bearjhartjen/Lamoka1-half/README.md

<h1 align="center">
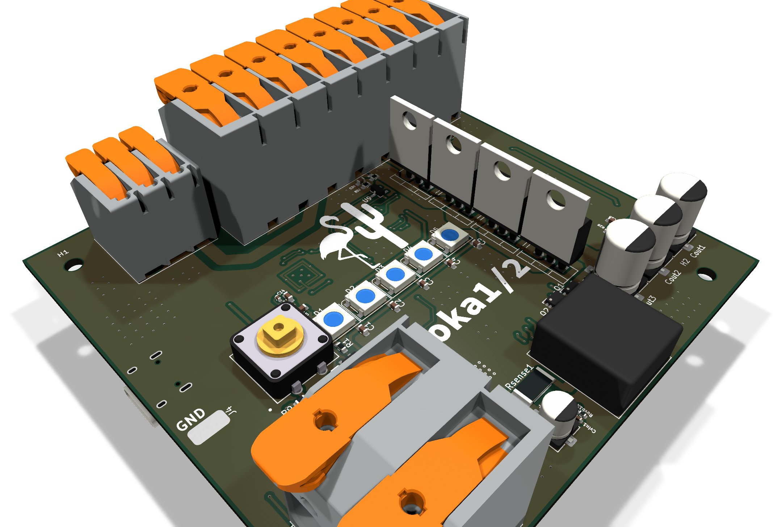
[picture p1: Images/lamoka1-2-render-iso.png]
Lamoka1/2
  
  <br>
  Lamoka1/2
</h1>

<p align="center">
  PIE v1.9 works on this board.
  For more information on PIE, go
  <a href="SOFTWARE/README.md">here</a>.
</p>

<p align="center">
  <a href="https://htmlpreview.github.io/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">
    <strong>View Interactive BOM</strong>
  </a>
</p>

---
