bearjhartjen/Lamoka1-half/HARDWARE/Kicadfiles/Lamoka1-half/Reviews/Tomachie report in depth.txt

Generated by Tomachie v5.142 2026-10-19 23:12:50
Copyright © 2026 Tomachie LLC. All rights reserved.

Lamoka1-half Design Analysis
Job 0a968485
1  Design Summary

  93
  out of 100

Design TypeHierarchical (4 sheets)
Total Components117
Total Pins495
Total Nets84
Total Test Points0

Improve your score:

Improve solder-joint testability (opens/shorts) +2
Add test points on power rails +1
Add test points on switch signals +1
Improve JTAG/I2C/SPI bus accessibility +1
Use IPC-compliant footprint names +1
Add Kelvin 4-wire test points on sense resistors +1

Based on user-selected TP insertion settings, 18 test point(s) were added and a modified design is available for download. Review the modified schematic and resubmit to update this report.
1.1  Processed Sheets

#Sheet Name

1Lamoka1-half.kicad_sch
2Control-section.kicad_sch
3Inversion-section.kicad_sch
4User-Interface-Section.kicad_sch

1.2  Footprint Compliance
Production pick-n-place, AOI, AXI, ATE and Design Quality tools rely on proper descriptions of component footprints.

✗2✓1

Footprint NamingStatus

2 of 42 unique footprints are IPC-7351B or IPC-7251✓
35 SMT footprints do not follow IPC-7351B naming
4 footprints (connectors, specialty) — compliance unknown
1 footprints could not be classified for inspection

2  Component Value Properties
Component values should be in the VALUE property, either as a direct value (e.g. 100nF) or as a formula reference (e.g. =Capacitance). The typed property (Resistance, Capacitance, Inductance, Impedance, etc.) holds the actual electrical value; VALUE should point to it or contain the same data.

✓4

Value Property Check

TypeCheckCountComponentsStatus

CapacitorsValues in VALUE or Capacitance38Cres1, C23, C22, Ccomp2, C32, Cin1, Ccomp1, Coutx1 (+30 more)✓
ResistorsValues in VALUE or Resistance38RCS1, R10, R17, Ruvb1, R18, Rfbb1, R12, Rcomp1 (+30 more)✓
InductorsValues in VALUE or Inductance3L2, L1, L3✓
OscillatorsValues in VALUE or Frequency1X1✓

2.1  Part Number vs Stated Values
Each passive states its electrical facts twice: in the properties the designer set, and encoded inside the MANUFACTURER part number. This check decodes the manufacturer part number and compares the two. A distributor catalogue number is a different thing and cannot be used here - an LCSC C-number or a Digi-Key -ND number identifies a stock item, it encodes no capacitance, voltage or tolerance, so there is nothing in it to check against. Where the two readings disagree both are shown and neither is assumed correct: if VALUE is wrong the analysis used the wrong number, and if the part number is wrong the BOM orders the wrong part. Only the designer knows which field is authoritative. Parts whose numbering scheme is not recognized are reported as not checked rather than passed.

✓26

Part NumberDecoded from Part NumberStated on SchematicWhat DiffersCountComponentsStatus

RC0603FR-0710KLMPN / Yageo RC060310k +/-1% 060310k: R8, R9, R26, R28, R30, R32Nothing - all stated values agree6R8, R9, R26, R28, R30, R32✓ Match
CL10B104KO8NNNCMPN / Samsung Electro-Mechanics100nF 16V +/-10% 0603100n: C1, C2, C3, C4, C5Nothing - all stated values agree5C1, C2, C3, C4, C5✓ Match
CL10B473KB8NNNCMPN / Samsung Electro-Mechanics47nF 50V +/-10% 060347nF: C27, C28, C29, C30Nothing - all stated values agree4C27, C28, C29, C30✓ Match
RC1206FR-0710RLMPN / Yageo RC120610R +/-1% 120610: R10, R12, R17, R18Nothing - all stated values agree4R10, R12, R17, R18✓ Match
25SVPF180MMPN / Panasonic Industry180uF 25V +/-20%180uF: Cout1, Cout2, Cout3Nothing - all stated values agree3Cout1, Cout2, Cout3✓ Match
CL05B104KO5NNNCMPN / Samsung Electro-Mechanics100nF 16V +/-10% 0402100n: C17, C18, C19Nothing - all stated values agree3C17, C18, C19✓ Match
CL10A475KP8NNNCMPN / Samsung Electro-Mechanics4.7uF 10V +/-10% 06034.7u: C14, C15, C16Nothing - all stated values agree3C14, C15, C16✓ Match
0402CG150J500NTMPN / Fenghua (suffix heuristic)15pF 50V +/-5% 040215p: C20, C21Nothing - all stated values agree2C20, C21✓ Match
CL05A106MQ5NUNCMPN / Samsung Electro-Mechanics10uF 6.3V +/-20% 040210u: C12, C13Nothing - all stated values agree2C12, C13✓ Match
CRCW040249K9FKEDMPN / Vishay Dale CRCW040249.9k +/-1% 040249.9k: Rfbt1, Ruvt1Nothing - all stated values agree2Rfbt1, Ruvt1✓ Match
GRM21BR71H105KA12LMPN / Murata1uF 50V +/-10% 08051uF: C22, C23Nothing - all stated values agree2C22, C23✓ Match
RC0402FR-071KLMPN / Yageo RC04021k +/-1% 04021k: R7, R11Nothing - all stated values agree2R7, R11✓ Match
RC0603FR-0727RLMPN / Yageo RC060327R +/-1% 060327: R5, R6Nothing - all stated values agree2R5, R6✓ Match
RC0603FR-0745K3LMPN / Yageo RC060345.3k +/-1% 060345.3k: R29, R31Nothing - all stated values agree2R29, R31✓ Match
RC0603FR-074K7LMPN / Yageo RC06034.7k +/-1% 06034.7k: R23, R24Nothing - all stated values agree2R23, R24✓ Match
RC0603FR-075K1LMPN / Yageo RC06035.1k +/-1% 06035.1k: R2, R3Nothing - all stated values agree2R2, R3✓ Match
08053C104KAT2AMPN / AVX100nF 25V +/-10% 0805100nF: C32Nothing - all stated values agree1C32✓ Match
20SVPF56MXMPN / Panasonic Industry56uF 20V +/-20%56uF: Cin1Nothing - all stated values agree1Cin1✓ Match
AOTA-B201610S3R3-101-TMPN / AOTA AOTA-B201610S3.3uH3.3u: L1Nothing - all stated values agree1L1✓ Match
C1005X5R1V474K050BCMPN / TDK470nF 35V +/-10% 0402470nF: Cvin1Nothing - all stated values agree1Cvin1✓ Match
C3216X5R1E476M160ACMPN / TDK47uF 25V +/-20% 120647uF: Coutx1Nothing - all stated values agree1Coutx1✓ Match
CGA4C2C0G1H392J060AAMPN / TDK (CGA automotive)3.9nF 50V +/-5%3.9nF: Ccomp1Nothing - all stated values agree1Ccomp1✓ Match
CL10A105KA8NNNCMPN / Samsung Electro-Mechanics1uF 25V +/-10% 06031uF: C26Nothing - all stated values agree1C26✓ Match
CL10B104KB8NNNCMPN / Samsung Electro-Mechanics100nF 50V +/-10% 0603100nF: C31Nothing - all stated values agree1C31✓ Match
CRCW0402100KFKEDMPN / Vishay Dale CRCW0402100k +/-1% 0402100k: R21Nothing - all stated values agree1R21✓ Match
+22 more part number(s) cross-checked, all agreeNothing - all stated values agree22✓ Match
ResistorsCSNL2512FT2L002 part(s) carry a manufacturer part number that will be decoded on a paid enriched run, where the value, voltage and tolerance it encodes are checked against the schematic.2RCS1, Rsense1◆

2.2  Part Lifecycle and Silicon Errata
Status as found on the manufacturer's website by the AI enrichment run, on the date shown; the page read is linked. Silicon errata: whether the manufacturer publishes an errata sheet for the part - its presence only. No errata document is read or analysed, and no action is implied by its existence.

Finding accurate?

ItemLifecycleSilicon errataStatus

IC1 (INA240A2DR), U1 (RP2354A), U2 (AMS1117-3.3), U3 (SN74AHCT1G125DBVR), U4 (LM5122MHX/NOPB), U5, U6 (UCC27735DR), U7 (TPS62160DSGR), U8, U9 (TMP235A2DBZR), U10 (ADS7128IRTER)Lifecycle status and errata status determined on an AI enrichmentNot determinedReview
C1, C2, C3, C4, C5 (CL10B104KO8NNNC), C11 (GRM31CR61A107MEA8K), C12, C13 (CL05A106MQ5NUNC), C24 (TMK212BBJ106KG-T), C25 (GRM31CR71A226KE15L), C33 (MSAST21GAB5475MTNAO1), CR1, CR2, D11, D12 (SS14-E3/61T), Cin1 (20SVPF56MX), Cvin1 (C1005X5R1V474K050BC), D1, D2, D3, D4, D5 (WS2812B), D6 (SK215ATR), L2 (XAL1580-182MEB), ...Lifecycle status determined on an AI enrichment—Review
C14, C15, C16 (CL10A475KP8NNNC)There isn't a life-cycle marking on the datasheet obtained 2026-10-13—
C17, C18, C19 (CL05B104KO5NNNC)Active, as of 2026-10-14—
L1 (AOTA-B201610S3R3-101-T)Active, as of 2026-09-05—
X1 (ABM8-272-T3)Active, as of 2026-09-16None found on the manufacturer's website, as of 2026-09-16

3  Pin Connectivity Report
3.1  Unconnected Pins
Unconnected pins that are not marked NO_ERC.
11 unconnected pin(s) found:
11 unconnected pin(s) — all are electrical types that are safe to leave open (Bidirectional, Output, Passive, High-Impedance, or Unspecified). Common on partially-populated bus connectors (VME, backplanes, expansion headers) and on outputs whose consumer was omitted. Review to confirm intent, but no action is required by default.

Refdes_PinPin FunctionPin PropertyDevice TypeNet NameNotes

IC1_4NCUnknownINA240A2DR-No net
J3_SHSHIELDPassiveUSB_C_Receptacle_USB2.0_14PNet-(J3-SHIELD)
R9_1-Passive10kUser-Interface-Section/3v3
U5_8NCUnknownUCC27735DR-No net
U5_9NCUnknownUCC27735DR-No net
U5_10NCUnknownUCC27735DR-No net
U5_14NCUnknownUCC27735DR-No net
U6_8NCUnknownUCC27735DR-No net
U6_9NCUnknownUCC27735DR-No net
U6_10NCUnknownUCC27735DR-No net
U6_14NCUnknownUCC27735DR-No net

3.2  Implied/Hidden Net Connections
Pins with implied net connections not visible on the schematic. Includes Altium HiddenNetName library parameters and KiCad hidden pins of any electrical type stacked behind visible pins in the symbol.

Implied Net Connections

ComponentTypePinNetStatus

U1RP2354A39 (DVDD)Control-Section/1V1Hidden pin not visible on schematic
U1RP2354A11 (IOVDD)Control-Section/3v3Hidden pin not visible on schematic
U1RP2354A20 (IOVDD)Control-Section/3v3Hidden pin not visible on schematic
U1RP2354A23 (DVDD)Control-Section/1V1Hidden pin not visible on schematic
U1RP2354A45 (IOVDD)Control-Section/3v3Hidden pin not visible on schematic
U1RP2354A30 (IOVDD)Control-Section/3v3Hidden pin not visible on schematic
U1RP2354A38 (IOVDD)Control-Section/3v3Hidden pin not visible on schematic
J3USB_C_Receptacle_USB2.0_14PA9 (VBUS)Control-Section/USB-5vHidden pin not visible on schematic
J3USB_C_Receptacle_USB2.0_14PB1 (GND)Net-(J3-GND-PadA1)Hidden pin not visible on schematic
J3USB_C_Receptacle_USB2.0_14PA12 (GND)Net-(J3-GND-PadA1)Hidden pin not visible on schematic
J3USB_C_Receptacle_USB2.0_14PB4 (VBUS)Control-Section/USB-5vHidden pin not visible on schematic
J3USB_C_Receptacle_USB2.0_14PB9 (VBUS)Control-Section/USB-5vHidden pin not visible on schematic
J3USB_C_Receptacle_USB2.0_14PB12 (GND)Net-(J3-GND-PadA1)Hidden pin not visible on schematic

3.3  Open-Collector Pull-up Audit
Examined 1 candidate pin(s) on 1 net(s). 1 passing.

These open-collector / open-drain outputs have a resistor pull-up to a power rail. The pull-up resistor and rail are shown for reference.

NetOC Pin(s)Pull-upRailStatus

Control-Section/PGU7_8 (PG)R21Control-Section/Buck-5v✓

3.4  Diode Polarity / Orientation

Finding accurate?

Diode polarity and orientation are read from the schematic. IPC-7351B (surface mount) / IPC-7251 (through-hole) Zero Component Orientation (ZCO) requires pin 1, the cathode, on the left with the footprint at zero rotation. Tomachie calls out symbols that do not meet ZCO because the PCB layout may have an error, assembly may insert the part backwards, initial ATE test generation from a netlist of only pins 1 and 2 will fail, or a novice may wrongly indict a correct part — consistency is the least-expensive path for everyone who handles the PCB.

DiodeConnectionsOrientationSeverity

D12SS14-E3/61Tunidirectional · pin_names · Schottky RectifierPin 1 (K): HB2Pin 2 (A): CSPConsistent
D6SK215ATRunidirectional · pin_namesPin 1 (K): BSTPin 2 (A): VCCConsistent
D11SS14-E3/61Tunidirectional · pin_names · Schottky RectifierPin 1 (K): HB1Pin 2 (A): CSPConsistent
CR1SS14-E3/61Tunidirectional · symbol_graphic · Schottky RectifierPin 1 (K): Control-Section/5VPin 2 (A): Control-Section/USB-5vConsistent
CR2SS14-E3/61Tunidirectional · symbol_graphic · Schottky RectifierPin 1 (K): Control-Section/5VPin 2 (A): Control-Section/Buck-5vConsistent
D1WS2812Barray · multi-pinPin 1 (VDD): Control-Section/5VPin 2 (DOUT): Net-(D1-DOUT)Pin 3 (VSS): GNDPin 4 (DIN): Net-(D1-DIN)4-pin diode package will need to be checked against the datasheet in one of the AI enrichment sections.Information
D5WS2812Barray · multi-pinPin 1 (VDD): Control-Section/5VPin 2 (DOUT): -Pin 3 (VSS): GNDPin 4 (DIN): Net-(D4-DOUT)4-pin diode package will need to be checked against the datasheet in one of the AI enrichment sections.Information
D2WS2812Barray · multi-pinPin 1 (VDD): Control-Section/5VPin 2 (DOUT): Net-(D2-DOUT)Pin 3 (VSS): GNDPin 4 (DIN): Net-(D1-DOUT)4-pin diode package will need to be checked against the datasheet in one of the AI enrichment sections.Information
D3WS2812Barray · multi-pinPin 1 (VDD): Control-Section/5VPin 2 (DOUT): Net-(D3-DOUT)Pin 3 (VSS): GNDPin 4 (DIN): Net-(D2-DOUT)4-pin diode package will need to be checked against the datasheet in one of the AI enrichment sections.Information
D4WS2812Barray · multi-pinPin 1 (VDD): Control-Section/5VPin 2 (DOUT): Net-(D4-DOUT)Pin 3 (VSS): GNDPin 4 (DIN): Net-(D3-DOUT)4-pin diode package will need to be checked against the datasheet in one of the AI enrichment sections.Information

3.5  Power Symbols That Connect Nothing
4 power symbol placement(s) connect nothing: the placed symbol has no library definition in the schematic file, or its definition has no power pin. A power symbol joins all same-named rails across the design; an inert one leaves them separate. Where the last column lists more than one net, those nets were meant to be one rail and are NOT connected. Restore the power symbol's library definition (re-place it from a maintained library) and verify the rails merge.

Power NetLibrary CellPlacementsNets Left Separate

LOGOFlamingo&Cactus-logo:LOGO4 (Lamoka1-half.kicad_sch, Inversion-section.kicad_sch, Control-section.kicad_sch, User-Interface-Section.kicad_sch)-

3.6  Checks Not Performed
Items this report did not check, with the reason. None of these is a finding against the design - an item that was not checked says nothing about it either way.
Note 1: This check was not performed because this is a preliminary run. An AI enrichment run is needed a) for the analysis and b) to obtain the datasheet from public sources, or from the "datasheets" subfolder of the project when the user supplies it because no public source exists.

ItemNot checkedNotes

Capacitor Derating CheckNot performed on preliminary runSee note 1
CR1 (SS14-E3/61T)Power analysis not performed on preliminary runSee note 1
CR2 (SS14-E3/61T)Power analysis not performed on preliminary runSee note 1
D1 (WS2812B)Power analysis not performed on preliminary runSee note 1
D2 (WS2812B)Power analysis not performed on preliminary runSee note 1
D3 (WS2812B)Power analysis not performed on preliminary runSee note 1
D4 (WS2812B)Power analysis not performed on preliminary runSee note 1
D5 (WS2812B)Power analysis not performed on preliminary runSee note 1
D6 (SK215ATR)Power analysis not performed on preliminary runSee note 1
D11 (SS14-E3/61T)Power analysis not performed on preliminary runSee note 1
D12 (SS14-E3/61T)Power analysis not performed on preliminary runSee note 1
IC1 (INA240A2DR)Power analysis not performed on preliminary runSee note 1
Q2 (CSD17304Q3)Power analysis not performed on preliminary runSee note 1
Q5 (CSD19536KCS)Power analysis not performed on preliminary runSee note 1
Q6 (CSD19536KCS)Power analysis not performed on preliminary runSee note 1
U2 (AMS1117-3.3)Power analysis not performed on preliminary runSee note 1
U4 (LM5122MHX/NOPB)Power analysis not performed on preliminary runSee note 1
U5 (UCC27735DR)Power analysis not performed on preliminary runSee note 1
U6 (UCC27735DR)Power analysis not performed on preliminary runSee note 1
U7 (TPS62160DSGR)Power analysis not performed on preliminary runSee note 1
Q1 (CSD16323Q3)Functional analysis not performed on preliminary runSee note 1
Q3 (CSD19536KCS)Functional analysis not performed on preliminary runSee note 1
Q4 (CSD19536KCS)Functional analysis not performed on preliminary runSee note 1
U1 (RP2354A)Functional analysis not performed on preliminary runSee note 1
U3 (SN74AHCT1G125DBVR)Functional analysis not performed on preliminary runSee note 1
U8 (TMP235A2DBZR)Functional analysis not performed on preliminary runSee note 1
U9 (TMP235A2DBZR)Functional analysis not performed on preliminary runSee note 1
U10 (ADS7128IRTER)Functional analysis not performed on preliminary runSee note 1
X1 (ABM8-272-T3)Functional analysis not performed on preliminary runSee note 1
RCS1, Rsense12 part(s) use 1 numbering scheme(s) whose ordering information could not be obtained in this run, so their value, voltage and tolerance were not cross-checked against the part number. Nothing is wrong with these parts.

3.7  Designer Notes
These notes will be supplied on an AI enrichment.
Assign each note to a device or a net name rather than leaving it as free-floating text, for example "Q1 = Vgs = 1.8V" or "VCC_IN = 4.5 to 5V". Avoid "current here = 1mA" or "current = 1mA": "here" is not understood, the second does not say where the current is, and Tomachie does not use the position of text on the sheet to guess what it refers to.

SheetNotes

Control-section11-14v to 5v
Control-sectionDiode-Power OR-ing
Inversion-section11-14v to 17v
Lamoka1-halfThis is the output of the transformer,
Lamoka1-halfWago-connector 2606-1108/010-000
Lamoka1-halfWago-connector 2604-1103
Lamoka1-halfWago-connector 2606-1352
Lamoka1-halfwe will be hooking it up to a NEMA 5-15 plug.

3.8  Summary

Total NO_ERC markers in design34
Pins needing attention (warnings)11
Pins for information only0

4  Power Overview

Power rails12
Power management sources identified6

Power architecture overview. For test point coverage, see Design-for-Test section.
4.1  Power Rail Analysis

Power Rails

RailVoltageSourceConsumers

Control-Section/5V5.00VJ3ExternalU2 (AMS1117-3.3),U3 (SN74AHCT1G125DBVR)
Control-Section/Buck-5v5.00VU7TPS62160DSGR-
Control-Section/USB-5v5.00VJ3External-
Control-Section/3v33.30VU2AMS1117-3.3U1 (RP2354A),U10 (ADS7128IRTER),U8/U9 (TMP235A2DBZR)
Control-Section/1V11.10V-U1 (RP2354A)
+BATT-J2ExternalIC1 (INA240A2DR)
CSP--IC1 (INA240A2DR),U4 (LM5122MHX/NOPB),U5/U6 (UCC27735DR),U7 (TPS62160DSGR)
GND---
GND-J2External-
GND-J4External-
VCC--U4 (LM5122MHX/NOPB)
VIN--U4 (LM5122MHX/NOPB)

4.1.1  Rail Voltage Annotation
2 power input(s) into this board were identified - the supplies it takes in at a connector, a terminal or a module socket. Every part on and downstream of each one is judged against what it carries, so the analysis needs its full characterization: whether it is AC or DC, its nominal voltage, the band it operates over, and any level outside normal operation the design must survive.
The preferred way to state a rail's voltage is to record it in the design itself, where it travels with the schematic, survives every re-run, and can be read by anyone who opens the design: add VOLTAGE_NOM, VOLTAGE_MIN and VOLTAGE_MAX properties to the rail's net class directive, and VOLTAGE_EXCURSION_MAX for a survivable level outside normal operation.
You will be prompted to enter each input's nominal, minimum and maximum operating voltage - and, where one exists, the survivable excursion level - before the AI review starts.

RailRequired information

Control-Section/USB-5vUSB-C default values will be 5.00 V nominal, 4.75 V minimum, 5.50 V maximum.
+BATTState whether this input is AC or DC, its nominal voltage, and the minimum and maximum it operates over. For example: DC, nominal 5.0 V, minimum 4.75 V, maximum 5.25 V; or for a battery, DC, minimum 3.0 V, maximum 4.2 V. If it can reach a higher sustained level outside normal operation - a charging overvoltage or a jump-start the design must survive but need not function at - state that separately as the excursion maximum; it is never treated as an operating voltage.

4.2  Regulator Enable Pull Resistors
2 regulator enable pin(s) examined for what drives them and which way they are pulled. 0 pulled toward the enabling level while a power output drives the net.

Finding accurate?

FindingSeverity

RegulatorU4 [LM5122MHX/NOPB]Enable pinU4_6 (UVLO)NetUVLODriven by-Pull-upRuvt1 49.9k -> CSPPull-downRuvb1 7.15k -> GNDNo driver on the net; the pull resistor sets the level.InformationIntent
RegulatorU7 [TPS62160DSGR]Enable pinU7_3 (EN) (enabled high)NetCSPDriven by-Pull-up-Pull-down-The enable is wired to CSP; the regulator is always enabled.InformationIntent

5  Connector Pinouts

Total connectors6

5.1  J1 2606-1108/010-000

J1 - 2606-1108/010-000

PinPin NameNetNotes

11BLUE
22BLUE
33BROWN
44BROWN
55BLACK
66BLACK
77RED
88RED

5.2  J2 2606-1352

J2 - 2606-1352

PinPin NameNetNotes

11_1+BATT
21_2+BATT
32_1GND
42_2GND

5.3  J3 TYPE-C-31-M-12

J3 - TYPE-C-31-M-12 (TYPE-C-31-M-12)

PinPin NameNetNotes

A1GNDNet-(J3-GND-PadA1)
A4VBUSControl-Section/USB-5v
A5CC1Control-Section/CC1
A6D+Control-Section/D+
A7D-Control-Section/D-
A9VBUSControl-Section/USB-5v
A12GNDNet-(J3-GND-PadA1)
B1GNDNet-(J3-GND-PadA1)
B4VBUSControl-Section/USB-5v
B5CC2Control-Section/CC2
B6D+Control-Section/D+
B7D-Control-Section/D-
B9VBUSControl-Section/USB-5v
B12GNDNet-(J3-GND-PadA1)
SHSHIELDNet-(J3-SHIELD)

5.4  J4 FAN GND

J4 - FAN GND

PinPin NameNetNotes

1Pin_1GND

5.5  J5 2604-1103

J5 - 2604-1103

PinPin NameNetNotes

11_1AC_OUT_A
21_2AC_OUT_A
32_1GND
42_2GND
53_1Net-(J5-3_1)
63_2Net-(J5-3_1)

5.6  J6 FAN 5V

J6 - FAN 5V

PinPin NameNetNotes

1Pin_1Control-Section/Buck-5v

6  Indicator Documentation
5 indicator device(s) found.
6.1  Indicator Assignments

Indicators

RefDesTypeColorSignalSheetNotes

D1WS2812BRGBNet-(D1-DIN)User-Interface-Section.kicad_schSmart LED (serial), chain D1 -> D5, position 1 of 5
D5WS2812BRGBNet-(D4-DOUT)User-Interface-Section.kicad_schSmart LED (serial), chain D1 -> D5, position 5 of 5
D2WS2812BRGBNet-(D1-DOUT)User-Interface-Section.kicad_schSmart LED (serial), chain D1 -> D5, position 2 of 5
D3WS2812BRGBNet-(D2-DOUT)User-Interface-Section.kicad_schSmart LED (serial), chain D1 -> D5, position 3 of 5
D4WS2812BRGBNet-(D3-DOUT)User-Interface-Section.kicad_schSmart LED (serial), chain D1 -> D5, position 4 of 5

6.2  Indicator Testability
0 of 0 indicators have test coverage. 1 smart-LED chain(s) with 5 devices documented below.

LED Chain D1 → D5 (WS2812B x 5)

ItemStatus

ChainD1 → D2 → D3 → D4 → D5
Chain InputNet-(D1-DIN) — no test point → D1_4
Terminal DOUTD5 DOUT (D5_2) — NO CONNECT, not observable. Not currently scored; planned to affect the DFT score beginning 2027-01-01.
Chain DFTThe chain end must be observable: with the chain input and D5 DOUT (D5_2) observable, one observation tests every device in the chain; a test point per LED is not required.
RecommendationObserve D5 DOUT (D5_2): test point or loopback to a spare MCU input.

7  Switch Documentation
1 switch(es) found in design.
7.1  Switch Configurations

  A
  B

SW1 Contact Pairs (B3F-4055)

ContactPin ANet APin BNet BWhen OpenWhen ClosedNotes

11Control-Section/BTN3GNDSIGNALLOW

SW1 All Pins

Pin #Pin NameNetPaired WithType

11Control-Section/BTN3CONTACT
22Control-Section/BTN3CONTACT
33GND1CONTACT
44GND1CONTACT

7.2  Switch DFT Analysis
Switches for mode selection are useful for development and manual debug, but production test environments require electrical override capability. A latching switch (DIP, slide, toggle) holds the signal at the rail it closes onto until somebody moves it, so ATE cannot drive past the contact: it needs a test point and a series isolation resistor between the switch and that rail. A momentary switch (push button) does not hold the signal — the bias resistor sets the level again as soon as the button is released — so it needs only a test point for ATE stimulus access.

  IC

    VCC
    R_pullup
    TP
    SW
    Rs
    GND

Design Rationale: Switches for mode selection are valuable for engineering development and bench debug. However, production test and field returns require electrical override capability without manual intervention. Adding test points and isolation resistors creates a lifecycle-robust design that works across development, production test, and field returns without requiring procedure documentation or specialized knowledge of switch positions. The goal is a self-documenting, procedure-proof test interface. BOM impact: One 0201/0402 resistor per controlled signal.

SwitchSignalFunctionPullupRailIssueTest Point?

SW1Net-(U1-QSPI_SS)Switch-controlled signal(not found)GNDNo test point + Existing isolation R7 — add TP on Net-(U1-QSPI_SS)

8  Low-Speed Serial Interfaces (LSSI)
Detected: 1 I2C
8.1  I2C

I2C: U1 -> U10
Topology: U1 » Targets (U10)

SignalNet NameConnectorTest PointTarget Pin

SCLControl-Section/GPIO9 / GPIO9(none)(none)U1_13 (GPIO9), U10_13 (SCL)
SDAControl-Section/GPIO8 / GPIO8(none)(none)U1_12 (GPIO8), U10_14 (SDA)
AddressTargetIndustry TypeDescription
0x10 (port I2C (SCL on Control-Section/GPIO9), strap-set address, ADDR=open (no table row for a floating pin)) [base address - select pin level not determined]U10ADS7128IRTER

I2C Pull-up Check

NetComponentStatus

Control-Section/GPIO8R23Pull-up resistor 4.7K (R23) found on SDA✓
Control-Section/GPIO9R24Pull-up resistor 4.7K (R24) found on SCL✓

8.2  LSSI DFT Analysis
2 signal(s) missing test point coverage. Test points allow ATE to run tests without requiring operator intervention and setup. They should be considered mandatory for high volume products.
During test, ATE can override functional operation to explicitly test through the interface in ways that functional operation cannot, or is not available at certain test stages.

Missing Test Points

SignalNet NameConnectorInterface

SCLControl-Section/GPIO9(none)I2C: U1 -> U10
SDAControl-Section/GPIO8(none)I2C: U1 -> U10

9  High-Speed Serial Interfaces (HSSI)
4 differential pair(s)
Differential pairs detected from _P/_N naming convention which KiCad uses for differential pair identification. Designer should consider explicit assignment to distinct net classes for each SERDES type to explicitly document layout intent.
1 USB differential pair(s) have no controlled-impedance net class assigned. Assign a 90 Ohm differential net class so the impedance intent carries into PCB layout and length tuning.
9.1  Differential Pairs
Differential pairs with designer-specified class annotations.
None of the 4 differential pairs specify a target impedance (the Impedance column is blank). Strongly suggested: put the value in the class name - e.g. 100_OHM, 90_OHM, 50_OHM. The pairs are already identified by their nets, so the ohm value is the useful part to capture for layout.

Differential Pairs

Net NameClassImpedanceNotes

CSNDIFF_PAIR
CSPDIFF_PAIR
Control-Section/D+USB
Control-Section/D-USB

10  Memory Interface Analysis
No memory devices with detectable bus interfaces found.
11  Functional Analysis
10 device(s) to review across 2 category(ies)
Reset-time strap configuration for U1 (RP2354A) - the boot settings each device samples from the board's resistors, checked against its datasheet for invalid selections - is included with the AI-assisted run.

Device Inventory

RefDesCategoryPart NumberDescriptionInterfacesHSSI

NT1DEVICENetTie_2Net tie, 2 pins--
U1DEVICERP2354AA microcontroller by Raspberry Pi, dual CPU architecture (ARM Cortex-M33 / RISC-V Hazard3), 150MHz, 2MB flash, 520KB SRAM, 12 PIO state machines, VQFN-60I2C-
U10DEVICEADS7128IRTERI2C-
U3DEVICESN74AHCT1G125DBVRSingle Buffer Gate Tri-State, Low-Voltage CMOS--
U8DEVICETMP235A2DBZR--
U9DEVICETMP235A2DBZR--
X1DEVICEABM8-272-T3--
Q1Trans.CSD16323Q3--
Q3Trans.CSD19536KCSN-channel NexFET power MOSFET, 100V 150A, TO-220 (1=G 2=D 3=S)--
Q4Trans.CSD19536KCSN-channel NexFET power MOSFET, 100V 150A, TO-220 (1=G 2=D 3=S)--

12  Designer Annotated Nets

Annotated signals3

Designer-placed annotation markers on nets that are not already analyzed as HSSI differential pairs or Memory Bus signals.

Designer Annotations

Net NameAnnotationImpedanceNotes

GNDGND
GNDGND
GNDGND

13  EMC & ESD Protection Checks

Checks run1
Passed1
Issues found0

EMC Check Summary

CheckIssuesStatus

Connector Shell Grounding0✓

13.1  ESD/TVS Protection Audit
Audit of connector-facing signal nets for ESD/TVS protection presence and orientation correctness.
Connector-facing signal nets analyzed: 5 connector-facing signal(s). 0 protected, 3 unprotected, 2 to review, 0 orientation issue(s).
13.1.1  Unprotected Signal Nets

Signal NetConnectorStatus

Control-Section/CC2J3No ESD Protection
Net-(J3-GND-PadA1)J3No ESD Protection
Control-Section/CC1J3No ESD Protection

13.1.2  Protected Signal Nets

Signal NetConnectorProtection DeviceDevice TypeRail ConnectionOrientationStatus

Control-Section/D+J3——Review: no transformer on the board between J3 and U1, so the isolation is expected inside J3 (integrated magnetics); J3's datasheet confirms it on the AI run
Control-Section/D-J3——Review: no transformer on the board between J3 and U1, so the isolation is expected inside J3 (integrated magnetics); J3's datasheet confirms it on the AI run

14  Design-for-Test
Design for Testability (DFT) analysis for ICT/bed-of-nails test coverage.
14.1  DFx Options Selected

OptionSettingDescription

Test Point Insertion
Insert on power railsYesPlace test points on power rail nets in schematic
Insert on LSSI busesYesPlace test points on every LSSI bus signal (JTAG, SWD, I2C, I3C, MDIO, SPI, QSPI, UART) that has none
Insert on all netsNoExtend TP insertion to signal nets beyond power rails
Insert on feedback pinsYesPlace a test point on each regulator feedback / set net that has none, so its divider can be checked
Insert on power-good netsNoPlace a test point on each used power-good net that has none and no boundary scan
Insert on NVM programming netsNoPlace test points on the nets used to program on-board memory (QSPI, etc.)
Exclude HSSI netsYesExclude HSSI/differential pair nets from TP insertion
Exclude DRAM netsYesExclude SDRAM/DDR nets from TP insertion
Exclude BSCAN opens (full)YesExclude nets with 100% boundary scan opens coverage
Exclude BSCAN opens (partial)NoExclude nets with partial boundary scan opens coverage
Exclude BSCAN shortsNoExclude nets with boundary scan shorts coverage
GND test points6Number of GND test points to insert for BON fixture ground connections
Target PCOLA-SOQ0%Insert TPs in priority order until this PCOLA-SOQ % is reached
Target solder-joint testability0%Insert TPs in priority order until this shorts/opens solder-joint testability % is reached
Kelvin min resistance0.000 ohmLower bound (ohms) for Kelvin 4-wire TP insertion range
Kelvin max resistance1.000 ohmUpper bound (ohms) for Kelvin 4-wire TP insertion range
Tester Styles
OpticalAOIAutomated Optical Inspection of visible solder joints
AXIYesAutomated X-ray Inspection of hidden solder joints (BGA, QFN)
ATEFlying_probeDigital IO, DMM, shorts/opens via flying probe
Test Access
JTAG/LSSI ConnectorYesConnector access to JTAG, SPI, I2C buses
IO ConnectorsNoIO connectors available for external stimulus/observation
TP AccessFlying_probeFlying probe access without fixture
Test Point Identification
BON TP refdesTP#,TP-*,TP_*,TP#*Refdes patterns identifying BON test points
BON TP footprints*All footprints accepted
FP TP refdesTP#,TP-*,TP_*,TP#*,MP#Refdes patterns identifying flying probe test points
FP TP footprints*All footprints accepted
LoopbackNoneNo loopback cables
Test Types
Powered-Off Shorts/OpensYesUnpowered shorts and opens detection via probe access
PassivesYesR, C, L value measurement via probe or fixture access
Active AnalogNoVoltage regulator, reference, and op-amp output verification
Non-BSCAN DigitalNoDigital ICs without boundary scan: pin observability analysis
Boundary Scan1149.1_1149.6IEEE 1149.1-2001 + 1149.6-2003 AC boundary scan
LSSINoJTAG chain, SPI, I2C, UART bus test coverage analysis
JTAG FunctionalNoFunctional verification beyond structural scan
Require Rail TPs for Diode TestNoRequire TPs on all IO power rails for ESD diode opens test (default: basic test with GND TP only)
Capacitance Probe Plate Target Devices—Refdes or footprint patterns for capacitance probe plate targets (ICs and vertical connectors)
Use Boundary Scan for Capacitance Probe Plate StimulusNoCount boundary scan drive cells on other devices as valid stimulus for the capacitance probe plate (applicable to VTEP / IEEE 1149.8.1-capable hardware)
NVM Programming
Default MethodDirectProgram via direct pin access; TPs on flash data/control lines
Environment
Test environmentlabPrototype/NPI: manual probing, bench JTAG, longer test times acceptable

14.2  Power Rail Test Point Check

Power rails found12
Rails with TPs2
Rails without TPs10
With designer annotation3

Parts adjudicated as TH: J2 (2606-1352), J5 (2604-1103), J1 (2606-1108/010-000). Their description and footprint do not say how they mount, so the mounting was looked up. If any is wrong, state SMT or TH/THT/THRU in the part's description.
10 power rail(s) need test points in the submitted design.
18 test point(s) inserted in modified output. Download modified schematics to see placements.
1 net(s) could not be fitted with test points. Designer action may be needed.

✗10✓2

Power Rail Coverage

Net NameAnnotationTest PointStatus

+BATTJ2_1, J2_2 (through-hole)✓
CSPJ2_1, J2_2 (through-hole) on +BATT, across RCS1✓
Control-Section/1V1- NEEDS TP
Control-Section/3v3- NEEDS TP
Control-Section/5V- NEEDS TP
Control-Section/Buck-5v- NEEDS TP
Control-Section/USB-5v- NEEDS TP
GNDGND- NEEDS TP
GNDGND- NEEDS TP
GNDGND- NEEDS TP
VCC- NEEDS TP
VIN- NEEDS TP

Inserted Test Points (Modified Output)

Test PointNetSheet

TP1Control-Section/1V1Control-section.kicad_sch
TP2Control-Section/3v3Control-section.kicad_sch
TP3Control-Section/Buck-5vControl-section.kicad_sch
TP4Control-Section/USB-5vControl-section.kicad_sch
TP9VINInversion-section.kicad_sch
TP11VCCInversion-section.kicad_sch
TP12Control-Section/5VLamoka1-half.kicad_sch
TP13GNDUser-Interface-Section.kicad_sch
TP14GNDUser-Interface-Section.kicad_sch
TP15GNDUser-Interface-Section.kicad_sch
TP16GNDUser-Interface-Section.kicad_sch
TP17GNDUser-Interface-Section.kicad_sch
TP18GNDUser-Interface-Section.kicad_sch

Signal Net Test Points (Modified Output)

Test PointNetSheet

TP5Net-(U1-QSPI_SS)Control-section.kicad_sch
TP6Net-(U7-FB)Control-section.kicad_sch
TP7Control-Section/GPIO8Control-section.kicad_sch
TP8Control-Section/GPIO9Control-section.kicad_sch
TP10FBInversion-section.kicad_sch

TP Insertion Failures

Net NameSheetReason

GNDLamoka1-half.kicad_schInsufficient space for test point placement

14.3  IC Enable Test Point Check
ICs with enable pins (power switches, regulators, etc.) require test points for fixture-based test to disable the device during test.

ICTypePin NamePin #Issue

U7TPS62160DSGREN3tied to VCC - recommend pull-up resistor and test point

14.4  Unconnected 2-Pin Passives
Fitted 2-pin passives (capacitors, resistors, inductors) with a pin that reaches no net. These may be intentional unused or spare footprints, but each is pointed out for review.

ICTypeIssue

R910kPin R9.1 reaches no net - verify this is an intended unused footprint.

14.5  Kelvin Test Points Check

Threshold0.000 < R ≤ 1.000 Ω
Current sense resistors found2

  Pin 1
  Pin 2

  R sense

  TP

  TP

  TP

  TP

  I

  MV
  I = Force Current
  MV = Measure Voltage

2 resistor(s) need test points for Kelvin test

RefDesValueTP Pin1TP Pin2Need Pin1Need Pin2Status

RCS12m00+2+2
Rsense12m00+2+2

14.6  Current Test Points

Total test points0

No test points found in design.
14.7  Powered-off Testing
No nets with BON test points detected.
14.8  Powered-on Testing
No power rail nets have BON test points.
14.9  Boundary Scan Testability
No boundary scan capable devices were found in this design.
14.10  Inspection
Total: 112 components, 410 of 418 pins with inspection coverage.
14.10.1  AOI

IPC Compliant Footprints
Visible-joint components with IPC compliant footprints. Package type structurally verified from footprint name.

FootprintSize (mil)Pkg TypeClassificationMethodCountPinsRefdes

Opens + Shorts (all joints visible)
INA240A2DR
SOIC127P600X175-8NSOIC/SOPIPC-7351B18IC1
TMK212BBJ106KG-T
CAPC2114X145N2.1 x 1.4Chip PassiveIPC-7351B12C24
Subtotal: 2 components, 10 pins

Package Identified from the Footprint Name (Non-IPC Footprints)
Footprint names are not IPC-7351B or IPC-7251, but each one names its package: a chip size code (0201 or larger) or a package name such as SOT, SOIC or QFP. These solder joints count toward inspection coverage.

FootprintSize (mil)Pkg TypeClassificationMethodCountPinsRefdes

Opens + Shorts (all joints visible)
UCC27735DR
SOIC_14L_TEXSOIC/SOPFootprint228U5, U6
Lamoka1-half
SOT-223-3_TabPin2SOT (Small Outline Transistor)Footprint14U2
Package_TO_SOT_SMD
SOT-23-5SOT (Small Outline Transistor)Footprint15U3
CRCW0402100KFKED
RES_CRCW_0402_VISChip PassiveFootprint size12R21
CRCW0402953KFKED
RC0402N_VISChip PassiveFootprint size12R20
Capacitor_SMD
C_0402_1005MetricChip PassiveFootprint size1020C12, C13, C17, C18, C19, C20, C21, Ccomp2 ...+2 more
C_0603_1608MetricChip PassiveFootprint size1428C1, C14, C15, C16, C2, C26, C27, C28 ...+6 more
C_0805_2012MetricChip PassiveFootprint size612C22, C23, C32, C33, Ccomp1, Cres1
C_1206_3216MetricChip PassiveFootprint size24C11, Coutx1
Lamoka1-half
R_0603_1608MetricChip PassiveFootprint size12R24
RC0603FR-07180KL
RC0603N_YAGChip PassiveFootprint size36R19, R2, R3
Resistor_SMD
R_0201_0603MetricChip PassiveFootprint size24Rcomp1, Rslope1
R_0402_1005MetricChip PassiveFootprint size816R11, R7, Rfbb1, Rfbt1, Rt1, Ruvb1, Ruvt1, Rvin1
R_0603_1608MetricChip PassiveFootprint size1632R1, R23, R25, R26, R27, R28, R29, R30 ...+8 more
R_1206_3216MetricChip PassiveFootprint size510R10, R12, R17, R18, Rsense1
R_2512_6332MetricChip PassiveFootprint size12RCS1
Subtotal: 74 components, 177 pins

Assumed Classification (Non-IPC Footprints)
Footprint names are not IPC-7351B or IPC-7251. Package type inferred from Pkg Type property or designator prefix. Classification may be incorrect.

FootprintSize (mil)Pkg TypeClassificationMethodCountPinsRefdes

Opens + Shorts (all joints visible)
Lamoka1-half
DSG8_1P6X0P9SOIC/SOPDesignator19U7
PWP0020A_NSOIC/SOPDesignator121U4
TMP235A2DBZR
DBZ0003A-IPC_ASOIC/SOPDesignator26U8, U9
Lamoka1-half
DQG0008ASOT (Small Outline Transistor)Designator218Q1, Q2
Package_TO_SOT_THT
TO-220-3_VerticalSOT (Small Outline Transistor)Designator412Q3, Q4, Q5, Q6
AOTA-B201610S3R3-101-T
AOTAB201610S3R3101TChip PassiveDesignator12L1
Capacitor_SMD
CP_Elec_5x5.9Chip PassiveDesignator12Cin1
GRM31CR71A226KE15L
G-31_MURChip PassiveDesignator12C25
Inductor_SMD
L_Coilcraft_XAL1580-182Chip PassiveDesignator12L2
Lamoka1-half
CP_Elec_8x11.9_Cout1Chip PassiveDesignator12Cout1
CP_Elec_8x11.9_Cout2Chip PassiveDesignator12Cout2
CP_Elec_8x11.9_Cout3Chip PassiveDesignator12Cout3
IND_PA4332.222NLT_PULChip PassiveDesignator12L3
Diode_SMD
D_SMASOD (Diode Package)Designator36D11, D12, D6
LED_SMD
LED_WS2812B_PLCC4_5.0x5.0mm_P3.2mmSOD (Diode Package)Designator520D1, D2, D3, D4, D5
Lamoka1-half
DO-214AC_VISSOD (Diode Package)Designator24CR1, CR2
Subtotal: 28 components, 112 pins
Presence check (manual verification)
Connector_USB
USB_C_Receptacle_HRO_TYPE-C-31-M-12ConnectorDesignator115J3
Lamoka1-half
CONN2_2606-1352_WAGConnectorDesignator14J2
CONN3_2604-1103_WAGConnectorDesignator16J5
CONN8_2606-1108&slash_010-000_WAGConnectorDesignator18J1
Subtotal: 4 components, 33 pins

14.10.2  AXI

Package Identified from the Footprint Name (Non-IPC Footprints)
Footprint names are not IPC-7351B or IPC-7251, but each one names its package (QFN, DFN, BGA or LGA). These hidden joints count toward X-ray inspection coverage.

FootprintSize (mil)Pkg TypeClassificationMethodCountPinsRefdes

ADS7128IRTER
WQFN16_RTE_TEXQFN/DFN (No-Lead)Footprint117U10
Package_DFN_QFN
QFN-60-1EP_7x7mm_P0.4mm_EP3.4x3.4mmQFN/DFN (No-Lead)Footprint161U1
Subtotal: 2 components, 78 pins

14.10.3  Unclassified Components

These components could not be classified for inspection. The library symbol lacks a Pkg Type property and the footprint name is not IPC-7351B or IPC-7251.

FootprintSize (mil)Pkg TypeClassificationMethodCountPinsRefdes

ABM8-272-T3
ABM8272T3Oscillator / CrystalDesignator14X1
B3F-4055
SW_B3F-4050_OMRUnclassifiedUnknown14SW1
Subtotal: 2 components, 8 pins

14.11  Solder-Joint Testability
Predicted status of each pin for shorts and opens based on DFx options selected in section 13.1.
14.11.1  Solder-Joint Testability Summary

Solder-Joint Testability Summary (422 solder joints)

Test MethodOpensShorts

X-ray (AXI)78 (18.5%)78 (18.5%)
Optical (AOI)187 (44.3%)187 (44.3%)
Electrical
   Powered-off Testing0 (0.0%)0 (0.0%)
   Boundary Scan0 (0.0%)0 (0.0%)
   LSSI--
   Total0 (0.0%)171 (40.5%)
Total Solder-Joint Testability265 (62.8%)327 (77.5%)
No coverage157 (37.2%)95 (22.5%)

14.11.2  Untestable Solder Joints (95)

Export to Excel

These pins have no electrical, optical, or X-ray test coverage even with all available test techniques applied.

Pin ⇅Net ⇅

J5_1AC_OUT_A
J5_2AC_OUT_A
J5_5Net-(J5-3_1)
J5_6Net-(J5-3_1)
J1_1BLUE
J1_2BLUE
J1_3BROWN
J1_4BROWN
J1_5BLACK
J1_6BLACK
J1_7RED
J1_8RED
J3_A1Net-(J3-GND-PadA1)
J3_A4Control-Section/USB-5v
J3_A5Control-Section/CC1
J3_A6Control-Section/D+
J3_A7Control-Section/D-
J3_A9Control-Section/USB-5v
J3_A12Net-(J3-GND-PadA1)
J3_B1Net-(J3-GND-PadA1)
J3_B4Control-Section/USB-5v
J3_B5Control-Section/CC2
J3_B6Control-Section/D+
J3_B7Control-Section/D-
J3_B9Control-Section/USB-5v
J3_B12Net-(J3-GND-PadA1)
J3_SHNet-(J3-SHIELD)
Q3_1Q3G
Q3_2G4D
Q3_3BLUE
Q4_1Q4G
Q4_2G4D
Q4_3BROWN
U9_2Control-Section/TEMP_INV
Q5_1Q5G
Q5_2BLUE
U4_1
U4_3CSN
U4_6UVLO
U4_7SS
U4_8SYNCIN_RT
U4_10FB
U4_11COMP
U4_12SLOPE
U4_14RES
U4_16LO
U4_18SW
U4_19HO
U4_20BST
D12_1HB2
Cout1_1G4D
D6_1BST
Q2_4LO
Q2_5SW
Q2_6SW
Q2_7SW
Q2_8SW
Q2_9SW
Q6_1Q6G
Q6_2BROWN
Q1_1SW
Q1_2SW
Q1_3SW
Q1_4HO
Q1_5G4D
Q1_6G4D
Q1_7G4D
Q1_8G4D
Q1_9G4D
Cout3_1G4D
L2_1CSN
L2_2SW
Cout2_1G4D
D11_1HB1
CR1_2Control-Section/USB-5v
U7_5Net-(U7-FB)
U7_7Net-(U7-SW)
U7_8Control-Section/PG
L1_1Net-(U1-VREG_LX)
X1_1Control-Section/XIN
X1_3Net-(C20-Pad1)
L3_2Net-(U7-SW)
U8_2Control-Section/TEMP_CTRL
SW1_1Control-Section/BTN
SW1_2Control-Section/BTN
D1_2Net-(D1-DOUT)
D1_4Net-(D1-DIN)
D5_2
D5_4Net-(D4-DOUT)
D2_2Net-(D2-DOUT)
D2_4Net-(D1-DOUT)
D3_2Net-(D3-DOUT)
D3_4Net-(D2-DOUT)
D4_2Net-(D4-DOUT)
D4_4Net-(D3-DOUT)

14.11.3  Per-Solder-Joint Testability Matrix
● = Detected  ◐ = Partially detected  - = Not tested   |   E = Electrical (ICT/flying probe)  O = Optical (AOI)  X = X-ray (AXI)

Export to Excel

Pin ⇅Net ⇅E Opens ⇅E Shorts ⇅O Opens ⇅O Shorts ⇅X Opens ⇅X Shorts ⇅

J2_1+BATT-●----
J2_2+BATT-●----
J2_3GND-●----
J2_4GND-●----
J5_1AC_OUT_A------
J5_2AC_OUT_A------
J5_3GND-●----
J5_4GND-●----
J5_5Net-(J5-3_1)------
J5_6Net-(J5-3_1)------
J1_1BLUE------
J1_2BLUE------
J1_3BROWN------
J1_4BROWN------
J1_5BLACK------
J1_6BLACK------
J1_7RED------
J1_8RED------
J4_1GND-●----
J3_A1Net-(J3-GND-PadA1)------
J3_A4Control-Section/USB-5v------
J3_A5Control-Section/CC1------
J3_A6Control-Section/D+------
J3_A7Control-Section/D-------
J3_A9Control-Section/USB-5v------
J3_A12Net-(J3-GND-PadA1)------
J3_B1Net-(J3-GND-PadA1)------
J3_B4Control-Section/USB-5v------
J3_B5Control-Section/CC2------
J3_B6Control-Section/D+------
J3_B7Control-Section/D-------
J3_B9Control-Section/USB-5v------
J3_B12Net-(J3-GND-PadA1)------
J3_SHNet-(J3-SHIELD)------
RCS1_1+BATT-●●◐--
RCS1_2CSP-●●◐--
J6_1Control-Section/Buck-5v-●----
U6_1Control-Section/GPIO3--●◐--
U6_2Control-Section/GPIO4--●◐--
U6_3GND-●●◐--
U6_4CSP-●●◐--
U6_5GND-●●◐--
U6_6LO2--●◐--
U6_7CSP-●●◐--
U6_8--●◐--
U6_9--●◐--
U6_10--●◐--
U6_11BROWN--●◐--
U6_12Net-(U6-HO)--●◐--
U6_13HB2--●◐--
U6_14--●◐--
Q3_1Q3G------
Q3_2G4D------
Q3_3BLUE------
Cres1_1RES--●◐--
Cres1_2GND-●●◐--
R10_1Q5G--●◐--
R10_2LO1--●◐--
Q4_1Q4G------
Q4_2G4D------
Q4_3BROWN------
C23_1HB2--●◐--
C23_2BROWN--●◐--
C22_1HB1--●◐--
C22_2BLUE--●◐--
Ccomp2_1COMP--●◐--
Ccomp2_2FB--●◐--
U9_1Control-Section/3v3-●----
U9_2Control-Section/TEMP_INV------
U9_3GND-●----
R17_1Net-(U5-HO)--●◐--
R17_2Q3G--●◐--
C32_1BST--●◐--
C32_2SW--●◐--
Ruvb1_1UVLO--●◐--
Ruvb1_2GND-●●◐--
Q5_1Q5G------
Q5_2BLUE------
Q5_3GND-●----
Cin1_1CSP-●----
Cin1_2GND-●----
U4_1------
U4_2GND-●----
U4_3CSN------
U4_4CSP-●----
U4_5VIN-●----
U4_6UVLO------
U4_7SS------
U4_8SYNCIN_RT------
U4_9GND-●----
U4_10FB------
U4_11COMP------
U4_12SLOPE------
U4_13GND-●----
U4_14RES------
U4_15GND-●----
U4_16LO------
U4_17VCC-●----
U4_18SW------
U4_19HO------
U4_20BST------
U4_21GND-●----
Ccomp1_1Net-(Ccomp1-Pad1)--●◐--
Ccomp1_2FB--●◐--
R18_1Net-(U6-HO)--●◐--
R18_2Q4G--●◐--
Coutx1_1G4D--●◐--
Coutx1_2GND-●●◐--
D12_1HB2------
D12_2CSP-●----
Rfbb1_1FB--●◐--
Rfbb1_2GND-●●◐--
Cvin1_1VIN-●●◐--
Cvin1_2GND-●●◐--
Cout1_1G4D------
Cout1_2GND-●----
D6_1BST------
D6_2VCC-●----
Q2_1GND-●----
Q2_2GND-●----
Q2_3GND-●----
Q2_4LO------
Q2_5SW------
Q2_6SW------
Q2_7SW------
Q2_8SW------
Q2_9SW------
C33_1GND-●●◐--
C33_2VCC-●●◐--
Css1_1SS--●◐--
Css1_2GND-●●◐--
R12_1Q6G--●◐--
R12_2LO2--●◐--
U5_1Control-Section/GPIO1--●◐--
U5_2Control-Section/GPIO2--●◐--
U5_3GND-●●◐--
U5_4CSP-●●◐--
U5_5GND-●●◐--
U5_6LO1--●◐--
U5_7CSP-●●◐--
U5_8--●◐--
U5_9--●◐--
U5_10--●◐--
U5_11BLUE--●◐--
U5_12Net-(U5-HO)--●◐--
U5_13HB1--●◐--
U5_14--●◐--
Rcomp1_1COMP--●◐--
Rcomp1_2Net-(Ccomp1-Pad1)--●◐--
Q6_1Q6G------
Q6_2BROWN------
Q6_3GND-●----
Rt1_1SYNCIN_RT--●◐--
Rt1_2GND-●●◐--
Q1_1SW------
Q1_2SW------
Q1_3SW------
Q1_4HO------
Q1_5G4D------
Q1_6G4D------
Q1_7G4D------
Q1_8G4D------
Q1_9G4D------
Ruvt1_1CSP-●●◐--
Ruvt1_2UVLO--●◐--
Rvin1_1CSP-●●◐--
Rvin1_2VIN-●●◐--
Rsense1_1CSP-●●◐--
Rsense1_2CSN--●◐--
Cout3_1G4D------
Cout3_2GND-●----
L2_1CSN------
L2_2SW------
Rslope1_1SLOPE--●◐--
Rslope1_2GND-●●◐--
Cout2_1G4D------
Cout2_2GND-●----
D11_1HB1------
D11_2CSP-●----
Rfbt1_1G4D--●◐--
Rfbt1_2FB--●◐--
C20_1Net-(C20-Pad1)--●◐--
C20_2GND-●●◐--
R24_1Control-Section/3v3-●●◐--
R24_2Control-Section/GPIO9--●◐--
R2_1Control-Section/CC1--●◐--
R2_2GND-●●◐--
R6_1Control-Section/D+--●◐--
R6_2Control-Section/USB_DP--●◐--
R29_1BLUE--●◐--
R29_2Control-Section/AIN2--●◐--
C16_1Net-(U1-VREG_AVDD)--●◐--
C16_2GND-●●◐--
C31_1Control-Section/AIN4--●◐--
C31_2GND-●●◐--
R8_1Control-Section/3v3-●●◐--
R8_2Net-(U1-RUN)--●◐--
CR1_1Control-Section/5V-●----
CR1_2Control-Section/USB-5v------
R7_1Control-Section/BTN--●◐--
R7_2Net-(U1-QSPI_SS)--●◐--
U7_1GND-●----
U7_2CSP-●----
U7_3CSP-●----
U7_4GND-●----
U7_5Net-(U7-FB)------
U7_6Control-Section/Buck-5v-●----
U7_7Net-(U7-SW)------
U7_8Control-Section/PG------
U7_9GND-●----
C13_1Control-Section/3v3-●●◐--
C13_2GND-●●◐--
C29_1Control-Section/AIN2--●◐--
C29_2GND-●●◐--
R28_1Control-Section/AIN1--●◐--
R28_2GND-●●◐--
CR2_1Control-Section/5V-●----
CR2_2Control-Section/Buck-5v-●----
C21_1Control-Section/XIN--●◐--
C21_2GND-●●◐--
L1_1Net-(U1-VREG_LX)------
L1_2Control-Section/1V1-●----
R27_1G4D--●◐--
R27_2Control-Section/AIN1--●◐--
R31_1BROWN--●◐--
R31_2Control-Section/AIN3--●◐--
U1_6Control-Section/1V1-●--●◐
U1_39Control-Section/1V1-●--●◐
U1_46Net-(U1-VREG_AVDD)----●◐
U1_47GND-●--●◐
U1_53Control-Section/3v3-●--●◐
U1_54Control-Section/3v3-●--●◐
U1_1Control-Section/3v3-●--●◐
U1_2Control-Section/BTN----●◐
U1_3Control-Section/GPIO1----●◐
U1_4Control-Section/GPIO2----●◐
U1_5Control-Section/GPIO3----●◐
U1_7Control-Section/GPIO4----●◐
U1_8----●◐
U1_9----●◐
U1_10----●◐
U1_11Control-Section/3v3-●--●◐
U1_12Control-Section/GPIO8----●◐
U1_13Control-Section/GPIO9----●◐
U1_14----●◐
U1_15Control-Section/GPIO11----●◐
U1_16----●◐
U1_17----●◐
U1_18----●◐
U1_19----●◐
U1_20Control-Section/3v3-●--●◐
U1_21Control-Section/XIN----●◐
U1_22Control-Section/XOUT----●◐
U1_23Control-Section/1V1-●--●◐
U1_24----●◐
U1_25----●◐
U1_26Net-(U1-RUN)----●◐
U1_27----●◐
U1_28----●◐
U1_29----●◐
U1_30Control-Section/3v3-●--●◐
U1_31----●◐
U1_32----●◐
U1_33----●◐
U1_34----●◐
U1_35----●◐
U1_36----●◐
U1_37----●◐
U1_38Control-Section/3v3-●--●◐
U1_40Control-Section/TEMP_CTRL----●◐
U1_41Control-Section/TEMP_INV----●◐
U1_42----●◐
U1_43----●◐
U1_44Control-Section/3v3-●--●◐
U1_45Control-Section/3v3-●--●◐
U1_48Net-(U1-VREG_LX)----●◐
U1_49Control-Section/3v3-●--●◐
U1_50Control-Section/1V1-●--●◐
U1_51Control-Section/USB_DM----●◐
U1_52Control-Section/USB_DP----●◐
U1_55----●◐
U1_56----●◐
U1_57----●◐
U1_58----●◐
U1_59----●◐
U1_60Net-(U1-QSPI_SS)----●◐
U1_61GND-●--●◐
X1_1Control-Section/XIN------
X1_2GND-●----
X1_3Net-(C20-Pad1)------
X1_4GND-●----
R30_1Control-Section/AIN2--●◐--
R30_2GND-●●◐--
C17_1Control-Section/3v3-●●◐--
C17_2GND-●●◐--
U2_1GND-●●◐--
U2_2Control-Section/3v3-●●◐--
U2_3Control-Section/5V-●●◐--
U2_4Control-Section/3v3-●●◐--
C24_1CSP-●●◐--
C24_2GND-●●◐--
L3_1Control-Section/Buck-5v-●----
L3_2Net-(U7-SW)------
R3_1Control-Section/CC2--●◐--
R3_2GND-●●◐--
NT1_1GND-●----
NT1_2GND-●----
C28_1Control-Section/AIN1--●◐--
C28_2GND-●●◐--
C18_1Control-Section/3v3-●●◐--
C18_2GND-●●◐--
R33_1Net-(IC1-OUT)--●◐--
R33_2Control-Section/AIN4--●◐--
C14_1Control-Section/3v3-●●◐--
C14_2GND-●●◐--
R25_1CSP-●●◐--
R25_2Control-Section/AIN0--●◐--
U8_1Control-Section/3v3-●----
U8_2Control-Section/TEMP_CTRL------
U8_3GND-●----
R4_1Control-Section/3v3-●●◐--
R4_2Net-(U1-VREG_AVDD)--●◐--
C19_1Control-Section/1V1-●●◐--
C19_2GND-●●◐--
R20_1Control-Section/Buck-5v-●●◐--
R20_2Net-(U7-FB)--●◐--
R21_1Control-Section/Buck-5v-●●◐--
R21_2Control-Section/PG--●◐--
C26_1Net-(U10-DECAP)--●◐--
C26_2GND-●●◐--
R5_1Control-Section/D---●◐--
R5_2Control-Section/USB_DM--●◐--
C25_1GND-●----
C25_2Control-Section/Buck-5v-●----
R19_1Net-(U7-FB)--●◐--
R19_2GND-●●◐--
R32_1Control-Section/AIN3--●◐--
R32_2GND-●●◐--
IC1_1CSP-●●◐--
IC1_2GND-●●◐--
IC1_3GND-●●◐--
IC1_4--●◐--
IC1_5Net-(IC1-OUT)--●◐--
IC1_6Control-Section/3v3-●●◐--
IC1_7GND-●●◐--
IC1_8+BATT-●●◐--
C30_1Control-Section/AIN3--●◐--
C30_2GND-●●◐--
C27_1Control-Section/AIN0--●◐--
C27_2GND-●●◐--
C15_1Control-Section/1V1-●●◐--
C15_2GND-●●◐--
U10_1Control-Section/AIN2----●◐
U10_2Control-Section/AIN3----●◐
U10_3Control-Section/AIN4----●◐
U10_4----●◐
U10_5----●◐
U10_6----●◐
U10_7Control-Section/3v3-●--●◐
U10_8Net-(U10-DECAP)----●◐
U10_9GND-●--●◐
U10_10Control-Section/3v3-●--●◐
U10_11----●◐
U10_12----●◐
U10_13Control-Section/GPIO9----●◐
U10_14Control-Section/GPIO8----●◐
U10_15Control-Section/AIN0----●◐
U10_16Control-Section/AIN1----●◐
U10_17GND-●--●◐
R26_1Control-Section/AIN0--●◐--
R26_2GND-●●◐--
R11_1Net-(C20-Pad1)--●◐--
R11_2Control-Section/XOUT--●◐--
C12_1GND-●●◐--
C12_2Control-Section/5V-●●◐--
R23_1Control-Section/3v3-●●◐--
R23_2Control-Section/GPIO8--●◐--
SW1_1Control-Section/BTN------
SW1_2Control-Section/BTN------
SW1_3GND-●----
SW1_4GND-●----
D1_1Control-Section/5V-●----
D1_2Net-(D1-DOUT)------
D1_3GND-●----
D1_4Net-(D1-DIN)------
C3_1Control-Section/5V-●●◐--
C3_2GND-●●◐--
D5_1Control-Section/5V-●----
D5_2------
D5_3GND-●----
D5_4Net-(D4-DOUT)------
C2_1Control-Section/5V-●●◐--
C2_2GND-●●◐--
C1_1Control-Section/5V-●●◐--
C1_2GND-●●◐--
C11_1Control-Section/5V-●●◐--
C11_2GND-●●◐--
D2_1Control-Section/5V-●----
D2_2Net-(D2-DOUT)------
D2_3GND-●----
D2_4Net-(D1-DOUT)------
U3_1GND-●●◐--
U3_2Control-Section/GPIO11--●◐--
U3_3GND-●●◐--
U3_4Net-(R1-Pad2)--●◐--
U3_5Control-Section/5V-●●◐--
C5_1Control-Section/5V-●●◐--
C5_2GND-●●◐--
R9_1User-Interface-Section/3v3--●◐--
R9_2Control-Section/BTN--●◐--
C4_1Control-Section/5V-●●◐--
C4_2GND-●●◐--
R1_1Net-(D1-DIN)--●◐--
R1_2Net-(R1-Pad2)--●◐--
D3_1Control-Section/5V-●----
D3_2Net-(D3-DOUT)------
D3_3GND-●----
D3_4Net-(D2-DOUT)------
D4_1Control-Section/5V-●----
D4_2Net-(D4-DOUT)------
D4_3GND-●----
D4_4Net-(D3-DOUT)------

14.12  PCOLA/SOQ Testability
PCOLA/SOQ scores how well the configured test methods cover each component and each connection. PCOLA evaluates five device-level properties: Presence, Correctness, Orientation, Live (functional), and Alignment. SOQ evaluates three connection-level properties: Shorts detection, Opens detection, and solder joint Quality. Scores are on a 0–100,000 scale where 100,000 means every property is fully covered. The Combined score is the average of PCOLA and SOQ.
14.12.1  Coverage by Test Method
P=Presence  C=Correctness  O=Orientation  L=Live  A=Alignment  |  S=Shorts  O(pins)=Opens  Q=Quality

PCOLA/SOQ coverage scores by test method. Scores: 0 (None), 0.5 (Partial), 1.0 (Full).

Test MethodPCOLASOpensSolder Quality

Electrical Test37.9%0.0%0.0%0.0%0.0%20.0%0.0%0.0%
Optical Inspection (AOI)69.6%7.1%38.4%0.0%33.9%22.4%22.4%22.4%
X-Ray Inspection (AXI)0.0%0.0%0.0%0.0%0.9%9.3%9.3%9.3%
Combined82.1%7.1%38.4%0.0%34.8%38.6%31.7%31.7%

14.12.2  PCB Device/Pin Count
Devices (PCOLA): 112Pins (SOQ): 418
14.12.3  Board-Level Scores

Board-Level Coverage (0 – 100,000 scale)

DimensionScoreCoverage

PCOLA32500 / 100,00032.5%
SOQ34011 / 100,00034.0%
Combined33256 / 100,00033.3%

Electrical vs Inspection

SourcePCOLA ScoreSOQ Score

Electrical Test7589 / 100,0006659 / 100,000
Optical/X-ray Inspection30000 / 100,00031699 / 100,000
Combined (max)32500 / 100,00034011 / 100,000

14.12.4  PCOLA (112 devices)
● = Full (1.0)   ◐ = Partial (0.5)   ○ = None (0)   — = N/A (excluded)* Footprint not IPC-7351B/7251 compliant — no inspection coverage scored

Export to Excel

Score ⇅RefDes ⇅Type / Footprint ⇅Class ⇅P ⇅C ⇅O ⇅L ⇅A ⇅Method ⇅

70%U6UCC27735DR / SOIC_14L_TEXIC●●●○◐AOI, Powered_Off
70%C2410uF / CAPC2114X145NCapacitor●●●—◐AOI, Powered_Off
70%U5UCC27735DR / SOIC_14L_TEXIC●●●○◐AOI, Powered_Off
70%U1RP2354A / QFN-60-1EP_7x7mm_P0.4mm_EP3.4x3.4mmIC●●●○◐AOI, AXI, Powered_Off
70%U2AMS1117-3.3 / SOT-223-3_TabPin2IC●●●○◐AOI, Powered_Off
70%IC1INA240A2DR / SOIC127P600X175-8NIC●●●○◐AOI, Powered_Off
70%U10ADS7128IRTER / WQFN16_RTE_TEXIC●●●○◐AOI, AXI, Powered_Off
70%U374AHCT1G125 / SOT-23-5IC●●●○◐AOI, Powered_Off
40%Cres1470nF / C_0805_2012MetricCapacitor●○◐—◐AOI, Powered_Off
40%R1010 / R_1206_3216MetricResistor●○◐—◐AOI
40%R2810k / R_0603_1608MetricResistor●○◐—◐AOI, Powered_Off
40%C231uF / C_0805_2012MetricCapacitor●○◐—◐AOI
40%C221uF / C_0805_2012MetricCapacitor●○◐—◐AOI
40%Ccomp2130pF / C_0402_1005MetricCapacitor●○◐—◐AOI
40%R810k / R_0603_1608MetricResistor●○◐—◐AOI, Powered_Off
40%Rslope1105k / R_0201_0603MetricResistor●○◐—◐AOI, Powered_Off
40%C32100nF / C_0805_2012MetricCapacitor●○◐—◐AOI
40%Ruvb17.15k / R_0402_1005MetricResistor●○◐—◐AOI, Powered_Off
40%R71k / R_0402_1005MetricResistor●○◐—◐AOI
40%Rfbt149.9k / R_0402_1005MetricResistor●○◐—◐AOI
40%C2015p / C_0402_1005MetricCapacitor●○◐—◐AOI, Powered_Off
40%Ccomp13.9nF / C_0805_2012MetricCapacitor●○◐—◐AOI
40%R1810 / R_1206_3216MetricResistor●○◐—◐AOI
40%Coutx147uF / C_1206_3216MetricCapacitor●○◐—◐AOI, Powered_Off
40%R244.7k / R_0603_1608MetricResistor●○◐—◐AOI, Powered_Off
40%Rfbb13.79k / R_0402_1005MetricResistor●○◐—◐AOI, Powered_Off
40%Cvin1470nF / C_0402_1005MetricCapacitor●○◐—◐AOI, Powered_Off
40%R25.1k / RC0603N_YAGResistor●○◐—◐AOI, Powered_Off
40%R627 / R_0603_1608MetricResistor●○◐—◐AOI
40%R2945.3k / R_0603_1608MetricResistor●○◐—◐AOI
40%C334.7uF / C_0805_2012MetricCapacitor●○◐—◐AOI, Powered_Off
40%Css133nF / C_0402_1005MetricCapacitor●○◐—◐AOI, Powered_Off
40%R1210 / R_1206_3216MetricResistor●○◐—◐AOI
40%Rcomp128.7k / R_0201_0603MetricResistor●○◐—◐AOI
40%C164.7u / C_0603_1608MetricCapacitor●○◐—◐AOI, Powered_Off
40%Rt118.2k / R_0402_1005MetricResistor●○◐—◐AOI, Powered_Off
40%C2947nF / C_0603_1608MetricCapacitor●○◐—◐AOI, Powered_Off
40%Ruvt149.9k / R_0402_1005MetricResistor●○◐—◐AOI, Powered_Off
40%Rvin13.01 / R_0402_1005MetricResistor●○◐—◐AOI, Powered_Off
40%Rsense12m / R_1206_3216MetricResistor●○◐—◐AOI, Powered_Off
40%C31100nF / C_0603_1608MetricCapacitor●○◐—◐AOI, Powered_Off
40%C1310u / C_0402_1005MetricCapacitor●○◐—◐AOI, Powered_Off
40%R1710 / R_1206_3216MetricResistor●○◐—◐AOI
40%R3010k / R_0603_1608MetricResistor●○◐—◐AOI, Powered_Off
40%C17100n / C_0402_1005MetricCapacitor●○◐—◐AOI, Powered_Off
40%R3145.3k / R_0603_1608MetricResistor●○◐—◐AOI
40%R35.1k / RC0603N_YAGResistor●○◐—◐AOI, Powered_Off
40%C2847nF / C_0603_1608MetricCapacitor●○◐—◐AOI, Powered_Off
40%C18100n / C_0402_1005MetricCapacitor●○◐—◐AOI, Powered_Off
40%R3322 / R_0603_1608MetricResistor●○◐—◐AOI
40%C144.7u / C_0603_1608MetricCapacitor●○◐—◐AOI, Powered_Off
40%R2536.5k / R_0603_1608MetricResistor●○◐—◐AOI, Powered_Off
40%R433 / R_0603_1608MetricResistor●○◐—◐AOI, Powered_Off
40%C19100n / C_0402_1005MetricCapacitor●○◐—◐AOI, Powered_Off
40%R20953k / RC0402N_VISResistor●○◐—◐AOI, Powered_Off
40%R21100k / RES_CRCW_0402_VISResistor●○◐—◐AOI, Powered_Off
40%C261uF / C_0603_1608MetricCapacitor●○◐—◐AOI, Powered_Off
40%R527 / R_0603_1608MetricResistor●○◐—◐AOI
40%R19180k / RC0603N_YAGResistor●○◐—◐AOI, Powered_Off
40%R3210k / R_0603_1608MetricResistor●○◐—◐AOI, Powered_Off
40%R2743.2k / R_0603_1608MetricResistor●○◐—◐AOI
40%C3047nF / C_0603_1608MetricCapacitor●○◐—◐AOI, Powered_Off
40%C2747nF / C_0603_1608MetricCapacitor●○◐—◐AOI, Powered_Off
40%C154.7u / C_0603_1608MetricCapacitor●○◐—◐AOI, Powered_Off
40%RCS12m / R_2512_6332MetricResistor●○◐—◐AOI, Powered_Off
40%R2610k / R_0603_1608MetricResistor●○◐—◐AOI, Powered_Off
40%R111k / R_0402_1005MetricResistor●○◐—◐AOI
40%C1210u / C_0402_1005MetricCapacitor●○◐—◐AOI, Powered_Off
40%R234.7k / R_0603_1608MetricResistor●○◐—◐AOI, Powered_Off
40%C3100n / C_0603_1608MetricCapacitor●○◐—◐AOI, Powered_Off
40%C2100n / C_0603_1608MetricCapacitor●○◐—◐AOI, Powered_Off
40%C1100n / C_0603_1608MetricCapacitor●○◐—◐AOI, Powered_Off
40%C11100u / C_1206_3216MetricCapacitor●○◐—◐AOI, Powered_Off
40%C2115p / C_0402_1005MetricCapacitor●○◐—◐AOI, Powered_Off
40%C5100n / C_0603_1608MetricCapacitor●○◐—◐AOI, Powered_Off
40%R910k / R_0603_1608MetricResistor●○◐—◐AOI
40%C4100n / C_0603_1608MetricCapacitor●○◐—◐AOI, Powered_Off
40%R1330 / R_0603_1608MetricResistor●○◐—◐AOI
10%CR2SS14-E3/61T / DO-214AC_VIS *Diode◐○○○○Powered_Off
10%C2522uF / G-31_MUR *Capacitor◐○○—○Powered_Off
10%L13.3u / AOTAB201610S3R3101T *Inductor◐○○—○Powered_Off
10%J52604-1103 / CONN3_2604-1103_WAG *Connector◐○○—○Powered_Off
10%X1ABM8-272-T3 / ABM8272T3 *Oscillator◐○○○○Powered_Off
10%U9TMP235A2DBZR / DBZ0003A-IPC_A *IC◐○○○○Powered_Off
10%Q5100V 150A N-Ch / TO-220-3_Vertical *Transistor◐○○○○Powered_Off
10%Cin156uF / CP_Elec_5x5.9 *Capacitor◐○○—○Powered_Off
10%U7TPS62160DSGR / DSG8_1P6X0P9 *IC◐○○○○Powered_Off
10%L32.2uH / IND_PA4332.222NLT_PUL *Inductor◐○○—○Powered_Off
10%U4LM5122MHX/NOPB / PWP0020A_N *IC◐○○○○Powered_Off
10%D12SS14-E3/61T / D_SMA *Diode◐○○○○Powered_Off
10%Cout1180uF / CP_Elec_8x11.9_Cout1 *Capacitor◐○○—○Powered_Off
10%SW1B3F-4055 / SW_B3F-4050_OMR *Switch◐○○○○Powered_Off
10%D1WS2812B / LED_WS2812B_PLCC4_5.0x5.0mm_P3.2mm *Diode◐○○○○Powered_Off
10%D6SK215ATR / D_SMA *Diode◐○○○○Powered_Off
10%D5WS2812B / LED_WS2812B_PLCC4_5.0x5.0mm_P3.2mm *Diode◐○○○○Powered_Off
10%Q230V 56A N-Ch / DQG0008A *Transistor◐○○○○Powered_Off
10%Q6100V 150A N-Ch / TO-220-3_Vertical *Transistor◐○○○○Powered_Off
10%U8TMP235A2DBZR / DBZ0003A-IPC_A *IC◐○○○○Powered_Off
10%D2WS2812B / LED_WS2812B_PLCC4_5.0x5.0mm_P3.2mm *Diode◐○○○○Powered_Off
10%Cout3180uF / CP_Elec_8x11.9_Cout3 *Capacitor◐○○—○Powered_Off
10%Cout2180uF / CP_Elec_8x11.9_Cout2 *Capacitor◐○○—○Powered_Off
10%D11SS14-E3/61T / D_SMA *Diode◐○○○○Powered_Off
10%CR1SS14-E3/61T / DO-214AC_VIS *Diode◐○○○○Powered_Off
10%J22606-1352 / CONN2_2606-1352_WAG *Connector◐○○—○Powered_Off
10%D3WS2812B / LED_WS2812B_PLCC4_5.0x5.0mm_P3.2mm *Diode◐○○○○Powered_Off
10%D4WS2812B / LED_WS2812B_PLCC4_5.0x5.0mm_P3.2mm *Diode◐○○○○Powered_Off
0%J12606-1108/010-000 / CONN8_2606-1108&slash_010-000_WAG *Connector○○○—○
0%Q4100V 150A N-Ch / TO-220-3_Vertical *Transistor○○○○○
0%L21.8uH / L_Coilcraft_XAL1580-182 *Inductor○○○—○
0%Q3100V 150A N-Ch / TO-220-3_Vertical *Transistor○○○○○
0%Q125V 60A N-Ch / DQG0008A *Transistor○○○○○
0%J3USB_C_Receptacle_USB2.0_14P / USB_C_Receptacle_HRO_TYPE-C-31-M-12 *Connector○○○—○

14.12.5  SOQ (418 solder joints)
● = Full (1.0)   ◐ = Partial (0.5)   ○ = None (0)

Export to Excel

Score ⇅Pin ⇅Net ⇅S ⇅O ⇅Q ⇅

50%Cres1_1RES◐◐◐
50%U1_43◐◐◐
50%U1_44Control-Section/3v3◐◐◐
50%U1_45Control-Section/3v3◐◐◐
50%U1_48Net-(U1-VREG_LX)◐◐◐
50%U1_49Control-Section/3v3◐◐◐
50%U1_50Control-Section/1V1◐◐◐
50%U1_51Control-Section/USB_DM◐◐◐
50%U1_52Control-Section/USB_DP◐◐◐
50%U1_55◐◐◐
50%U1_56◐◐◐
50%U1_57◐◐◐
50%U1_58◐◐◐
50%U1_59◐◐◐
50%U1_60Net-(U1-QSPI_SS)◐◐◐
50%U1_61GND◐◐◐
50%R30_1Control-Section/AIN2◐◐◐
50%R30_2GND◐◐◐
50%C17_1Control-Section/3v3◐◐◐
50%C17_2GND◐◐◐
50%U2_1GND◐◐◐
50%U2_2Control-Section/3v3◐◐◐
50%U2_3Control-Section/5V◐◐◐
50%U2_4Control-Section/3v3◐◐◐
50%C24_1CSP◐◐◐
50%C24_2GND◐◐◐
50%R3_1Control-Section/CC2◐◐◐
50%R3_2GND◐◐◐
50%C28_1Control-Section/AIN1◐◐◐
50%C28_2GND◐◐◐
50%C18_1Control-Section/3v3◐◐◐
50%C18_2GND◐◐◐
50%R33_1Net-(IC1-OUT)◐◐◐
50%RCS1_1+BATT◐◐◐
50%RCS1_2CSP◐◐◐
50%U6_1Control-Section/GPIO3◐◐◐
50%U6_2Control-Section/GPIO4◐◐◐
50%U6_3GND◐◐◐
50%U6_4CSP◐◐◐
50%U6_5GND◐◐◐
50%U6_6LO2◐◐◐
50%U6_7CSP◐◐◐
50%U6_8◐◐◐
50%U6_9◐◐◐
50%U6_10◐◐◐
50%U6_11BROWN◐◐◐
50%U6_12Net-(U6-HO)◐◐◐
50%U6_13HB2◐◐◐
50%U6_14◐◐◐
50%R33_2Control-Section/AIN4◐◐◐
50%C14_1Control-Section/3v3◐◐◐
50%C14_2GND◐◐◐
50%Coutx1_1G4D◐◐◐
50%Cres1_2GND◐◐◐
50%R10_1Q5G◐◐◐
50%R10_2LO1◐◐◐
50%R25_1CSP◐◐◐
50%R25_2Control-Section/AIN0◐◐◐
50%R26_1Control-Section/AIN0◐◐◐
50%C23_1HB2◐◐◐
50%C23_2BROWN◐◐◐
50%C22_1HB1◐◐◐
50%C22_2BLUE◐◐◐
50%Ccomp2_1COMP◐◐◐
50%Ccomp2_2FB◐◐◐
50%R4_1Control-Section/3v3◐◐◐
50%R4_2Net-(U1-VREG_AVDD)◐◐◐
50%C19_1Control-Section/1V1◐◐◐
50%R17_1Net-(U5-HO)◐◐◐
50%R17_2Q3G◐◐◐
50%C32_1BST◐◐◐
50%C32_2SW◐◐◐
50%Ruvb1_1UVLO◐◐◐
50%Ruvb1_2GND◐◐◐
50%C19_2GND◐◐◐
50%R20_1Control-Section/Buck-5v◐◐◐
50%R20_2Net-(U7-FB)◐◐◐
50%R21_1Control-Section/Buck-5v◐◐◐
50%R21_2Control-Section/PG◐◐◐
50%C26_1Net-(U10-DECAP)◐◐◐
50%C26_2GND◐◐◐
50%R5_1Control-Section/D-◐◐◐
50%R5_2Control-Section/USB_DM◐◐◐
50%R19_1Net-(U7-FB)◐◐◐
50%R19_2GND◐◐◐
50%R32_1Control-Section/AIN3◐◐◐
50%R32_2GND◐◐◐
50%IC1_1CSP◐◐◐
50%IC1_2GND◐◐◐
50%IC1_3GND◐◐◐
50%IC1_4◐◐◐
50%IC1_5Net-(IC1-OUT)◐◐◐
50%IC1_6Control-Section/3v3◐◐◐
50%IC1_7GND◐◐◐
50%IC1_8+BATT◐◐◐
50%C30_1Control-Section/AIN3◐◐◐
50%C30_2GND◐◐◐
50%C27_1Control-Section/AIN0◐◐◐
50%C27_2GND◐◐◐
50%C15_1Control-Section/1V1◐◐◐
50%Ccomp1_1Net-(Ccomp1-Pad1)◐◐◐
50%Ccomp1_2FB◐◐◐
50%R18_1Net-(U6-HO)◐◐◐
50%R18_2Q4G◐◐◐
50%C15_2GND◐◐◐
50%Coutx1_2GND◐◐◐
50%U10_1Control-Section/AIN2◐◐◐
50%U10_2Control-Section/AIN3◐◐◐
50%Rfbb1_1FB◐◐◐
50%Rfbb1_2GND◐◐◐
50%Cvin1_1VIN◐◐◐
50%Cvin1_2GND◐◐◐
50%U10_3Control-Section/AIN4◐◐◐
50%U10_4◐◐◐
50%U10_5◐◐◐
50%U10_6◐◐◐
50%U10_7Control-Section/3v3◐◐◐
50%U10_8Net-(U10-DECAP)◐◐◐
50%U10_9GND◐◐◐
50%U10_10Control-Section/3v3◐◐◐
50%U10_11◐◐◐
50%U10_12◐◐◐
50%U10_13Control-Section/GPIO9◐◐◐
50%U10_14Control-Section/GPIO8◐◐◐
50%U10_15Control-Section/AIN0◐◐◐
50%C33_1GND◐◐◐
50%C33_2VCC◐◐◐
50%Css1_1SS◐◐◐
50%Css1_2GND◐◐◐
50%R12_1Q6G◐◐◐
50%R12_2LO2◐◐◐
50%U5_1Control-Section/GPIO1◐◐◐
50%U5_2Control-Section/GPIO2◐◐◐
50%U5_3GND◐◐◐
50%U5_4CSP◐◐◐
50%U5_5GND◐◐◐
50%U5_6LO1◐◐◐
50%U5_7CSP◐◐◐
50%U5_8◐◐◐
50%U5_9◐◐◐
50%U5_10◐◐◐
50%U5_11BLUE◐◐◐
50%U5_12Net-(U5-HO)◐◐◐
50%U5_13HB1◐◐◐
50%U5_14◐◐◐
50%Rcomp1_1COMP◐◐◐
50%Rcomp1_2Net-(Ccomp1-Pad1)◐◐◐
50%U10_16Control-Section/AIN1◐◐◐
50%U10_17GND◐◐◐
50%R26_2GND◐◐◐
50%Rt1_1SYNCIN_RT◐◐◐
50%Rt1_2GND◐◐◐
50%R11_1Net-(C20-Pad1)◐◐◐
50%R11_2Control-Section/XOUT◐◐◐
50%C12_1GND◐◐◐
50%C12_2Control-Section/5V◐◐◐
50%R23_1Control-Section/3v3◐◐◐
50%C13_2GND◐◐◐
50%R23_2Control-Section/GPIO8◐◐◐
50%C3_1Control-Section/5V◐◐◐
50%C3_2GND◐◐◐
50%Ruvt1_1CSP◐◐◐
50%Ruvt1_2UVLO◐◐◐
50%Rvin1_1CSP◐◐◐
50%Rvin1_2VIN◐◐◐
50%Rsense1_1CSP◐◐◐
50%Rsense1_2CSN◐◐◐
50%C2_1Control-Section/5V◐◐◐
50%C2_2GND◐◐◐
50%C1_1Control-Section/5V◐◐◐
50%C1_2GND◐◐◐
50%Rslope1_1SLOPE◐◐◐
50%Rslope1_2GND◐◐◐
50%C11_1Control-Section/5V◐◐◐
50%C11_2GND◐◐◐
50%U3_1GND◐◐◐
50%U3_2Control-Section/GPIO11◐◐◐
50%Rfbt1_1G4D◐◐◐
50%Rfbt1_2FB◐◐◐
50%C20_1Net-(C20-Pad1)◐◐◐
50%C20_2GND◐◐◐
50%R24_1Control-Section/3v3◐◐◐
50%R24_2Control-Section/GPIO9◐◐◐
50%R2_1Control-Section/CC1◐◐◐
50%R2_2GND◐◐◐
50%R6_1Control-Section/D+◐◐◐
50%R6_2Control-Section/USB_DP◐◐◐
50%R29_1BLUE◐◐◐
50%R29_2Control-Section/AIN2◐◐◐
50%C16_1Net-(U1-VREG_AVDD)◐◐◐
50%C16_2GND◐◐◐
50%C31_1Control-Section/AIN4◐◐◐
50%C31_2GND◐◐◐
50%R8_1Control-Section/3v3◐◐◐
50%R8_2Net-(U1-RUN)◐◐◐
50%U3_3GND◐◐◐
50%U3_4Net-(R1-Pad2)◐◐◐
50%R7_1Control-Section/BTN◐◐◐
50%R7_2Net-(U1-QSPI_SS)◐◐◐
50%U3_5Control-Section/5V◐◐◐
50%C5_1Control-Section/5V◐◐◐
50%C5_2GND◐◐◐
50%R9_1User-Interface-Section/3v3◐◐◐
50%R9_2Control-Section/BTN◐◐◐
50%C4_1Control-Section/5V◐◐◐
50%C4_2GND◐◐◐
50%R1_1Net-(D1-DIN)◐◐◐
50%R1_2Net-(R1-Pad2)◐◐◐
50%C13_1Control-Section/3v3◐◐◐
50%U1_33◐◐◐
50%C29_1Control-Section/AIN2◐◐◐
50%C29_2GND◐◐◐
50%R28_1Control-Section/AIN1◐◐◐
50%R28_2GND◐◐◐
50%C21_1Control-Section/XIN◐◐◐
50%C21_2GND◐◐◐
50%R27_1G4D◐◐◐
50%R27_2Control-Section/AIN1◐◐◐
50%R31_1BROWN◐◐◐
50%R31_2Control-Section/AIN3◐◐◐
50%U1_6Control-Section/1V1◐◐◐
50%U1_39Control-Section/1V1◐◐◐
50%U1_46Net-(U1-VREG_AVDD)◐◐◐
50%U1_47GND◐◐◐
50%U1_53Control-Section/3v3◐◐◐
50%U1_54Control-Section/3v3◐◐◐
50%U1_1Control-Section/3v3◐◐◐
50%U1_2Control-Section/BTN◐◐◐
50%U1_3Control-Section/GPIO1◐◐◐
50%U1_4Control-Section/GPIO2◐◐◐
50%U1_5Control-Section/GPIO3◐◐◐
50%U1_7Control-Section/GPIO4◐◐◐
50%U1_8◐◐◐
50%U1_9◐◐◐
50%U1_10◐◐◐
50%U1_11Control-Section/3v3◐◐◐
50%U1_12Control-Section/GPIO8◐◐◐
50%U1_13Control-Section/GPIO9◐◐◐
50%U1_14◐◐◐
50%U1_15Control-Section/GPIO11◐◐◐
50%U1_16◐◐◐
50%U1_17◐◐◐
50%U1_18◐◐◐
50%U1_19◐◐◐
50%U1_20Control-Section/3v3◐◐◐
50%U1_21Control-Section/XIN◐◐◐
50%U1_22Control-Section/XOUT◐◐◐
50%U1_23Control-Section/1V1◐◐◐
50%U1_24◐◐◐
50%U1_25◐◐◐
50%U1_26Net-(U1-RUN)◐◐◐
50%U1_27◐◐◐
50%U1_28◐◐◐
50%U1_29◐◐◐
50%U1_30Control-Section/3v3◐◐◐
50%U1_31◐◐◐
50%U1_32◐◐◐
50%U1_34◐◐◐
50%U1_35◐◐◐
50%U1_36◐◐◐
50%U1_37◐◐◐
50%U1_38Control-Section/3v3◐◐◐
50%U1_40Control-Section/TEMP_CTRL◐◐◐
50%U1_41Control-Section/TEMP_INV◐◐◐
50%U1_42◐◐◐
17%J2_2+BATT◐○○
17%J2_3GND◐○○
17%J2_4GND◐○○
17%U4_13GND◐○○
17%CR2_2Control-Section/Buck-5v◐○○
17%J5_3GND◐○○
17%J5_4GND◐○○
17%U4_15GND◐○○
17%SW1_3GND◐○○
17%U4_17VCC◐○○
17%SW1_4GND◐○○
17%D1_1Control-Section/5V◐○○
17%D3_1Control-Section/5V◐○○
17%U4_21GND◐○○
17%J2_1+BATT◐○○
17%D3_3GND◐○○
17%D12_2CSP◐○○
17%D4_1Control-Section/5V◐○○
17%Cout1_2GND◐○○
17%U9_1Control-Section/3v3◐○○
17%D4_3GND◐○○
17%D6_2VCC◐○○
17%Q2_1GND◐○○
17%Q2_2GND◐○○
17%Cout3_2GND◐○○
17%Q6_3GND◐○○
17%Cout2_2GND◐○○
17%D11_2CSP◐○○
17%CR1_1Control-Section/5V◐○○
17%U7_1GND◐○○
17%U7_2CSP◐○○
17%U7_3CSP◐○○
17%U7_4GND◐○○
17%U7_6Control-Section/Buck-5v◐○○
17%U7_9GND◐○○
17%D1_3GND◐○○
17%C25_1GND◐○○
17%D5_1Control-Section/5V◐○○
17%D5_3GND◐○○
17%C25_2Control-Section/Buck-5v◐○○
17%U9_3GND◐○○
17%U8_3GND◐○○
17%L1_2Control-Section/1V1◐○○
17%Q5_3GND◐○○
17%Cin1_1CSP◐○○
17%Cin1_2GND◐○○
17%X1_2GND◐○○
17%U4_2GND◐○○
17%D2_1Control-Section/5V◐○○
17%U4_4CSP◐○○
17%U4_5VIN◐○○
17%D2_3GND◐○○
17%U8_1Control-Section/3v3◐○○
17%X1_4GND◐○○
17%U4_9GND◐○○
17%CR2_1Control-Section/5V◐○○
17%L3_1Control-Section/Buck-5v◐○○
17%Q2_3GND◐○○
0%J5_1AC_OUT_A○○○
0%J5_2AC_OUT_A○○○
0%J5_5Net-(J5-3_1)○○○
0%J5_6Net-(J5-3_1)○○○
0%J1_1BLUE○○○
0%J1_2BLUE○○○
0%J1_3BROWN○○○
0%J1_4BROWN○○○
0%J1_5BLACK○○○
0%J1_6BLACK○○○
0%J1_7RED○○○
0%J1_8RED○○○
0%J3_A1Net-(J3-GND-PadA1)○○○
0%J3_A4Control-Section/USB-5v○○○
0%J3_A6Control-Section/D+○○○
0%J3_A7Control-Section/D-○○○
0%J3_A9Control-Section/USB-5v○○○
0%J3_A12Net-(J3-GND-PadA1)○○○
0%J3_B1Net-(J3-GND-PadA1)○○○
0%J3_B4Control-Section/USB-5v○○○
0%J3_B5Control-Section/CC2○○○
0%J3_B6Control-Section/D+○○○
0%J3_B7Control-Section/D-○○○
0%J3_B9Control-Section/USB-5v○○○
0%J3_B12Net-(J3-GND-PadA1)○○○
0%J3_SHNet-(J3-SHIELD)○○○
0%Q3_1Q3G○○○
0%Q3_2G4D○○○
0%Q3_3BLUE○○○
0%Q4_1Q4G○○○
0%Q4_2G4D○○○
0%Q4_3BROWN○○○
0%J3_A5Control-Section/CC1○○○
0%U9_2Control-Section/TEMP_INV○○○
0%Q5_1Q5G○○○
0%Q5_2BLUE○○○
0%U4_1○○○
0%U4_3CSN○○○
0%U4_6UVLO○○○
0%U4_7SS○○○
0%U4_8SYNCIN_RT○○○
0%U4_10FB○○○
0%U4_11COMP○○○
0%U4_14RES○○○
0%U4_16LO○○○
0%U4_18SW○○○
0%U4_19HO○○○
0%U4_20BST○○○
0%D12_1HB2○○○
0%Cout1_1G4D○○○
0%D6_1BST○○○
0%Q2_4LO○○○
0%U7_7Net-(U7-SW)○○○
0%U7_8Control-Section/PG○○○
0%Q1_1SW○○○
0%D1_2Net-(D1-DOUT)○○○
0%Q1_2SW○○○
0%D1_4Net-(D1-DIN)○○○
0%U8_2Control-Section/TEMP_CTRL○○○
0%Q1_3SW○○○
0%Q1_4HO○○○
0%D5_2○○○
0%Q1_5G4D○○○
0%D5_4Net-(D4-DOUT)○○○
0%Q1_7G4D○○○
0%Q1_8G4D○○○
0%L1_1Net-(U1-VREG_LX)○○○
0%Q1_9G4D○○○
0%X1_1Control-Section/XIN○○○
0%Cout3_1G4D○○○
0%U4_12SLOPE○○○
0%D2_2Net-(D2-DOUT)○○○
0%L2_1CSN○○○
0%D2_4Net-(D1-DOUT)○○○
0%L2_2SW○○○
0%X1_3Net-(C20-Pad1)○○○
0%Cout2_1G4D○○○
0%Q2_5SW○○○
0%D11_1HB1○○○
0%L3_2Net-(U7-SW)○○○
0%Q1_6G4D○○○
0%Q2_6SW○○○
0%SW1_1Control-Section/BTN○○○
0%SW1_2Control-Section/BTN○○○
0%Q2_7SW○○○
0%CR1_2Control-Section/USB-5v○○○
0%Q2_8SW○○○
0%Q2_9SW○○○
0%D3_2Net-(D3-DOUT)○○○
0%Q6_1Q6G○○○
0%D3_4Net-(D2-DOUT)○○○
0%Q6_2BROWN○○○
0%D4_2Net-(D4-DOUT)○○○
0%U7_5Net-(U7-FB)○○○
0%D4_4Net-(D3-DOUT)○○○

14.12.6  Scoring Matrix
PCOLA/SOQ scoring premises used for this analysis. Each cell shows the score assigned when a test method applies to a component or pin.

MethodPCOLASOpensQ

AOIFullFullFull—PartialPartialPartialPartial
AXI————PartialPartialPartialPartial
JTAG/BSCANFullFullFullPartial—FullFull—
BSCAN_PassivesFullFullFullFull—FullFull—
I2CPartialPartial—Partial—PartialPartial—
SPIPartialPartial—Partial—PartialPartial—
UART———Partial————
Passive_MeasFullFullFullFull—FullFull—
Powered_OffPartial————PartialFull—

15  Component Properties
Schematic library symbol quality analysis.
15.1  Library Symbol Grades
Grading schematic library symbol quality based on pin electrical type definitions:

Grade Definitions

GradeRatingDescription

AExcellentHas Power pins AND properly typed I/O pins (>=90% typed)
BGood>=70% typed OR (>=50% typed AND has Power)
CFairMix of typed and Passive pins (>=40% typed)
DPoorMostly Passive with few typed pins (>=10% typed)
FFailAll pins Passive/Unknown (<10% typed, no ERC)

IC Library Symbol Grades (sorted worst to best)

RefDesGrdPinsPwrInOutIOOCOEHiZPasPart NumberCreator

IC1F801000007INA240A2DR
U1C611033370008RP2354A
U2C430000001AMS1117-3.3
U7C924101001TPS62160DSGR
U4B2189310000LM5122MHX/NOPB
U5B1429200001UCC27735DR
U6B1429200001UCC27735DR
U8B320100000TMP235A2DBZR
U9B320100000TMP235A2DBZR
U10A1752190000ADS7128IRTER
U3A52200001074AHCT1G125

15.1.1  Library Quality Summary

Total ICs evaluated11
Grade A (excellent)2 (18.2%)
Grade B (good)5 (45.5%)
Grade C (fair)3 (27.3%)
Grade D (poor)0 (0.0%)
Grade F (fail)1 (9.1%)
OVERALL LIBRARY QUALITYB (3.37/4.00)

15.2  Component Library Validation
Checking for generic/incomplete library symbols using statistical patterns.

Library Symbol Issues (7 symbols)

Library NameIndustry NamePart NumberRefDesPinsDistributionIssues

AMS1117-3.3AMS1117-3.3-U24P:1 Pwr:3 Power-named pins not typed as Power - library pin types incomplete [VOUT=Passive]
INA240A2DRINA240A2DR-IC18P:7 ?:1 87% of pins are Passive - suspiciously high for an IC; No Power pins - may use separate power symbol; Only 1 pin type used - no electrical differentiation; Power-named pins not typed as Power - library pin types incomplete [GND=Passive, OUT=Passive]
LM5122MHX/NOPBLM5122MHX/NOPB-U421Pwr:8 Bi:1 I:9 O:3 Power-named pins not typed as Power - library pin types incomplete [CSP=Input, SW=Bidirectional]
RP2354ARP2354A-U161P:8 Pwr:10 Bi:37 I:3 O:3 Pin 6 (DVDD) at same location as pin 39 (DVDD); Pin 6 (DVDD) at same location as pin 23 (DVDD); Pin 39 (DVDD) at same location as pin 23 (DVDD); Pin 1 (IOVDD) at same location as pin 11 (IOVDD); Pin 1 (IOVDD) at same location as pin 20 (IOVDD); Pin 1 (IOVDD) at same location as pin 30 (IOVDD); Pin 1 (IOVDD) at same location as pin 38 (IOVDD); Pin 1 (IOVDD) at same location as pin 45 (IOVDD); Pin 11 (IOVDD) at same location as pin 20 (IOVDD); Pin 11 (IOVDD) at same location as pin 30 (IOVDD); Pin 11 (IOVDD) at same location as pin 38 (IOVDD); Pin 11 (IOVDD) at same location as pin 45 (IOVDD); Pin 20 (IOVDD) at same location as pin 30 (IOVDD); Pin 20 (IOVDD) at same location as pin 38 (IOVDD); Pin 20 (IOVDD) at same location as pin 45 (IOVDD); Pin 30 (IOVDD) at same location as pin 38 (IOVDD); Pin 30 (IOVDD) at same location as pin 45 (IOVDD); Pin 38 (IOVDD) at same location as pin 45 (IOVDD); Power-named pins not typed as Power - library pin types incomplete [DVDD=Passive, DVDD=Passive]
TMP235A2DBZRTMP235A2DBZR-U8, U93Pwr:2 O:1 Power-named pins not typed as Power - library pin types incomplete [VOUT=Output]
TPS62160DSGRTPS62160DSGR-U79P:1 Pwr:2 I:4 O:1 OC:1 Power-named pins not typed as Power - library pin types incomplete [VIN=Input, SW=Output]
UCC27735DRUCC27735DR-U5, U614P:1 Pwr:2 I:5 O:2 ?:4 28% of pins are Unknown type; Power-named pins not typed as Power - library pin types incomplete [LO=Output, HO=Output]

15.2.1  Validation Heuristics
All pins same type: Generic library with no electrical rules
High % passive pins on IC: Incomplete type information
No power pins: May indicate separate power symbol
Low type diversity: Very underspecified library symbol
Power-named pins not typed as Power: Library pin types incomplete
15.3  Symbol vs Datasheet Pin Table
Each symbol's pin numbers are compared with the pin table of its datasheet. A datasheet pin the symbol lacks is a warning only when the datasheet calls it electrical; a pin the datasheet marks NC or mechanical, or a symbol pin the table does not list, is shown for information. An exposed pad is never counted as a mismatch, whether the symbol names it or numbers it one past the last pin. Where it was numbered, the row suggests giving it a name, because a bare number does not tell a reader what the pin is.
25 parts compared with their datasheet: 25 agree, 0 differ.
Every symbol compared matches its datasheet's pin table.
15.4  Shielded Connector Symbol Quality

Shielded connectors with missing pin names0

All shielded connectors have proper pin names for EMC analysis.
15.5  I/O Bank Power
Power-port association not available for U1 (RP2354A): the unpowered-pin check was not performed for these parts.
15.6  Footprints and Other Models

Components with model data30

Component Model Assignments

RefDesIndustry NamePinsModel TypeModel

D1WS2812B4FootprintLED_SMD:LED_WS2812B_PLCC4_5.0x5.0mm_P3.2mm
D2WS2812B4FootprintLED_SMD:LED_WS2812B_PLCC4_5.0x5.0mm_P3.2mm
D3WS2812B4FootprintLED_SMD:LED_WS2812B_PLCC4_5.0x5.0mm_P3.2mm
D4WS2812B4FootprintLED_SMD:LED_WS2812B_PLCC4_5.0x5.0mm_P3.2mm
D5WS2812B4FootprintLED_SMD:LED_WS2812B_PLCC4_5.0x5.0mm_P3.2mm
IC1INA240A2DR8FootprintINA240A2DR:SOIC127P600X175-8N
  (IPC-7351B)Small Outline IC, 127 pins, 6.00mm pitch
J12606-1108/010-0008FootprintLamoka1-half:CONN8_2606-1108&slash_010-000_WAG
J22606-13524FootprintLamoka1-half:CONN2_2606-1352_WAG
J3TYPE-C-31-M-1215FootprintConnector_USB:USB_C_Receptacle_HRO_TYPE-C-31-M-12
J4-1FootprintConnector_Wire:SolderWirePad_1x01_SMD_3x6mm
J52604-11036FootprintLamoka1-half:CONN3_2604-1103_WAG
J6-1FootprintConnector_Wire:SolderWirePad_1x01_SMD_3x6mm
Q1CSD16323Q39FootprintLamoka1-half:DQG0008A
Q2CSD17304Q39FootprintLamoka1-half:DQG0008A
Q3CSD19536KCS3FootprintPackage_TO_SOT_THT:TO-220-3_Vertical
Q4CSD19536KCS3FootprintPackage_TO_SOT_THT:TO-220-3_Vertical
Q5CSD19536KCS3FootprintPackage_TO_SOT_THT:TO-220-3_Vertical
Q6CSD19536KCS3FootprintPackage_TO_SOT_THT:TO-220-3_Vertical
SW1B3F-40554FootprintB3F-4055:SW_B3F-4050_OMR
U1RP2354A61FootprintPackage_DFN_QFN:QFN-60-1EP_7x7mm_P0.4mm_EP3.4x3.4mm
U2AMS1117-3.34FootprintLamoka1-half:SOT-223-3_TabPin2
U3SN74AHCT1G125DBVR5FootprintPackage_TO_SOT_SMD:SOT-23-5
U4LM5122MHX/NOPB21FootprintLamoka1-half:PWP0020A_N
U5UCC27735DR14FootprintUCC27735DR:SOIC_14L_TEX
U6UCC27735DR14FootprintUCC27735DR:SOIC_14L_TEX
U7TPS62160DSGR9FootprintLamoka1-half:DSG8_1P6X0P9
U8TMP235A2DBZR3FootprintTMP235A2DBZR:DBZ0003A-IPC_A
U9TMP235A2DBZR3FootprintTMP235A2DBZR:DBZ0003A-IPC_A
U10ADS7128IRTER17FootprintADS7128IRTER:WQFN16_RTE_TEX
X1ABM8-272-T34FootprintABM8-272-T3:ABM8272T3

15.7  IC Pin Electrical Properties

Unique IC symbols9
Total IC instances11

IC Library Symbols

Industry NameLibrary NameRefDesNotes

SN74AHCT1G125DBVR74AHCT1G125U3
ADS7128IRTERADS7128IRTERU10
AMS1117-3.3AMS1117-3.3U2
INA240A2DRINA240A2DRIC1
LM5122MHX/NOPBLM5122MHX/NOPBU4
RP2354ARP2354AU1
TMP235A2DBZRTMP235A2DBZRU8, U9
TPS62160DSGRTPS62160DSGRU7
UCC27735DRUCC27735DRU5, U6

15.7.1  74AHCT1G125 (SN74AHCT1G125DBVR)

PinPin NameElectricalNotes

1Input
2Input
3GNDPower In
4High Impedance
5VCCPower In

15.7.2  ADS7128IRTER (ADS7128IRTER)

PinPin NameElectricalNotes

1AIN2/GPIO2Bidirectional
2AIN3/GPIO3Bidirectional
3AIN4/GPIO4Bidirectional
4AIN5/GPIO5Bidirectional
5AIN6/GPIO6Bidirectional
6AIN7/GPIO7Bidirectional
7AVDDPower In
8DECAPPower In
9GNDPower In
10DVDDPower In
11ADDRInput
12ALERTOutput
13SCLInput
14SDABidirectional
15AIN0/GPIO0Bidirectional
16AIN1/GPIO1Bidirectional
17GNDPower In

15.7.3  AMS1117-3.3 (AMS1117-3.3)

PinPin NameElectricalNotes

1GNDPower Out
2VOUTPower Out
3VINPower In
4VOUTPassive

15.7.4  INA240A2DR (INA240A2DR)

PinPin NameElectricalNotes

1IN-Passive
2GNDPassive
3REF2Passive
4NCUnknown
5OUTPassive
6VSPassive
7REF1Passive
8IN+Passive

15.7.5  LM5122MHX/NOPB (LM5122MHX/NOPB)

PinPin NameElectricalNotes

1SYNCOUTOutput
2OPTInput
3CSNInput
4CSPInput
5VINPower In
6UVLOInput
7SSInput
8SYNCIN_RTInput
9AGNDPower In
10FBInput
11COMPOutput
12SLOPEInput
13MODEInput
14RESOutput
15PGNDPower In
16LOPower In
17VCCPower In
18SWBidirectional
19HOPower In
20BSTPower In
21PADPower In

15.7.6  RP2354A (RP2354A)

PinPin NameElectricalNotes

1IOVDDPower In
2GPIO0Bidirectional
3GPIO1Bidirectional
4GPIO2Bidirectional
5GPIO3Bidirectional
6DVDDPower In
7GPIO4Bidirectional
8GPIO5Bidirectional
9GPIO6Bidirectional
10GPIO7Bidirectional
11IOVDDPassive
12GPIO8Bidirectional
13GPIO9Bidirectional
14GPIO10Bidirectional
15GPIO11Bidirectional
16GPIO12Bidirectional
17GPIO13Bidirectional
18GPIO14Bidirectional
19GPIO15Bidirectional
20IOVDDPassive
21XINInput
22XOUTOutput
23DVDDPassive
24SWCLKInput
25SWDIOBidirectional
26RUNInput
27GPIO16Bidirectional
28GPIO17Bidirectional
29GPIO18Bidirectional
30IOVDDPassive
31GPIO19Bidirectional
32GPIO20Bidirectional
33GPIO21Bidirectional
34GPIO22Bidirectional
35GPIO23Bidirectional
36GPIO24Bidirectional
37GPIO25Bidirectional
38IOVDDPassive
39DVDDPassive
40GPIO26/ADC0Bidirectional
41GPIO27/ADC1Bidirectional
42GPIO28/ADC2Bidirectional
43GPIO29/ADC3Bidirectional
44ADC_AVDDPower In
45IOVDDPassive
46VREG_AVDDPower In
47VREG_PGNDPower In
48VREG_LXPower Out
49VREG_VINPower In
50VREG_FBPassive
51USB_DMBidirectional
52USB_DPBidirectional
53USB_OTP_VDDPower In
54QSPI_IOVDDPower In
55QSPI_SD3Bidirectional
56QSPI_SCLKOutput
57QSPI_SD0Bidirectional
58QSPI_SD2Bidirectional
59QSPI_SD1Bidirectional
60QSPI_SSOutput
61GNDPower In

15.7.7  TMP235A2DBZR (TMP235A2DBZR)

PinPin NameElectricalNotes

1VDDPower In
2VOUTOutput
3GNDPower In

15.7.8  TPS62160DSGR (TPS62160DSGR)

PinPin NameElectricalNotes

1PGNDPower In
2VINInput
3ENInput
4AGNDPower In
5FBPassive
6VOSInput
7SWOutput
8PGOpen Collector
9EPADInput

15.7.9  UCC27735DR (UCC27735DR)

PinPin NameElectricalNotes

1HIInput
2LIInput
3VSSPower In
4EN/NCInput
5COMPassive
6LOOutput
7VDDPower In
8NCUnknown
9NCUnknown
10NCUnknown
11HSInput
12HOOutput
13HBInput
14NCUnknown

Generated by Tomachie v5.142 2026-10-19 23:12:51
https://tomachie.com

Copyright © 2026 Tomachie LLC. All rights reserved.
