bearjhartjen/Lamoka1-half/HARDWARE/Lamoka1-half fab files/Lamoka1-2_PCBWay_Turnkey_2026-10-29/board_bottom.png

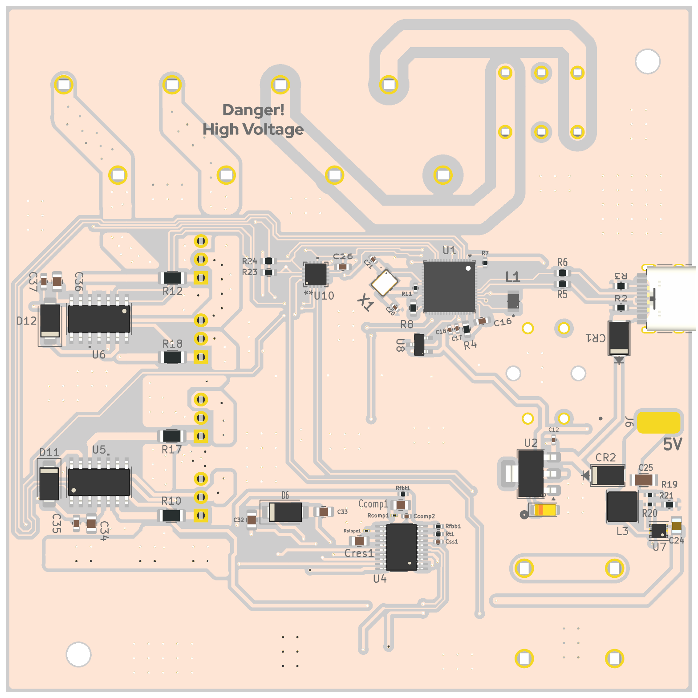
HARDWARE/Lamoka1-half fab files/Lamoka1-2_PCBWay_Turnkey_2026-10-29/board_bottom.png
