bearjhartjen/Lamoka1-half/Images/lamoka1-2-render-bottom.png

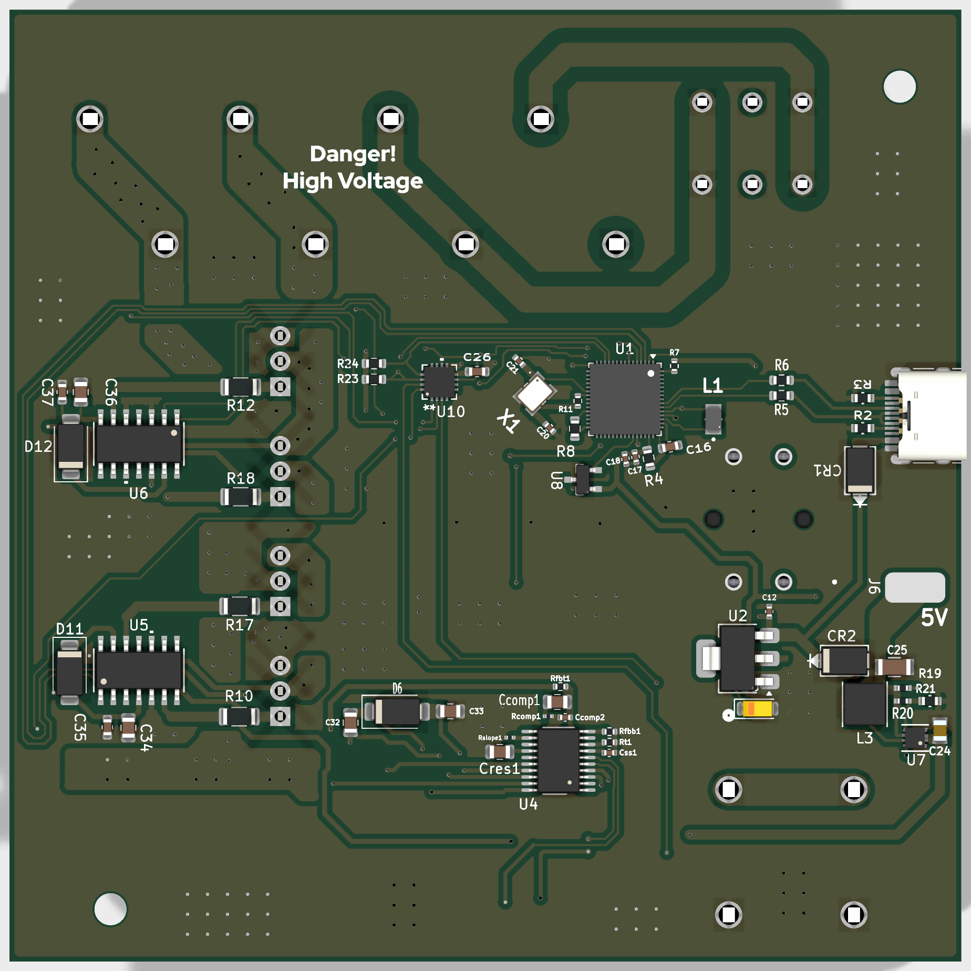
Images/lamoka1-2-render-bottom.png
