bearjhartjen/Lamoka1-half/Images/lamoka1-2-render-top.png

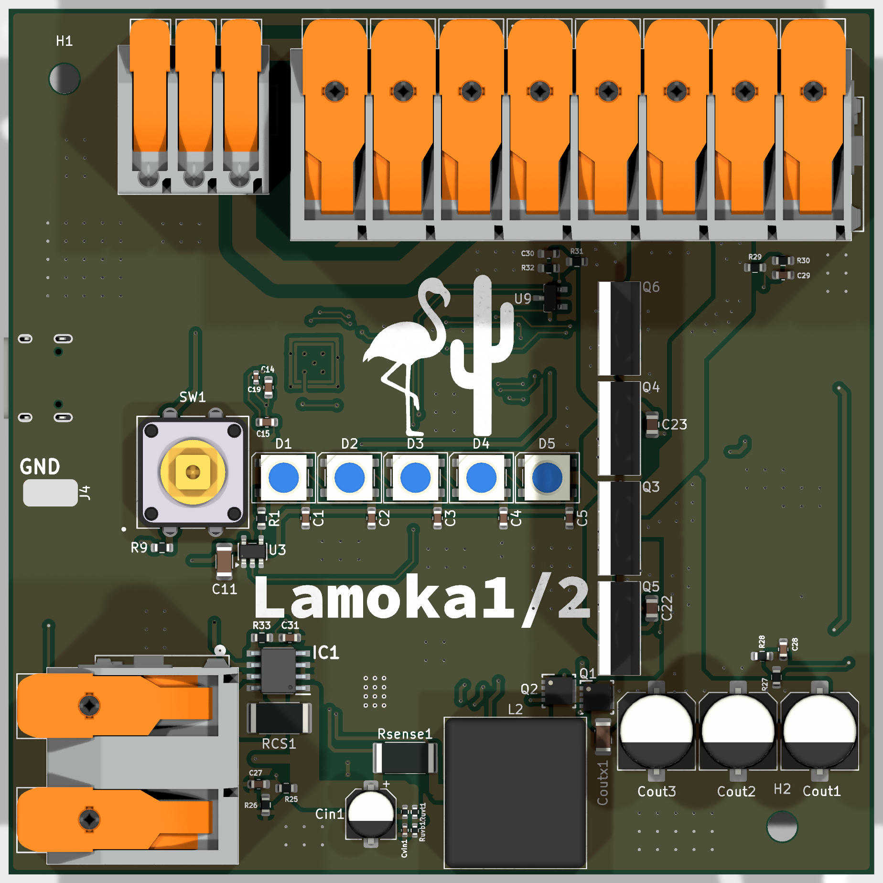
Images/lamoka1-2-render-top.png
