bearjhartjen/Lamoka1-half/HARDWARE/Lamoka1-half fab files/PCBway files/T-1N14W1065266A-1units-BOM_Lamoka1-half_turnkey_FIXED(2026-11-02).xls

PCBWay Bom Quotation, Product No.:T-1N14W1065266A
Item # | *Designator | *Qty | Manufacturer | *Mfg Part # | Description / Value | *Package/Footprint | Category | *Unit Price(1 unit) | *Total | *Delivery Time | *Actual Purchase Mfg Part # | *PCBWay Note | Customer Reply | PCBWay Update
1 | C11 | 1 | Murata | GRM31CR61A107MEA8K | GRM31CR61A107MEA8K『 』Capacitor, 100 uF, 1206 | 1206 | SMT | $1.943 | $1.943
2 | C12 | 1 | Samsung Electro-Mechanics | CL05A106MQ5NUNC | CL05A106MQ5NUNC『 』Capacitor, 10 uF, 0402, AMS1117 5 V input | 0402 | SMT | $0.692 | $0.692
3 | C13 | 1 | KEMET | T491A226K010AT | T491A226K010AT『 』Tantalum capacitor, 22 uF, 10 V, 3216 (A case), 3.3 V rail output | 3216 (A case) | SMT | $0.856 | $0.856
4 | C16,C14,C15 | 3 | Samsung Electro-Mechanics | CL10A475KP8NNNC | CL10A475KP8NNNC『 』Capacitor, 4.7 uF, 0603 | 0603 | SMT | $0.124 | $0.372
5 | C17,C18,C19 | 3 | Samsung Electro-Mechanics | CL05B104KO5NNNC | CL05B104KO5NNNC『 』Capacitor, 100 nF, 0402 | 0402 | SMT | $0.031 | $0.093
6 | C20,C21 | 2 | Fenghua (Guangdong Fenghua Advanced Tech) | 0402CG150J500NT | 0402CG150J500NT『 』Capacitor, 15 pF, C0G, 0402 | 0402 | SMT | $0.053 | $0.106
7 | C23,C22 | 2 | Murata | GRM21BR71H105KA12L | GRM21BR71H105KA12L『 』Capacitor, 1 uF, 0805 | 0805 | SMT | $0.638 | $1.276
8 | C24 | 1 | Taiyo Yuden | TMK212BBJ106KG-T | TMK212BBJ106KG-T『 』Capacitor, 10 uF, 0805 | 0805 | SMT | $3.083 | $3.083
9 | C25 | 1 | Murata | GRM31CR71A226KE15L | GRM31CR71A226KE15L『 』Capacitor, 22 uF, 1206 | 1206 | SMT | $3.762 | $3.762
10 | C26 | 1 | Samsung Electro-Mechanics | CL10A105KA8NNNC | CL10A105KA8NNNC『 』Capacitor, 1 uF, 0603 | 0603 | SMT | $0.781 | $0.781
11 | C29,C28,C30,C27 | 4 | Samsung Electro-Mechanics | CL10B473KB8NNNC | CL10B473KB8NNNC『 』Capacitor, 47 nF, 0603 | 0603 | SMT | $0.045 | $0.180
12 | C3,C2,C1,C5,C4 | 5 | Samsung Electro-Mechanics | CL10B104KO8NNNC | CL10B104KO8NNNC『 』Capacitor, 100 nF, 0603 | 0603 | SMT | $0.058 | $0.290
13 | C31,C35,C37 | 3 | Samsung Electro-Mechanics | CL10B104KB8NNNC | CL10B104KB8NNNC『 』Capacitor, 100 nF, 50 V X7R, 0603, gate driver VDD bypass and monitor-input filter | 0603 | SMT | $0.072 | $0.216
14 | C32 | 1 | KYOCERA AVX | 08053C104KAT2A | 08053C104KAT2A『 』Capacitor, 100 nF, 0805 | 0805 | SMT | $2.296 | $2.296 | 7-10 Workdays
15 | C33 | 1 | Taiyo Yuden | MSAST21GAB5475MTNAO1 | MSAST21GAB5475MTNAO1『 』Capacitor, 4.7 uF, 0805 | 0805 | SMT | $1.420 | $1.420 |  | HGC0805R7475K500NSLJ | incorrect original part number, we will provide HGC0805R7475K500NSLJ（0805 4.7uF ±10% 50V X7R）, ok?
16 | C36,C34 | 2 | Murata | GRM21BZ71E106KE15L | GRM21BZ71E106KE15L『 』Capacitor, 10 uF, 25 V X7R, 0805, gate driver VDD bypass | 0805 | SMT | $4.354 | $8.708
17 | CR1,CR2 | 2 | Vishay Semiconductors | SS14-E3/61T | SS14-E3/61T『 』40 V, 1 A Schottky rectifier, SMA (DO-214AC) | SMA (DO-214AC) | SMT | $0.302 | $0.604
18 | Ccomp1 | 1 | TDK | CGA4F1C0G2A153J085AE | CGA4F1C0G2A153J085AE『 』Capacitor, 15 nF, C0G, 0805, boost loop compensation | 0805 | SMT | $1.575 | $1.575
19 | Ccomp2 | 1 | Murata | GRM1555C1H448JA01D | GRM1555C1H448JA01D『 』Capacitor, 44.8 pF, C0G, 0402, boost loop compensation | 0402 | SMT | $0.112 | $0.112 |  | 0402CG470J500NT | incorrect original part number, we cannot find part meet “44.8 pF, C0G, 0402”, you replied: do not substitute 47pF，do you need 47pF？if yes, we will use 0402CG470J500NT（47pF C0G 0402 ±5% 50V）, ok?
20 | Cin1 | 1 | Panasonic Industry | 20SVPF56MX | 20SVPF56MX『 』Polymer aluminium capacitor, 56 uF, 20 V, 5 x 5.9 mm, boost input | SMD radial can 5 x 5.9 mm | SMT | $2.214 | $2.214
21 | Cout1 | 1 | Panasonic Industry | 35SVPK180M | 35SVPK180M『 』Polymer aluminium capacitor, 180 uF, 35 V, 8 x 11.9 mm, boost output | SMD radial can 8 x 11.9 mm | SMT | $1.151 | $1.151
22 | Cout2 | 1 | Panasonic Industry | 35SVPK180M | 35SVPK180M『 』Polymer aluminium capacitor, 180 uF, 35 V, 8 x 11.9 mm, boost output | SMD radial can 8 x 11.9 mm | SMT | $1.151 | $1.151
23 | Cout3 | 1 | Panasonic Industry | 35SVPK180M | 35SVPK180M『 』Polymer aluminium capacitor, 180 uF, 35 V, 8 x 11.9 mm, boost output | SMD radial can 8 x 11.9 mm | SMT | $1.151 | $1.151
24 | Coutx1 | 1 | TDK | C3216X5R1V226M160AC | C3216X5R1V226M160AC『 』Capacitor, 22 uF, 35 V X5R, 1206, boost output bus | 1206 | SMT | $1.050 | $1.050
25 | Cres1 | 1 | Taiyo Yuden | TMK212BJ474KD-T | TMK212BJ474KD-T『 』Capacitor, 470 nF, 0805 | 0805 | SMT | $1.252 | $1.252
26 | Css1 | 1 | Murata | GRM155R71A333KA01D | GRM155R71A333KA01D『 』Capacitor, 33 nF, 0402 | 0402 | SMT | $2.107 | $2.107
27 | Cvin1 | 1 | TDK | C1005X5R1V474K050BC | C1005X5R1V474K050BC『 』Capacitor, 470 nF, 0402 | 0402 | SMT | $2.237 | $2.237 | 7-10 Workdays
28 | D1,D5,D2,D3,D4 | 5 | Worldsemi | WS2812B | WS2812B『 』Addressable RGB LED, 5050 PLCC-4, WS2812B pinout/protocol (D1-D5); place with chamfer on footprint chamfer | PLCC-4 5.0 x 5.0 mm | SMT | $0.229 | $1.145 |  | WS2812B-V6 | The part number you provided is incomplete, we will supply Complete part WS2812B-V6 ,Please confirm.
29 | D12,D11 | 2 | Vishay Semiconductors | SS14-E3/61T | SS14-E3/61T『 』40 V, 1 A Schottky rectifier, SMA (DO-214AC) | SMA (DO-214AC) | SMT | $0.196 | $0.392
30 | D6 | 1 | SMC Diode Solutions | SK215ATR | SK215ATR『 』150 V, 2 A Schottky rectifier, SMA (DO-214AC), boost bootstrap diode | SMA (DO-214AC) | SMT | $1.595 | $1.595 | 7-10 Workdays | SK215A | SK215A（1801-SK215ACT-ND ），Brand : Taiwan Semiconductor Corporation, pls confirm.
31 | IC1 | 1 | Texas Instruments | INA240A2DR | INA240A2DR『 』Bidirectional current-sense amplifier with enhanced PWM rejection, SOIC-8 | SOIC-8 | SMT | $2.113 | $2.113
32 | J1 | 1 | WAGO | 2606-1108/010-000 | 2606-1108/010-000『 』PCB terminal block, 8-pin two-row stagger, 7.5 mm pitch, 12.5 mm row spacing (J1) | 7.5 mm pitch, 8 pin | THT | $41.861 | $167.444 | 15-20 Workdays |  | [moq=4]; extra ship to you
33 | J2 | 1 | WAGO | 2606-1352 | 2606-1352『 』PCB terminal block, 2-pole double-pinned, 7.5 mm pitch (J2) | 7.5 mm pitch, 2 pin | THT | $13.614 | $13.614 | 7-10 Workdays
34 | J3 | 1 | Korean Hroparts Elec | TYPE-C-31-M-12 | TYPE-C-31-M-12『 』USB 2.0 Type-C receptacle, 16 pin SMD with through-hole shield, right angle | 16 pin, right angle | SMT + THT shield | $0.682 | $0.682
35 | J5 | 1 | WAGO | 2604-1103 | 2604-1103『 』PCB terminal block, lever, 3-pole, 5.0 mm pitch, push-in CAGE CLAMP (J5) | 5.0 mm pitch, 3 pin | THT | $9.456 | $9.456 | 7-10 Workdays
36 | L1 | 1 | Abracon | AOTA-B201610S3R3-101-T | AOTA-B201610S3R3-101-T『 』Molded shielded power inductor, 3.3 uH, 2.0 x 1.6 x 1.0 mm, MCU core regulator | 2.0 x 1.6 x 1.0 mm | SMT | $0.658 | $0.658 | 7-10 Workdays
37 | L2 | 1 | Coilcraft | XAL1580-182MEB | XAL1580-182MEB『 』Shielded power inductor, 1.8 uH, XAL1580 series | XAL1580 | SMT | $16.363 | $49.089 |  |  | [moq=3]; extra ship to you
38 | L3 | 1 | Pulse Electronics | PA4332.222NLT | PA4332.222NLT『 』Shielded drum-core power inductor, 2.2 uH, 4.2 x 4.2 x 2.0 mm | 4.2 x 4.2 x 2.0 mm | SMT | $1.561 | $1.561 | 7-10 Workdays
39 | Q2,Q1 | 2 | Texas Instruments | CSD17304Q3 | CSD17304Q3『 』N-channel NexFET power MOSFET with thermal pad, VSON-8, 30 V, boost converter switching pair | VSON-8 (DQG) | SMT | $1.364 | $2.728
40 | Q3,Q4,Q5,Q6 | 4 | Texas Instruments | CSD19536KCS | CSD19536KCS『 』N-channel NexFET power MOSFET, TO-220, H-bridge switch | TO-220 | THT | $10.206 | $40.824 | 7-10 Workdays |  | updated to newer version, more expensive
41 | R1 | 1 | Yageo | RC0603FR-07330RL | RC0603FR-07330RL『 』Resistor, 330 Ohm, 1 %, 0603 | 0603 | SMT | $0.062 | $0.062
42 | R10,R17,R18,R12 | 4 | Yageo | RC1206FR-0710RL | RC1206FR-0710RL『 』Resistor, 10 Ohm, 1 %, 1206 | 1206 | SMT | $0.164 | $0.656
43 | R19 | 1 | Yageo | RC0603FR-07180KL | RC0603FR-07180KL『 』Resistor, 180 kOhm, 1 %, 0603 | 0603 | SMT | $0.088 | $0.088
44 | R2,R3 | 2 | Yageo | RC0603FR-075K1L | RC0603FR-075K1L『 』Resistor, 5.1 kOhm, 1 %, 0603, USB-C CC pull-down | 0603 | SMT | $0.028 | $0.056
45 | R20 | 1 | Vishay | CRCW0402953KFKED | CRCW0402953KFKED『 』Resistor, 953 kOhm, 1 %, 0402 | 0402 | SMT | $0.463 | $0.463
46 | R21 | 1 | Vishay | CRCW0402100KFKED | CRCW0402100KFKED『 』Resistor, 100 kOhm, 1 %, 0402 | 0402 | SMT | $0.097 | $0.097
47 | R23 | 1 | Yageo | RC0603FR-074K7L | RC0603FR-074K7L『 』Resistor, 4.7 kOhm, 1 %, 0603 | 0603 | SMT | $0.084 | $0.084
48 | R24 | 1 | Yageo | RC0603FR-074K7L | RC0603FR-074K7L『 』Resistor, 4.7 kOhm, 1 %, 0603 | 0603 | SMT | $0.084 | $0.084
49 | R25 | 1 | Yageo | RC0603FR-0736K5L | RC0603FR-0736K5L『 』Resistor, 36.5 kOhm, 1 %, 0603 | 0603 | SMT | $0.066 | $0.066
50 | R29,R27,R31 | 3 | Yageo | RC0603FR-0768KL | RC0603FR-0768KL『 』Resistor, 68 kOhm, 1 %, 0603 | 0603 | SMT | $0.029 | $0.087
51 | R33 | 1 | Yageo | RC0603FR-0722RL | RC0603FR-0722RL『 』Resistor, 22 Ohm, 1 %, 0603 | 0603 | SMT | $0.066 | $0.066
52 | R4 | 1 | Yageo | RC0603FR-0733RL | RC0603FR-0733RL『 』Resistor, 33 Ohm, 1 %, 0603 | 0603 | SMT | $0.088 | $0.088
53 | R6,R5 | 2 | Yageo | RC0603FR-0727RL | RC0603FR-0727RL『 』Resistor, 27 Ohm, 1 %, 0603 | 0603 | SMT | $0.044 | $0.088
54 | R7,R11 | 2 | Yageo | RC0402FR-071KL | RC0402FR-071KL『 』Resistor, 1 kOhm, 1 %, 0402 | 0402 | SMT | $0.035 | $0.070
55 | R8,R28,R30,R32,R26,R9 | 6 | Yageo | RC0603FR-0710KL | RC0603FR-0710KL『 』Resistor, 10 kOhm, 1 %, 0603 | 0603 | SMT | $0.015 | $0.090
56 | RCS1,Rsense1 | 2 | Stackpole | CSNL2512FT2L00 | CSNL2512FT2L00『 』Current-sense resistor, 2 mOhm, 1 %, 2 W, 2512 (boost switch and input monitor shunts) | 2512 | SMT | $2.825 | $5.650
57 | Rcomp1 | 1 | Yageo | RC0201FR-0780K6L | RC0201FR-0780K6L『 』Resistor, 80.6 kOhm, 1 %, 0201, boost loop compensation | 0201 | SMT | $0.536 | $0.536
58 | Rfbb1 | 1 | Vishay | CRCW04023K79FKED | CRCW04023K79FKED『 』Resistor, 3.79 kOhm, 1 %, 0402 | 0402 | SMT | $3.678 | $3.678 | 7-10 Workdays | RN73H1ETTP3791F50
59 | Rfbt1 | 1 | Vishay | CRCW040264K9FKED | CRCW040264K9FKED『 』Resistor, 64.9 kOhm, 1 %, 0402, boost bus feedback divider | 0402 | SMT | $0.088 | $0.088
60 | Rslope1 | 1 | Yageo | RC0201FR-0749K9L | RC0201FR-0749K9L『 』Resistor, 49.9 kOhm, 1 %, 0201, slope compensation | 0201 | SMT | $0.139 | $0.139
61 | Rt1 | 1 | Vishay | CRCW040218K2FKED | CRCW040218K2FKED『 』Resistor, 18.2 kOhm, 1 %, 0402 | 0402 | SMT | $0.970 | $0.970
62 | Ruvb1 | 1 | Vishay | CRCW04027K15FKED | CRCW04027K15FKED『 』Resistor, 7.15 kOhm, 1 %, 0402 | 0402 | SMT | $1.050 | $1.050
63 | Ruvt1 | 1 | Vishay | CRCW040249K9FKED | CRCW040249K9FKED『 』Resistor, 49.9 kOhm, 1 %, 0402 | 0402 | SMT | $0.084 | $0.084
64 | Rvin1 | 1 | Vishay | CRCW04023R01FKED | CRCW04023R01FKED『 』Resistor, 3.01 Ohm, 1 %, 0402 | 0402 | SMT | $0.348 | $0.348
65 | SW1 | 1 | Omron | B3F-4055 | B3F-4055『 』Through-hole tactile switch, 12 x 12 mm, user button | 12 x 12 mm | THT | $0.342 | $0.342
66 | U1 | 1 | Raspberry Pi | RP2354A | RP2354A『 』MCU RP2354A0A4, ARM Cortex-M33, QFN-60 7x7 mm 0.4 mm pitch (U1) | VQFN-60 7 x 7 mm | SMT | $2.174 | $2.174
67 | U10 | 1 | Texas Instruments | ADS7128IRTER | ADS7128IRTER『 』8-channel 12-bit analog-to-digital converter with I2C interface, WQFN-16 | WQFN-16 | SMT | $2.717 | $2.717
68 | U2 | 1 | Advanced Monolithic Systems | AMS1117-3.3 | AMS1117-3.3『 』LDO 3.3 V 800 mA SOT-223 (U2); exact AMS1117-3.3 or pin-compatible LD1117S33TR | SOT-223 | SMT | $0.598 | $0.598 |  | AMS117-3.3 | AMS117-3.3，Brand : UMW Footprint ：SOT-223 ，Made in China , pls confirm.
69 | U3 | 1 | Texas Instruments | SN74AHCT1G125DBVR | SN74AHCT1G125DBVR『 』Single tri-state buffer, SOT-23-5, LED data level shifter | SOT-23-5 | SMT | $0.221 | $0.221
70 | U4 | 1 | Texas Instruments | LM5122MHX/NOPB | LM5122MHX/NOPB『 』Wide-input synchronous boost controller with integrated gate drivers, HTSSOP-20 (PowerPAD) | HTSSOP-20 (PWP) | SMT | $1.711 | $1.711
71 | U6,U5 | 2 | Texas Instruments | UCC27735DR | UCC27735DR『 』Dual-channel high- and low-side gate driver for the H-bridge, SOIC-14 | SOIC-14 | SMT | $3.751 | $7.502 | 7-10 Workdays
72 | U7 | 1 | Texas Instruments | TPS62160DSGR | TPS62160DSGR『 』Synchronous step-down (buck) converter for the 5 V control rail, WSON-8 | WSON-8 (DSG) | SMT | $1.590 | $1.590
73 | U8,U9 | 2 | Texas Instruments | TMP235A2DBZR | TMP235A2DBZR『 』Analog temperature sensor, SOT-23-3 | SOT-23-3 | SMT | $0.589 | $1.178
74 | X1 | 1 | Abracon | ABM8-272-T3 | ABM8-272-T3『 』Crystal, 12.000 MHz, 10 pF load, 3.2 x 2.5 mm | 3.2 x 2.5 mm | SMT | $0.785 | $0.785
 |  |  |  |  |  |  |  | Component Cost | $365.49
 |  |  |  |  |  |  |  | Assembly Cost | $29.00
 |  |  |  |  |  |  |  | PCB Cost | $5.00
 |  |  |  |  |  |  |  | V1 Member 1% off | -$0.34
 |  |  |  |  |  |  |  | All Total 1 Units | $399.15
