bearjhartjen/Lamoka1-half/HARDWARE/Mechanical/Lamoka1-half.stl

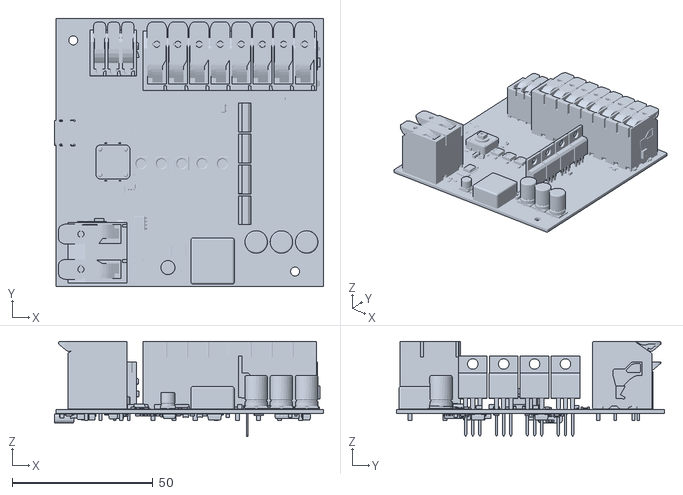
[picture p6: CAD file, 2026-10-27]
HARDWARE/Mechanical/Lamoka1-half.stl
95.5 x 95.0 x 33.8
