bearjhartjen/Lamoka1-half/Build/Schematic_Lamoka1-half.pdf

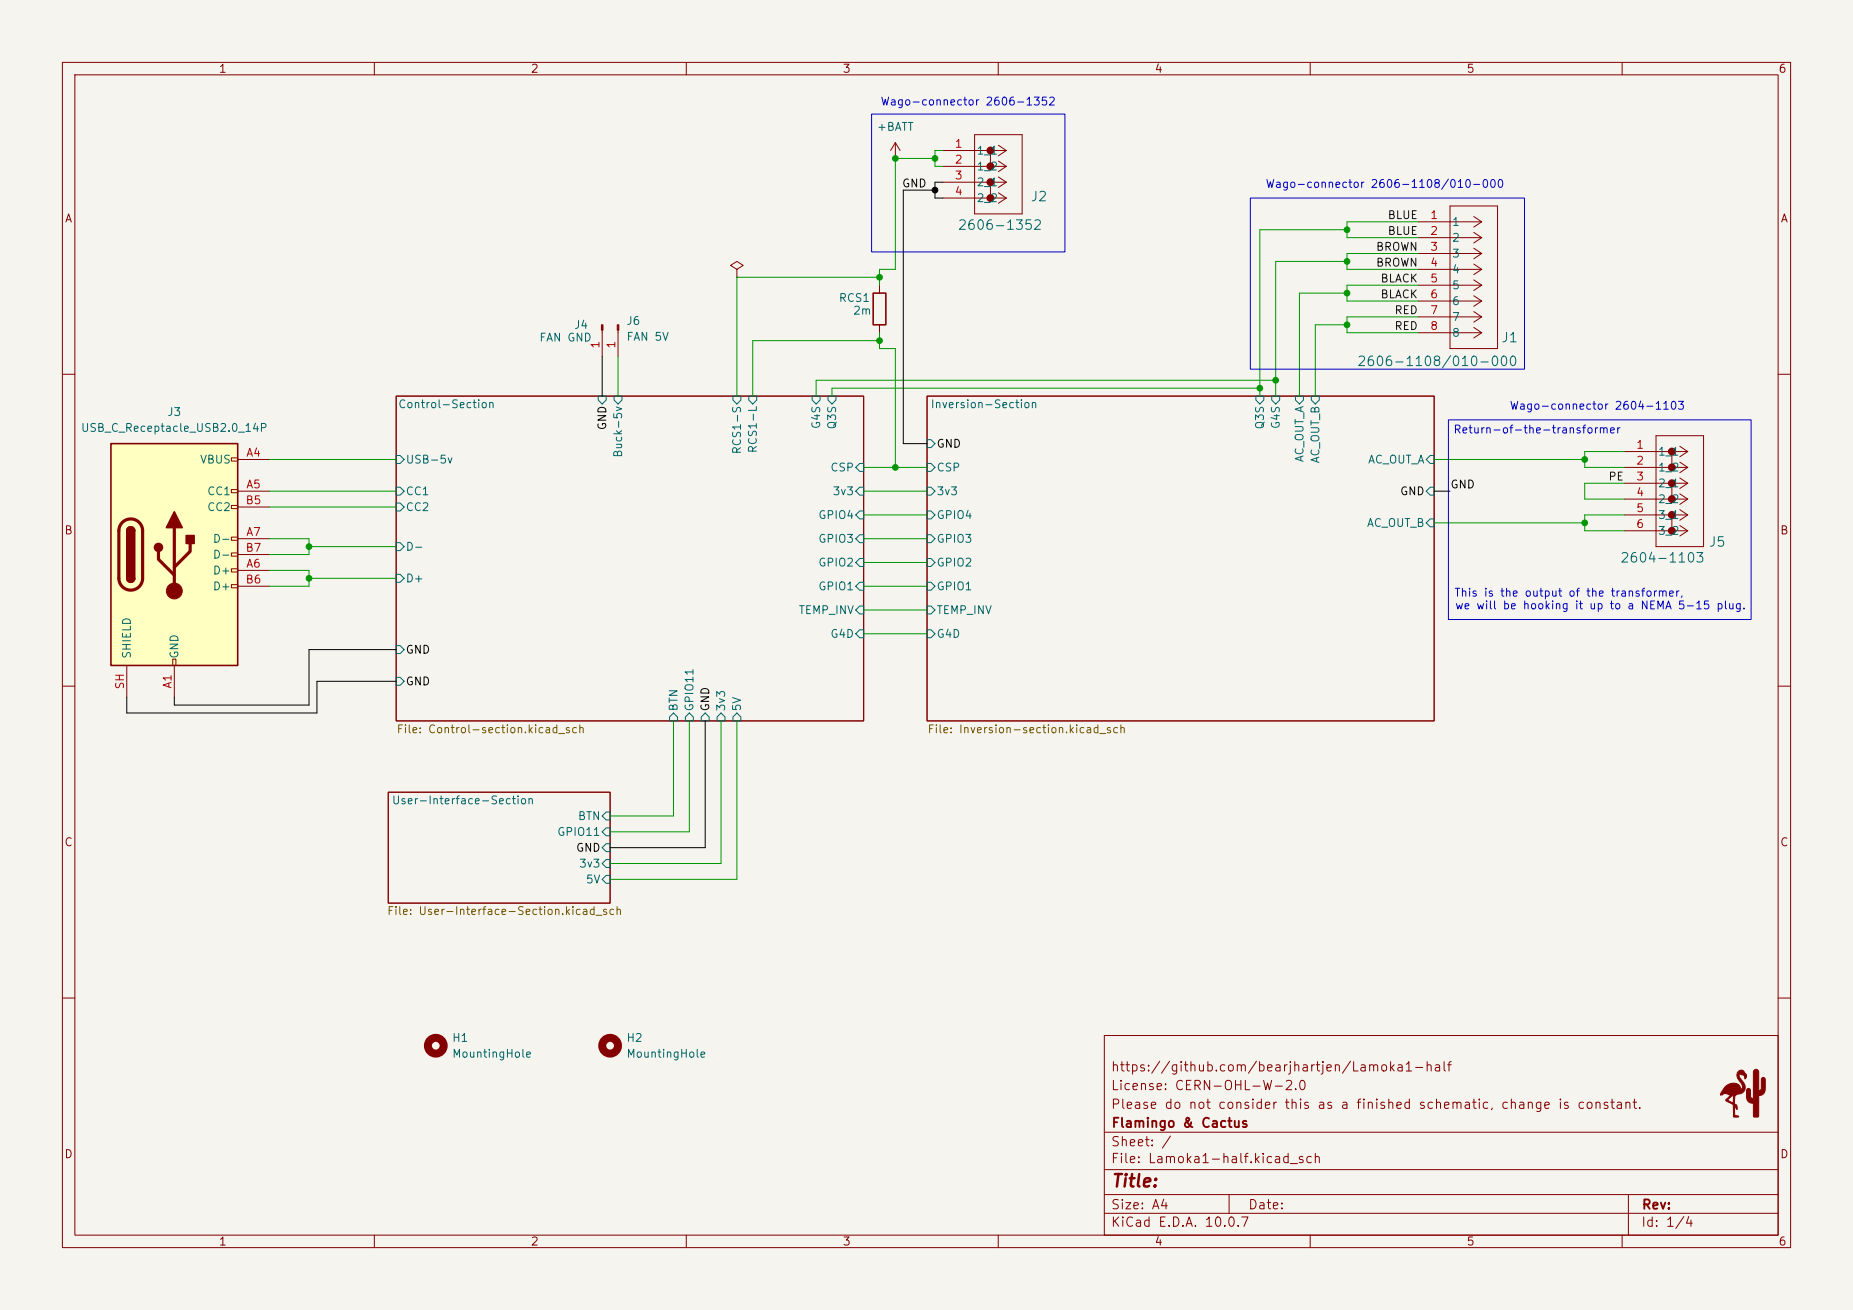
[picture p7: page 1]

Wago-connector 2604-1103 Wago-connector 2606-1108/010-000

File: Inversion-section.kicad_sch GPIO4 GPIO3 GPIO2 GPIO1 CSP

This is the output of the transformer,

File: Control-section.kicad_sch5V GPIO11 GND

File: User-Interface-Section.kicad_sch

https://github.com/bearjhartjen/Lamoka1-half
License: CERN-OHL-W-2.0
Please do not consider this as a finished schematic, change is constant.
Flamingo & Cactus
Sheet: /
File: Lamoka1-half.kicad_sch
Title:

Size: A4 | Rev:
KiCad E.D.A. 10.0.7 | Id: 1/4

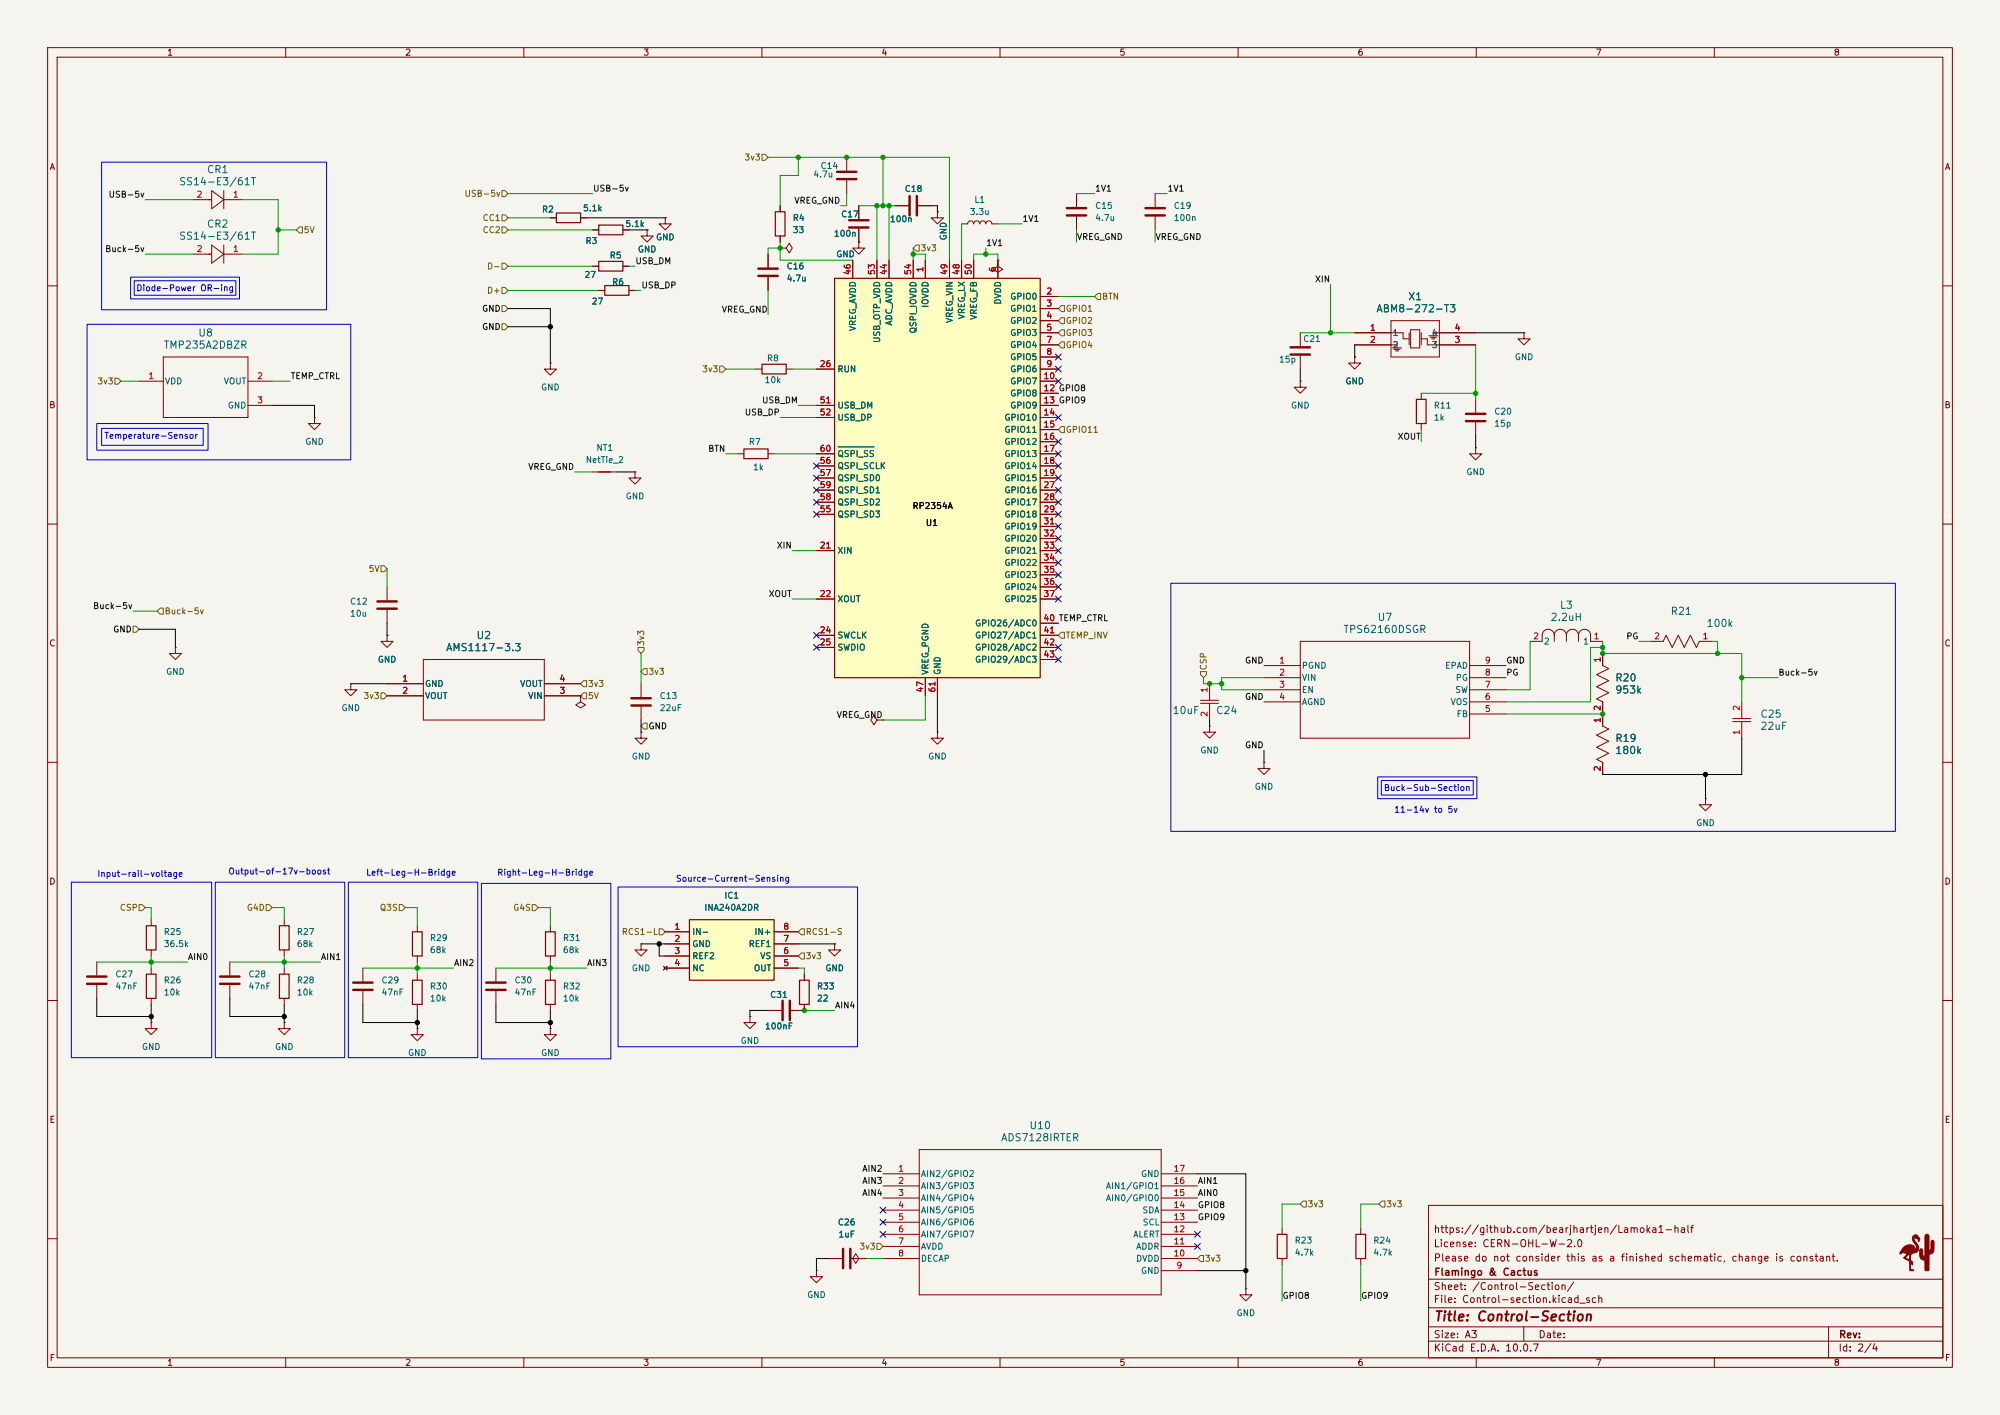
[picture p8: page 2]

Temperature-Sensor Diode-Power OR-ing

https://github.com/bearjhartjen/Lamoka1-half
License: CERN-OHL-W-2.0
Please do not consider this as a finished schematic, change is constant.
Flamingo & Cactus
Sheet: /Control-Section/
File: Control-section.kicad_sch
Title: Control-Section

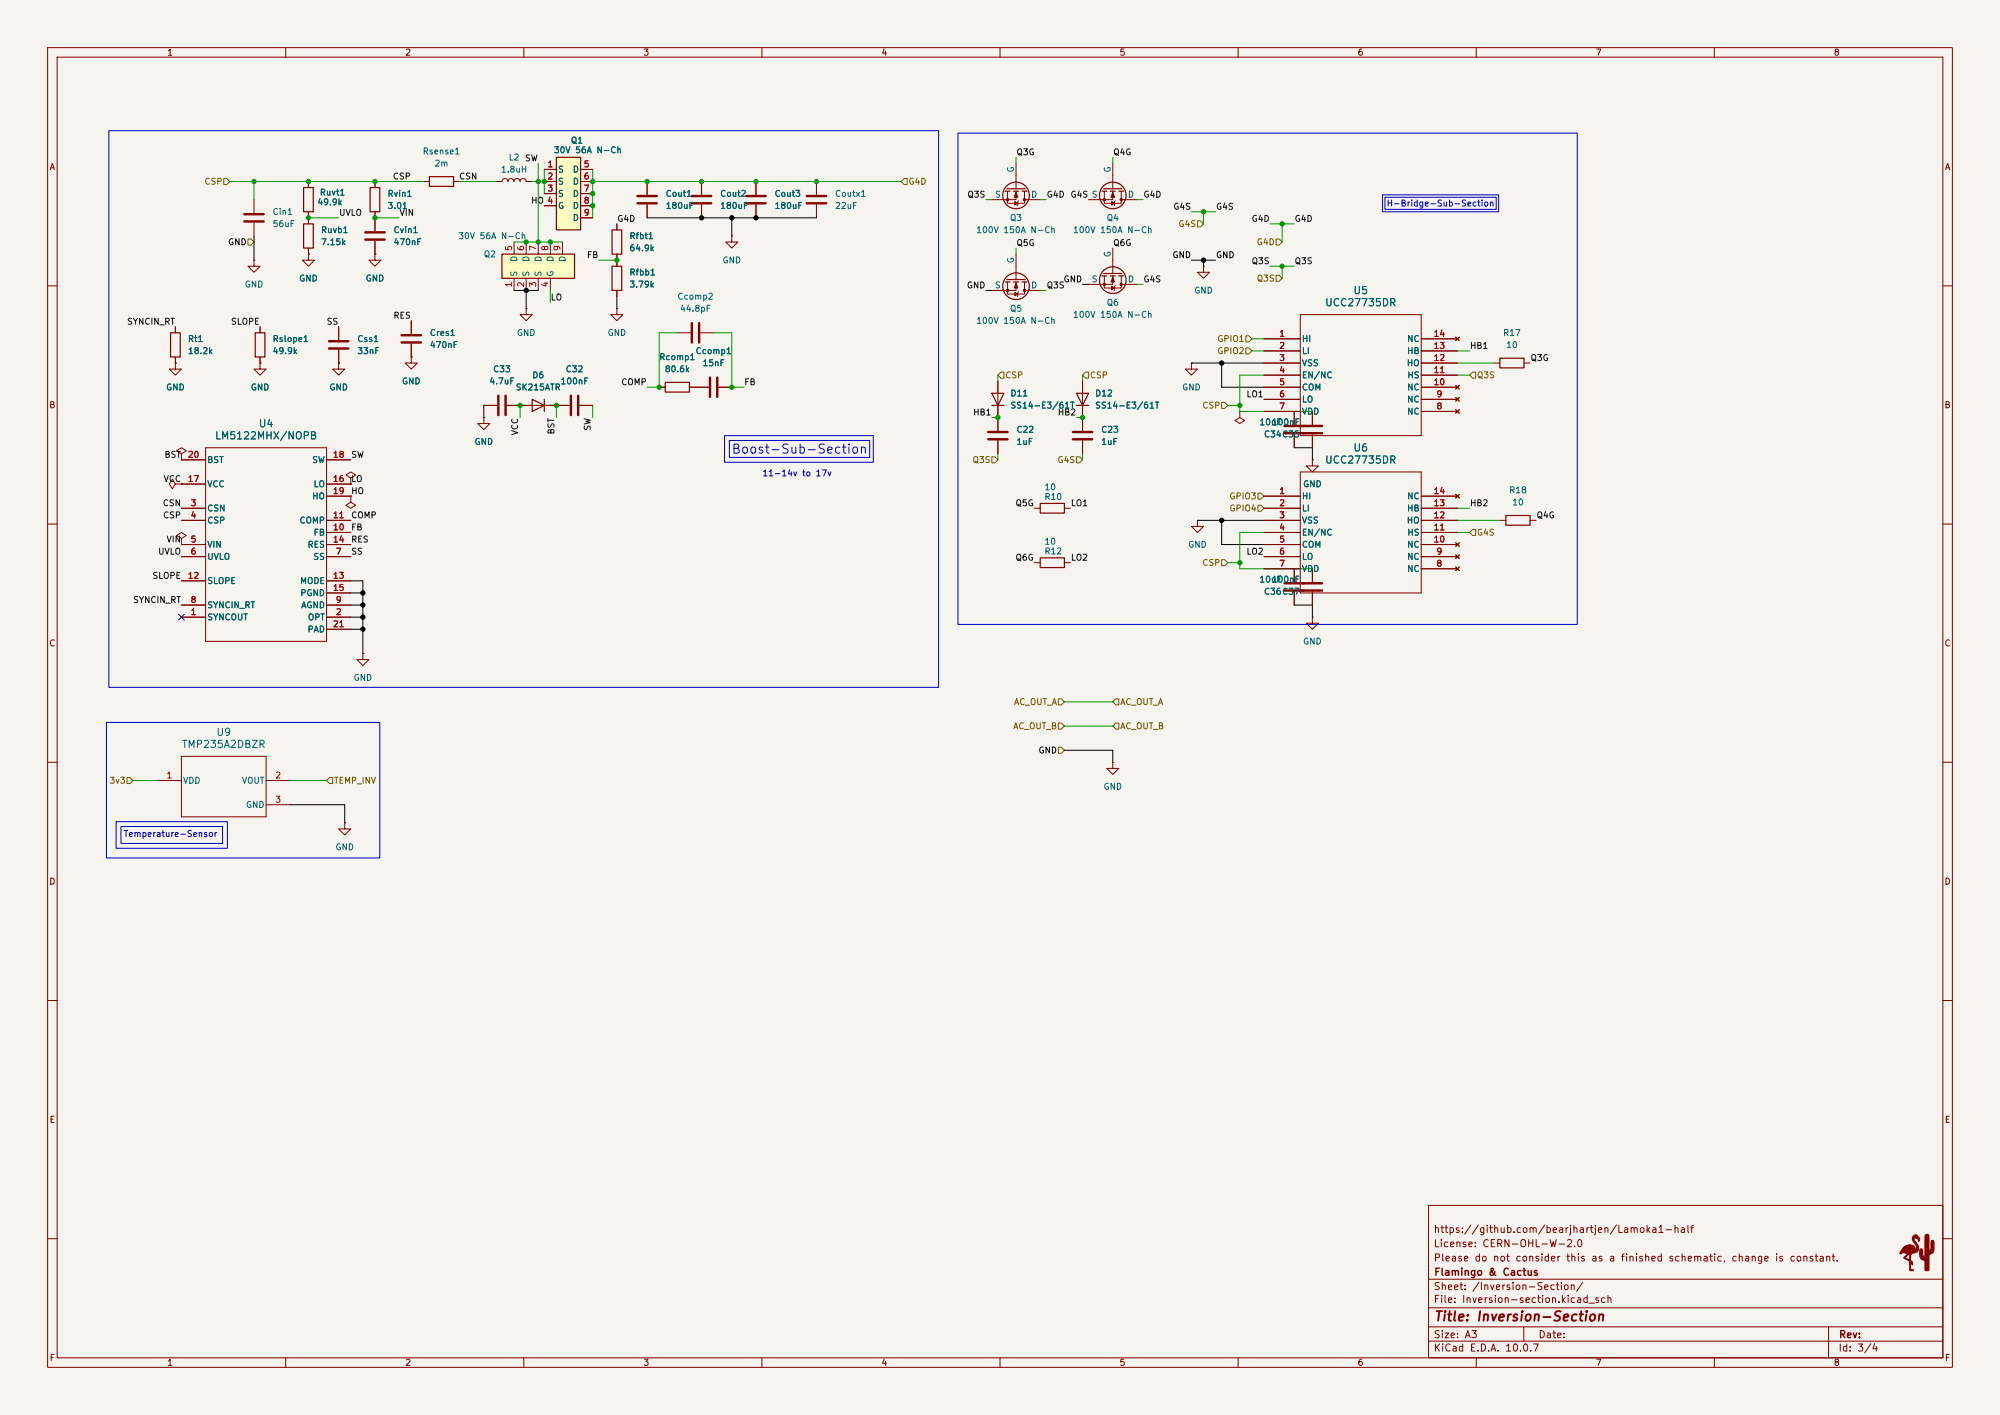
[picture p9: page 3]

https://github.com/bearjhartjen/Lamoka1-half
License: CERN-OHL-W-2.0
Please do not consider this as a finished schematic, change is constant.
Flamingo & Cactus
Sheet: /Inversion-Section/
File: Inversion-section.kicad_sch
Title: Inversion-Section

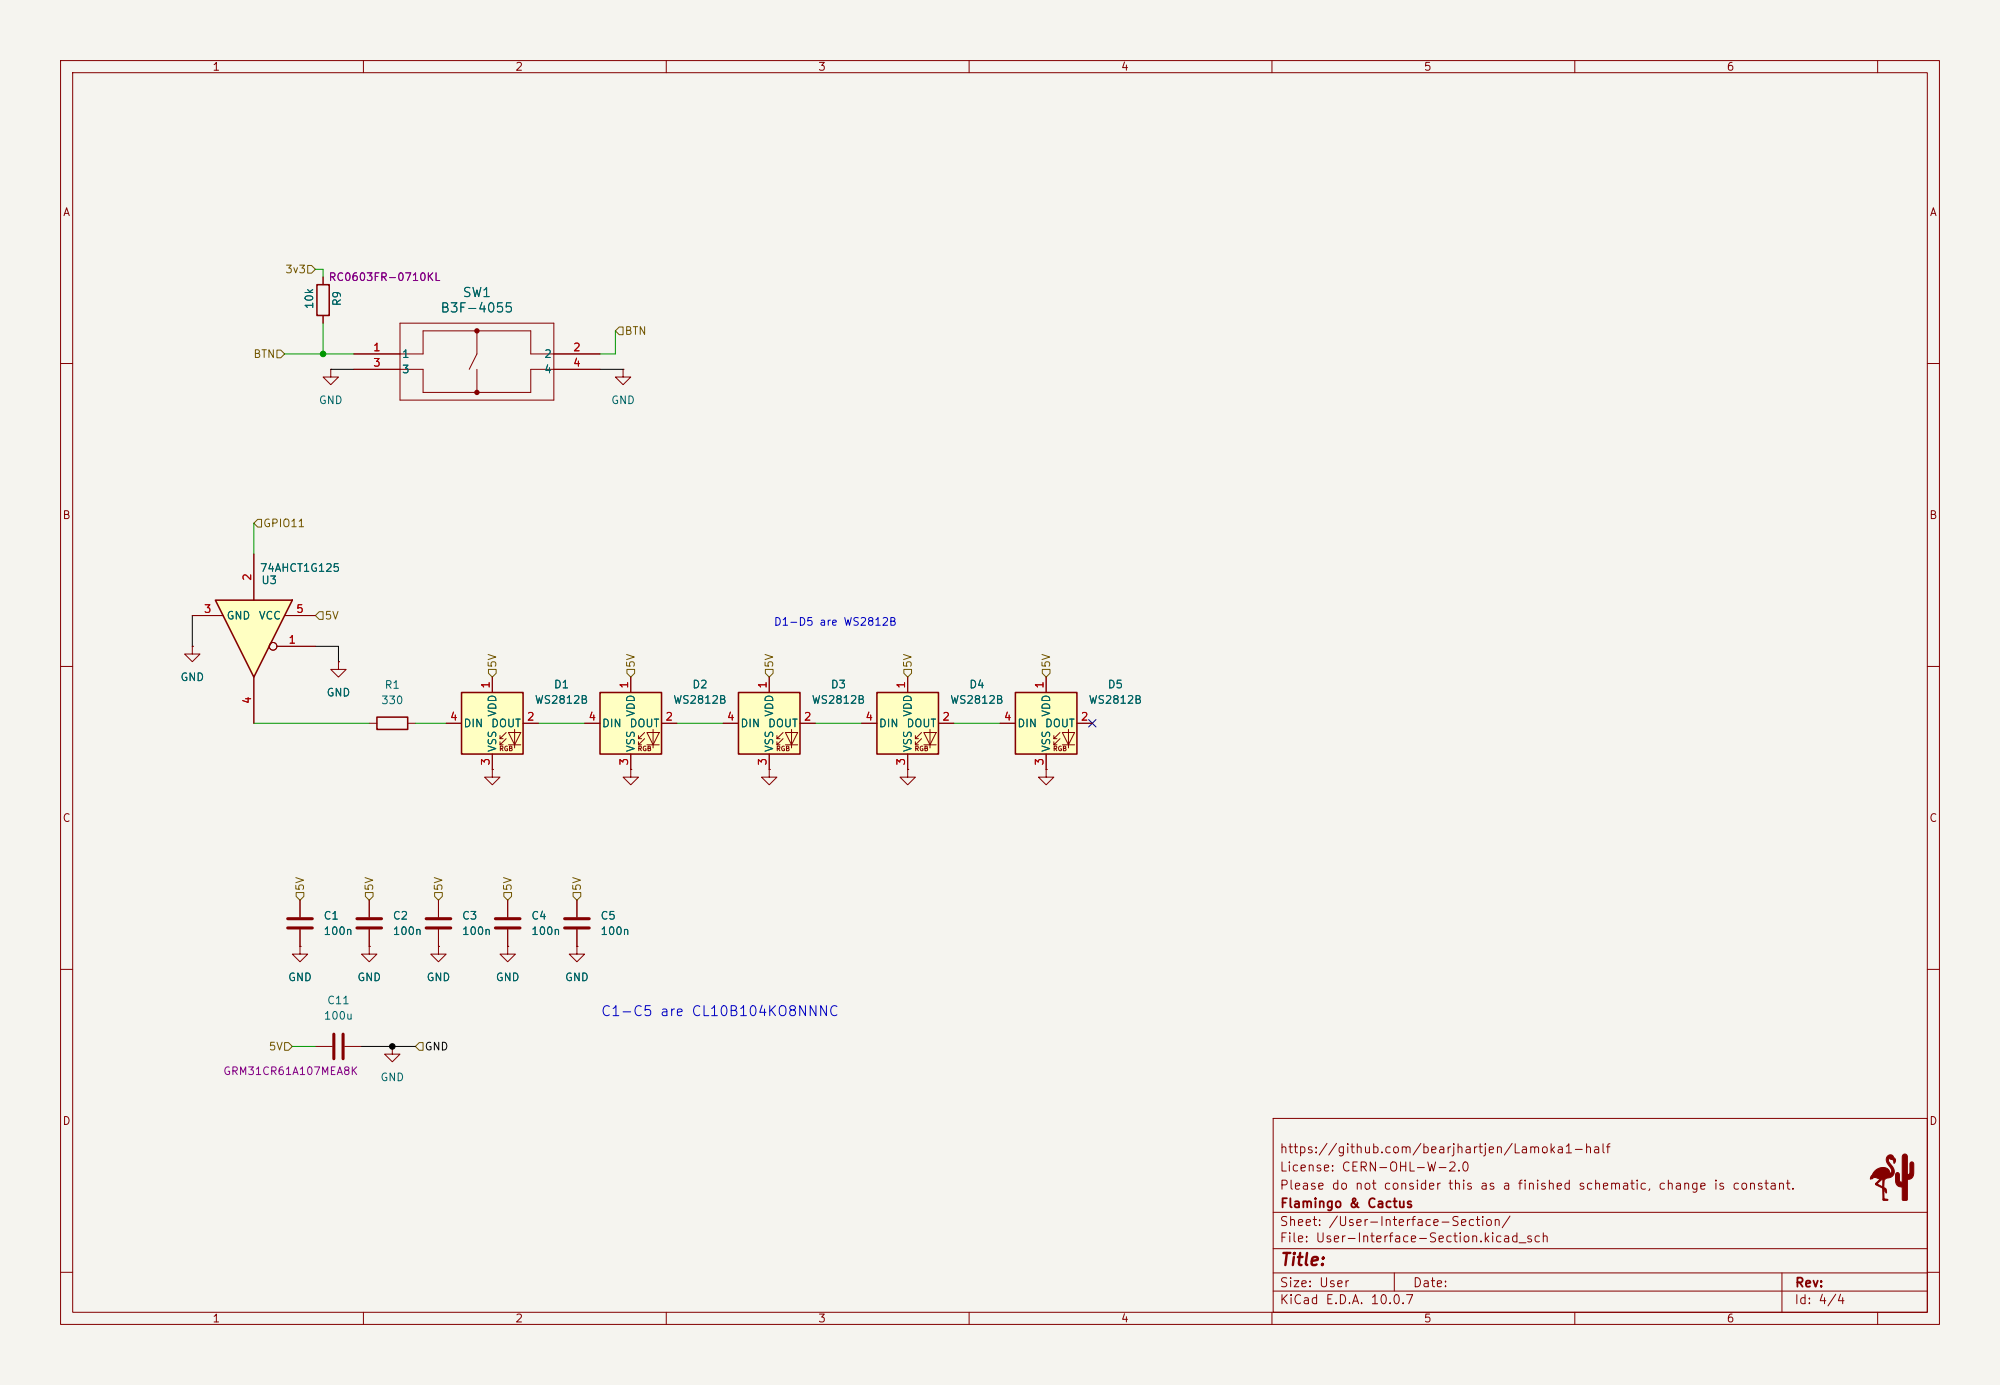
[picture p10: page 4]

License: CERN-OHL-W-2.0
Please do not consider this as a finished schematic, change is constant.
Flamingo & Cactus
Sheet: /User-Interface-Section/
File: User-Interface-Section.kicad_sch
Title:
