bearjhartjen/Lamoka1-half/HARDWARE/Kicadfiles/Lamoka1-half/Lamoka1-half.kicad_pcb

## KiCad design HARDWARE/Kicadfiles/Lamoka1-half/Lamoka1-half.kicad_pcb (2026-11-07)

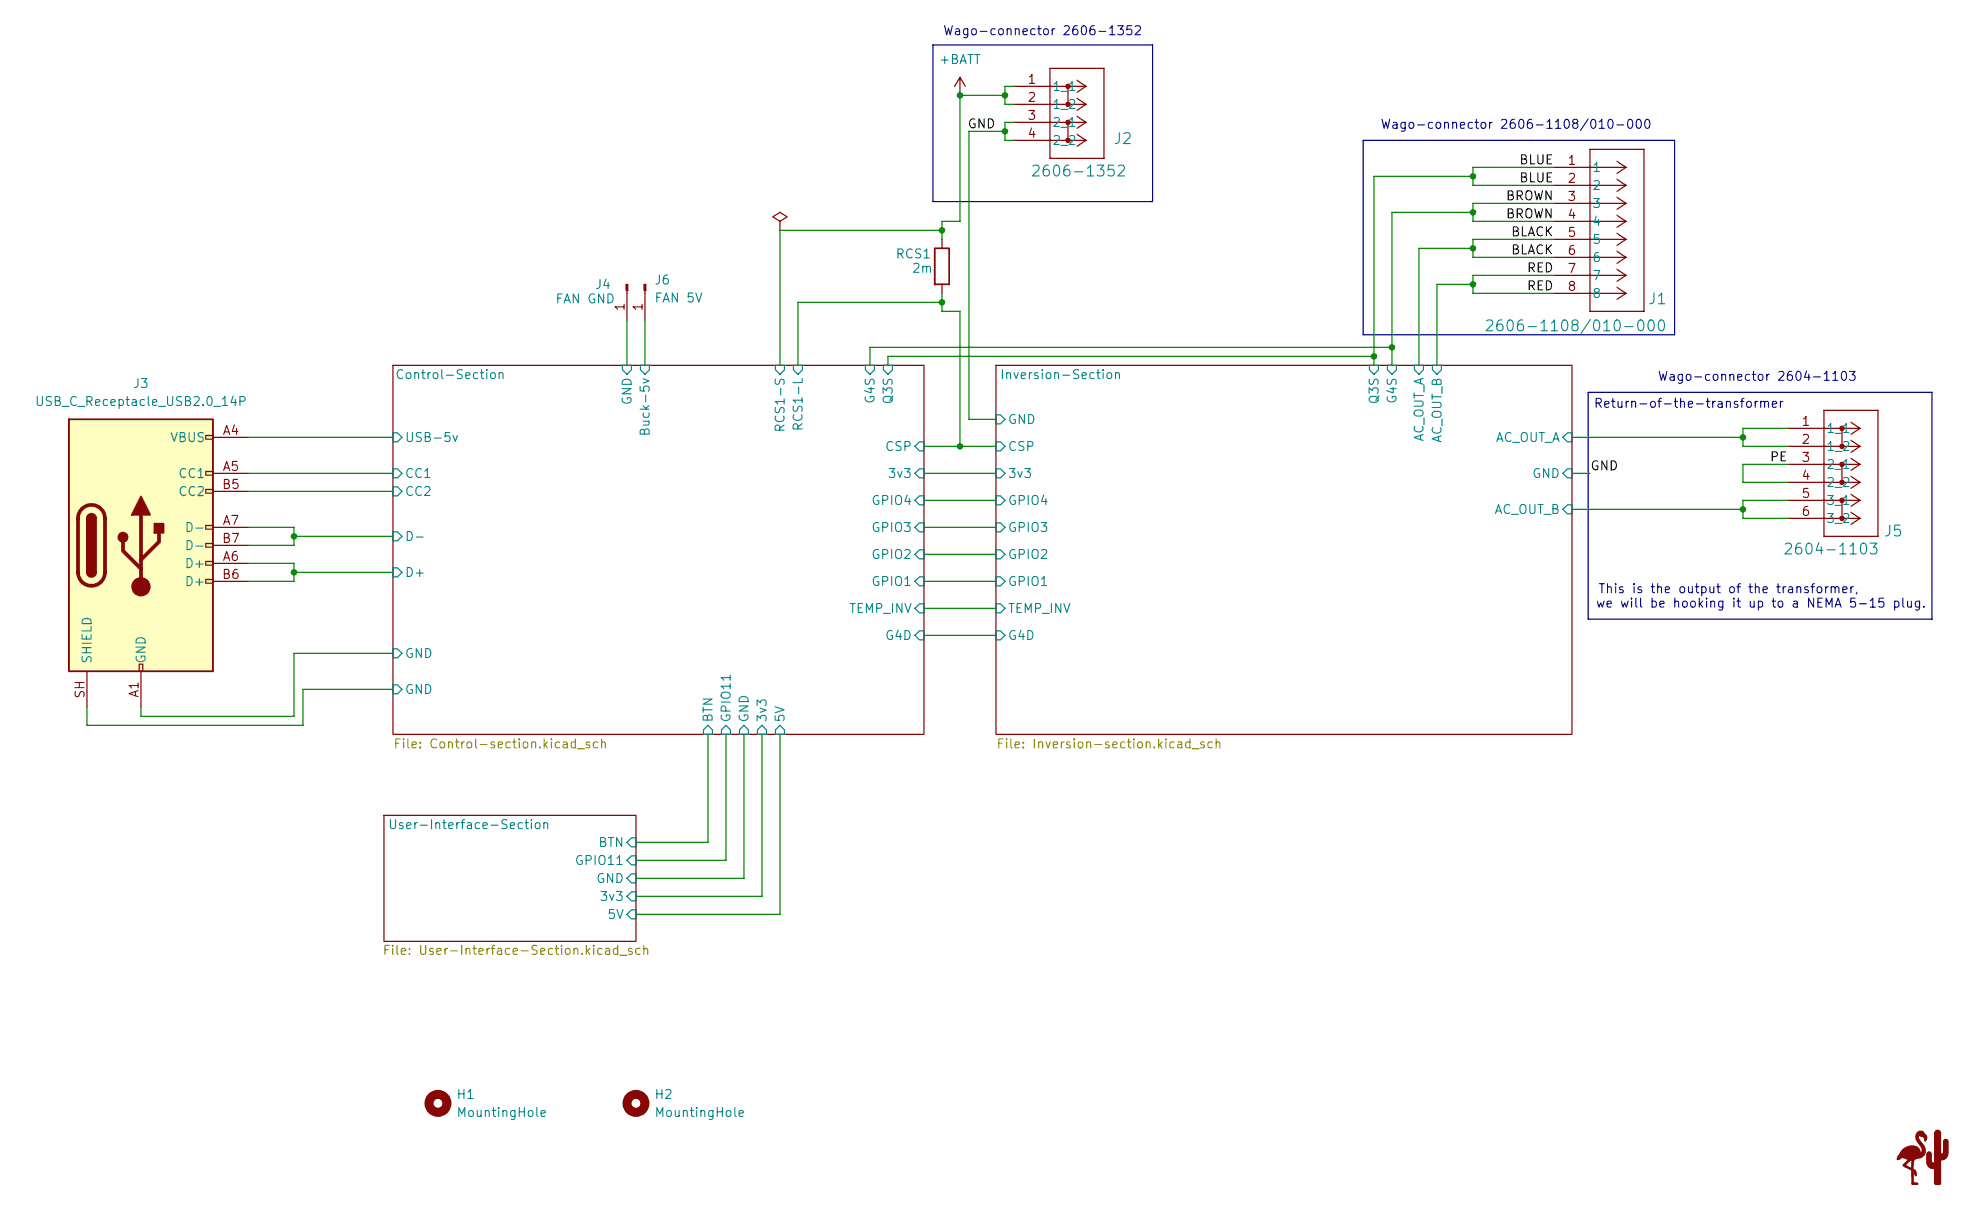
[picture p11: schematic Lamoka1-half.kicad_sch]

Parts:
H1, H2: MountingHole; MountingHole_3.2mm_M3
J1: 2606-1108/010-000; CONN8_2606-1108&slash_010-000_WAG; MPN 2606-1108/010-000
J2: 2606-1352; CONN2_2606-1352_WAG; MPN 2606-1352
J3: USB_C_Receptacle_USB2.0_14P; USB_C_Receptacle_HRO_TYPE-C-31-M-12; MPN TYPE-C-31-M-12
J4: FAN GND; SolderWirePad_1x01_SMD_3x6mm
J5: 2604-1103; CONN3_2604-1103_WAG; MPN 2604-1103
J6: FAN 5V; SolderWirePad_1x01_SMD_3x6mm
RCS1: 2m; R_2512_6332Metric; MPN CSNL2512FT2L00

Connections:
+BATT: J2.1 (1_1), J2.2 (1_2), RCS1.1; also elsewhere on the board
/BLACK: J1.5, J1.6, J5.1 (1_1), J5.2 (1_2)
/BLUE: J1.1, J1.2; also elsewhere on the board
/BROWN: J1.3, J1.4; also elsewhere on the board
/Control-Section/Buck-5v: J6.1 (Pin_1_1); also elsewhere on the board
/Control-Section/CC1: J3.A5 (CC1); also elsewhere on the board
/Control-Section/CC2: J3.B5 (CC2); also elsewhere on the board
/Control-Section/D+: J3.A6 (D+), J3.B6 (D+); also elsewhere on the board
/Control-Section/D-: J3.A7 (D-), J3.B7 (D-); also elsewhere on the board
/Control-Section/USB-5v: J3.A4 (VBUS), J3.A9 (VBUS), J3.B4 (VBUS), J3.B9 (VBUS); also elsewhere on the board
/Inversion-Section/CSP: RCS1.2; also elsewhere on the board
/PE: J5.3 (2_1), J5.4 (2_2)
/RED: J1.7, J1.8, J5.5 (3_1), J5.6 (3_2)
GND: J2.3 (2_1), J2.4 (2_2), J3.A1 (GND), J3.A12 (GND), J3.B1 (GND), J3.B12 (GND), J3.SH (SHIELD), J4.1 (Pin_1_1); also elsewhere on the board

Notes on the sheet:
This is the output of the transformer,
Wago-connector 2606-1108/010-000
Wago-connector 2604-1103
Return-of-the-transformer
Wago-connector 2606-1352
we will be hooking it up to a NEMA 5-15 plug.

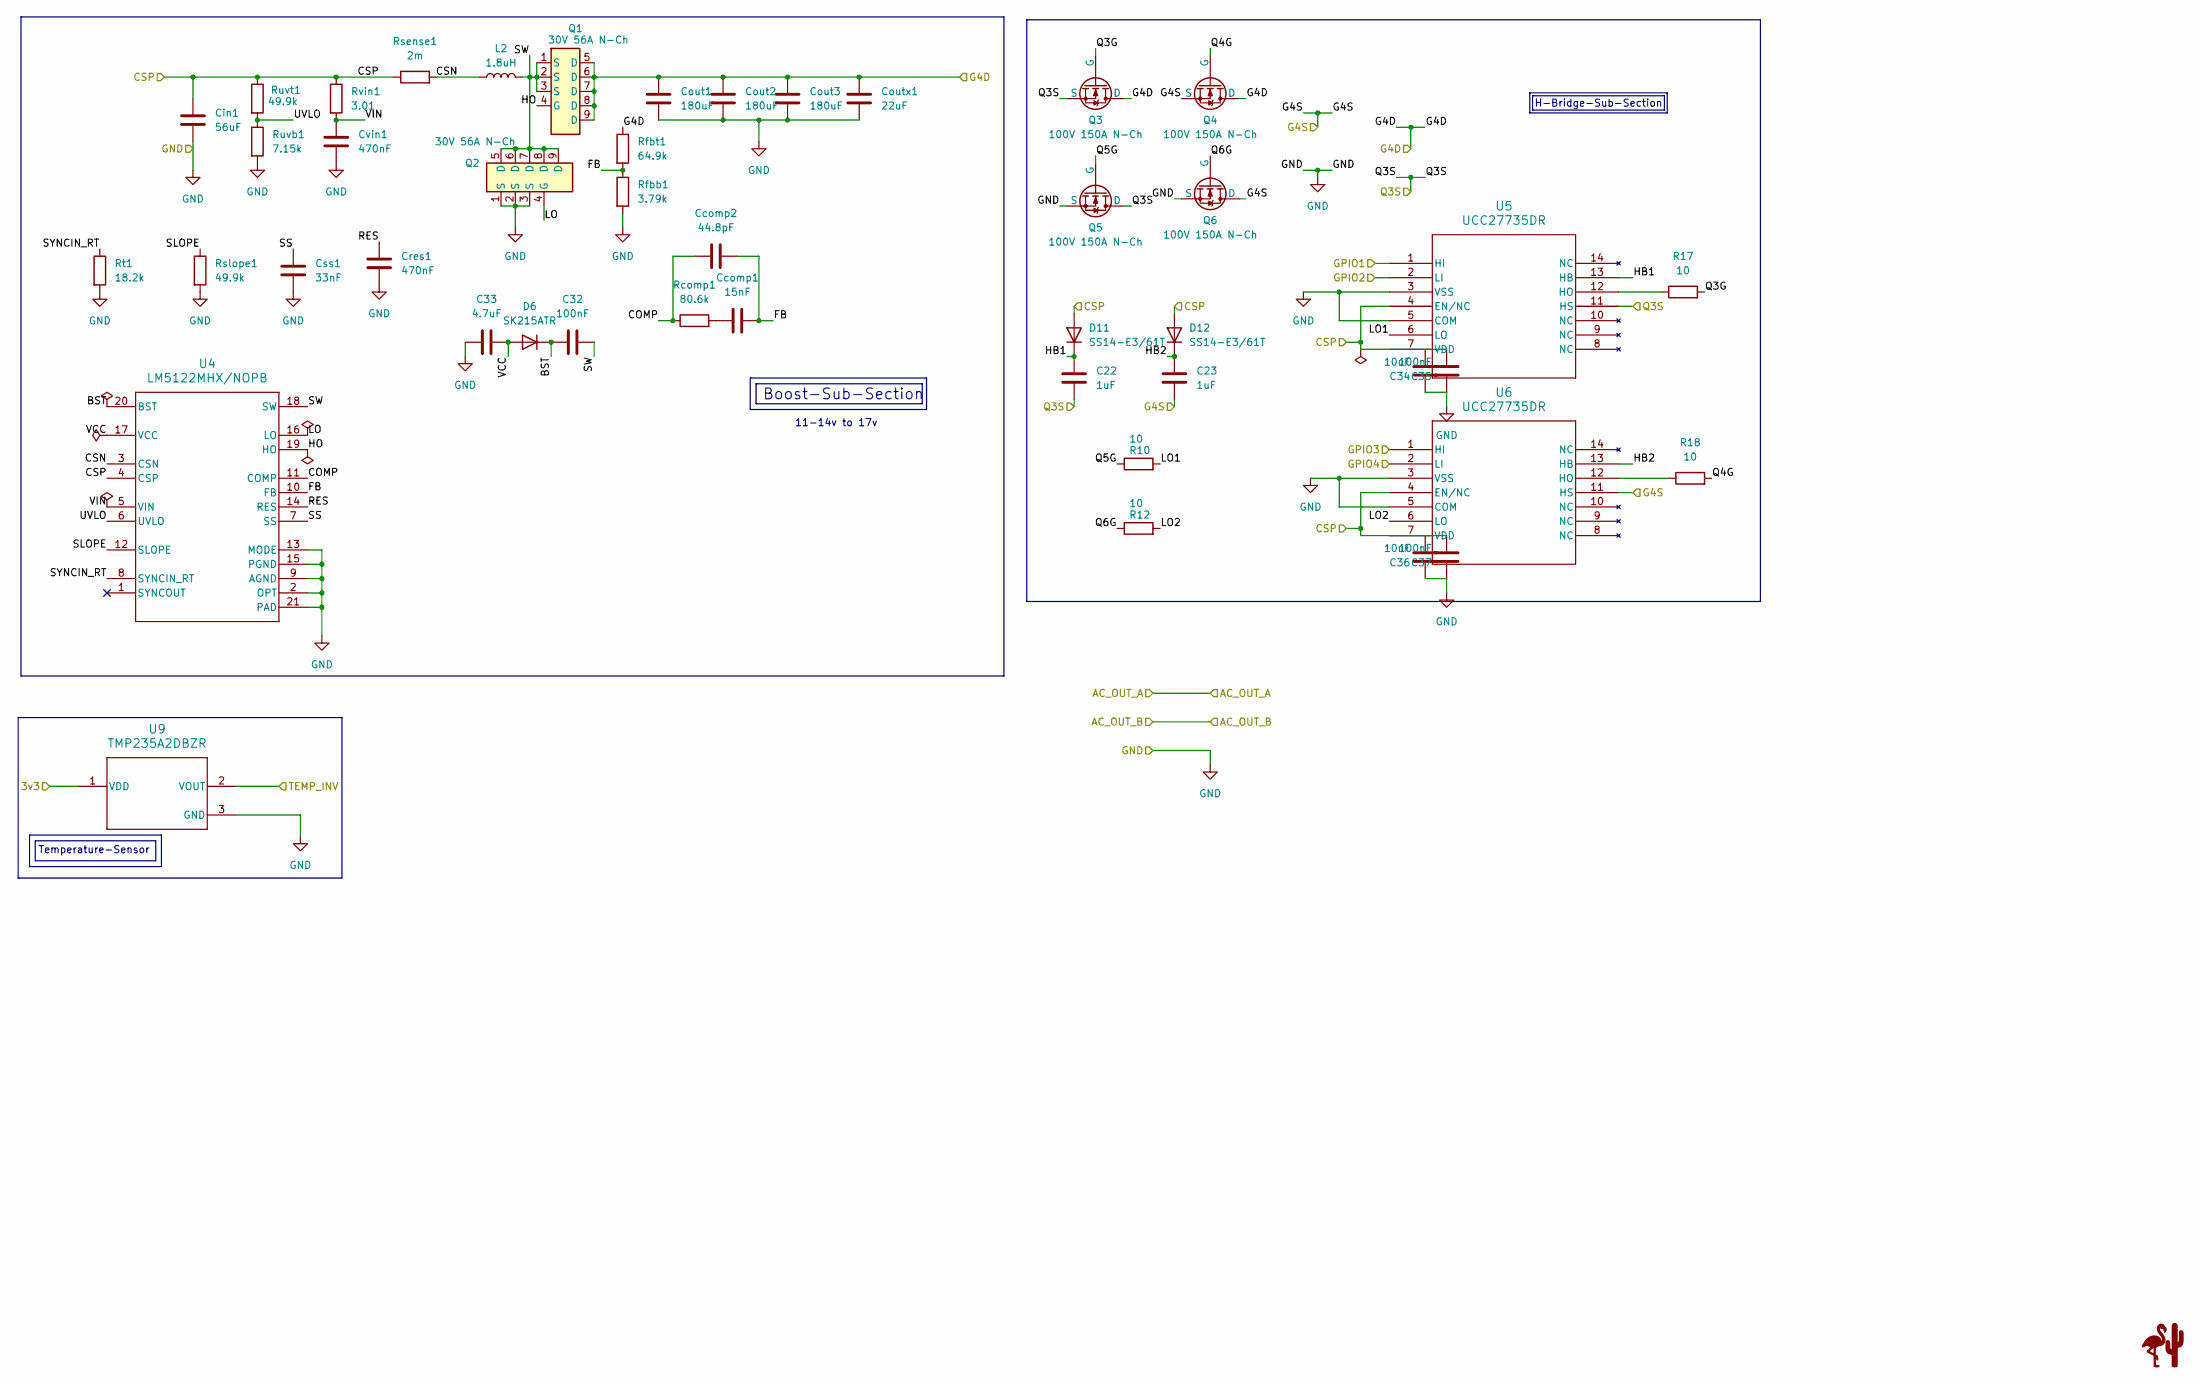
[picture p12: schematic Inversion-section.kicad_sch, Inversion-Section]

Parts:
C22, C23: 1uF; C_0805_2012Metric; MPN GRM21BR71H105KA12L
C32: 100nF; C_0805_2012Metric; MPN 08053C104KAT2A
C33: 4.7uF; C_0805_2012Metric; MPN MSAST21GAB5475MTNAO1
C34, C36: 10uF; C_0805_2012Metric; MPN GRM21BZ71E106KE15L
C35, C37: 100nF; C_0603_1608Metric; MPN CL10B104KB8NNNC
Ccomp1: 15nF; C_0805_2012Metric; MPN CGA4F1C0G2A153J085AE
Ccomp2: 44.8pF; C_0402_1005Metric; MPN GRM1555C1H448JA01D
Cin1: 56uF; CP_Elec_5x5.9; MPN 20SVPF56MX
Cout1: 180uF; CP_Elec_8x11.9_Cout1; MPN 35SVPK180M
Cout2: 180uF; CP_Elec_8x11.9_Cout2; MPN 35SVPK180M
Cout3: 180uF; CP_Elec_8x11.9_Cout3; MPN 35SVPK180M
Coutx1: 22uF; C_1206_3216Metric; MPN C3216X5R1V226M160AC
Cres1: 470nF; C_0805_2012Metric; MPN TMK212BJ474KD-T
Css1: 33nF; C_0402_1005Metric; MPN GRM155R71A333KA01D
Cvin1: 470nF; C_0402_1005Metric; MPN C1005X5R1V474K050BC
D6: SK215ATR; D_SMA; MPN SK215ATR
D11, D12: SS14-E3/61T; D_SMA; MPN SS14-E3/61T
L2: 1.8uH; L_Coilcraft_XAL1580-182; MPN XAL1580-182MEB
Q1, Q2: 30V 56A N-Ch; DQG0008A; MPN CSD17304Q3
Q3, Q4, Q5, Q6: 100V 150A N-Ch; TO-220-3_Vertical; MPN CSD19536KCS
R10, R12, R17, R18: 10; R_1206_3216Metric; MPN RC1206FR-0710RL
Rcomp1: 80.6k; R_0201_0603Metric; MPN RC0201FR-0780K6L
Rfbb1: 3.79k; R_0402_1005Metric; MPN CRCW04023K79FKED
Rfbt1: 64.9k; R_0402_1005Metric; MPN CRCW040264K9FKED
Rsense1: 2m; R_2512_6332Metric; MPN CSNL2512FT2L00
Rslope1: 49.9k; R_0201_0603Metric; MPN RC0201FR-0749K9L
Rt1: 18.2k; R_0402_1005Metric; MPN CRCW040218K2FKED
Ruvb1: 7.15k; R_0402_1005Metric; MPN CRCW04027K15FKED
Ruvt1: 49.9k; R_0402_1005Metric; MPN CRCW040249K9FKED
Rvin1: 3.01; R_0402_1005Metric; MPN CRCW04023R01FKED
U4: LM5122MHX/NOPB; PWP0020A_N; MPN LM5122MHX/NOPB
U5, U6: UCC27735DR; SOIC_14L_TEX; MPN UCC27735DR
U9: TMP235A2DBZR; DBZ0003A-IPC_A; MPN TMP235A2DBZR

Connections:
/BLUE: C22.2, Q3.3 (S), Q5.2 (D), U5.11 (HS); also elsewhere on the board
/BROWN: C23.2, Q4.3 (S), Q6.2 (D), U6.11 (HS); also elsewhere on the board
/Control-Section/3v3: U9.1 (VDD); also elsewhere on the board
/Control-Section/GPIO1: U5.1 (HI); also elsewhere on the board
/Control-Section/GPIO2: U5.2 (LI); also elsewhere on the board
/Control-Section/GPIO3: U6.1 (HI); also elsewhere on the board
/Control-Section/GPIO4: U6.2 (LI); also elsewhere on the board
/Control-Section/TEMP_INV: U9.2 (VOUT); also elsewhere on the board
/Inversion-Section/BST: C32.1, D6.1 (K), U4.20 (BST)
/Inversion-Section/COMP: Ccomp2.1, Rcomp1.1, U4.11 (COMP)
/Inversion-Section/CSN: L2.1, Rsense1.2, U4.3 (CSN)
/Inversion-Section/CSP: C34.2, C35.2, C36.2, C37.2, Cin1.1, D11.2 (A), D12.2 (A), Rsense1.1, Ruvt1.1, Rvin1.1, U4.4 (CSP), U5.4 (EN/NC), U5.7 (VDD), U6.4 (EN/NC), U6.7 (VDD); also elsewhere on the board
/Inversion-Section/FB: Ccomp1.2, Ccomp2.2, Rfbb1.1, Rfbt1.2, U4.10 (FB)
/Inversion-Section/G4D: Cout1.1, Cout2.1, Cout3.1, Coutx1.1, Q1.5 (D), Q1.6 (D), Q1.7 (D), Q1.8 (D), Q1.9 (D), Q3.2 (D), Q4.2 (D), Rfbt1.1; also elsewhere on the board
/Inversion-Section/HB1: C22.1, D11.1 (K), U5.13 (HB)
/Inversion-Section/HB2: C23.1, D12.1 (K), U6.13 (HB)
/Inversion-Section/HO: Q1.4 (G), U4.19 (HO)
/Inversion-Section/LO: Q2.4 (G), U4.16 (LO)
/Inversion-Section/LO1: R10.2, U5.6 (LO)
/Inversion-Section/LO2: R12.2, U6.6 (LO)
/Inversion-Section/Q3G: Q3.1 (G), R17.2
/Inversion-Section/Q4G: Q4.1 (G), R18.2
/Inversion-Section/Q5G: Q5.1 (G), R10.1
/Inversion-Section/Q6G: Q6.1 (G), R12.1
/Inversion-Section/RES: Cres1.1, U4.14 (RES)
/Inversion-Section/SLOPE: Rslope1.1, U4.12 (SLOPE)
/Inversion-Section/SS: Css1.1, U4.7 (SS)
/Inversion-Section/SW: C32.2, L2.2, Q1.1 (S), Q1.2 (S), Q1.3 (S), Q2.5 (D), Q2.6 (D), Q2.7 (D), Q2.8 (D), Q2.9 (D), U4.18 (SW)
/Inversion-Section/SYNCIN_RT: Rt1.1, U4.8 (SYNCIN_RT)
/Inversion-Section/UVLO: Ruvb1.1, Ruvt1.2, U4.6 (UVLO)
/Inversion-Section/VCC: C33.2, D6.2 (A), U4.17 (VCC)
/Inversion-Section/VIN: Cvin1.1, Rvin1.2, U4.5 (VIN)
GND: C33.1, C34.1, C35.1, C36.1, C37.1, Cin1.2, Cout1.2, Cout2.2, Cout3.2, Coutx1.2, Cres1.2, Css1.2, Cvin1.2, Q2.1 (S), Q2.2 (S), Q2.3 (S), Q5.3 (S), Q6.3 (S), Rfbb1.2, Rslope1.2, Rt1.2, Ruvb1.2, U4.2 (OPT), U4.9 (AGND), U4.13 (MODE), U4.15 (PGND), U4.21 (PAD), U4.V, U5.3 (VSS), U5.5 (COM), U6.3 (VSS), U6.5 (COM), U9.3 (GND); also elsewhere on the board
unnamed: Ccomp1.1, Rcomp1.2
unnamed: R17.1, U5.12 (HO)
unnamed: R18.1, U6.12 (HO)

Notes on the sheet:
11-14v to 17v
H-Bridge-Sub-Section
Boost-Sub-Section
Temperature-Sensor

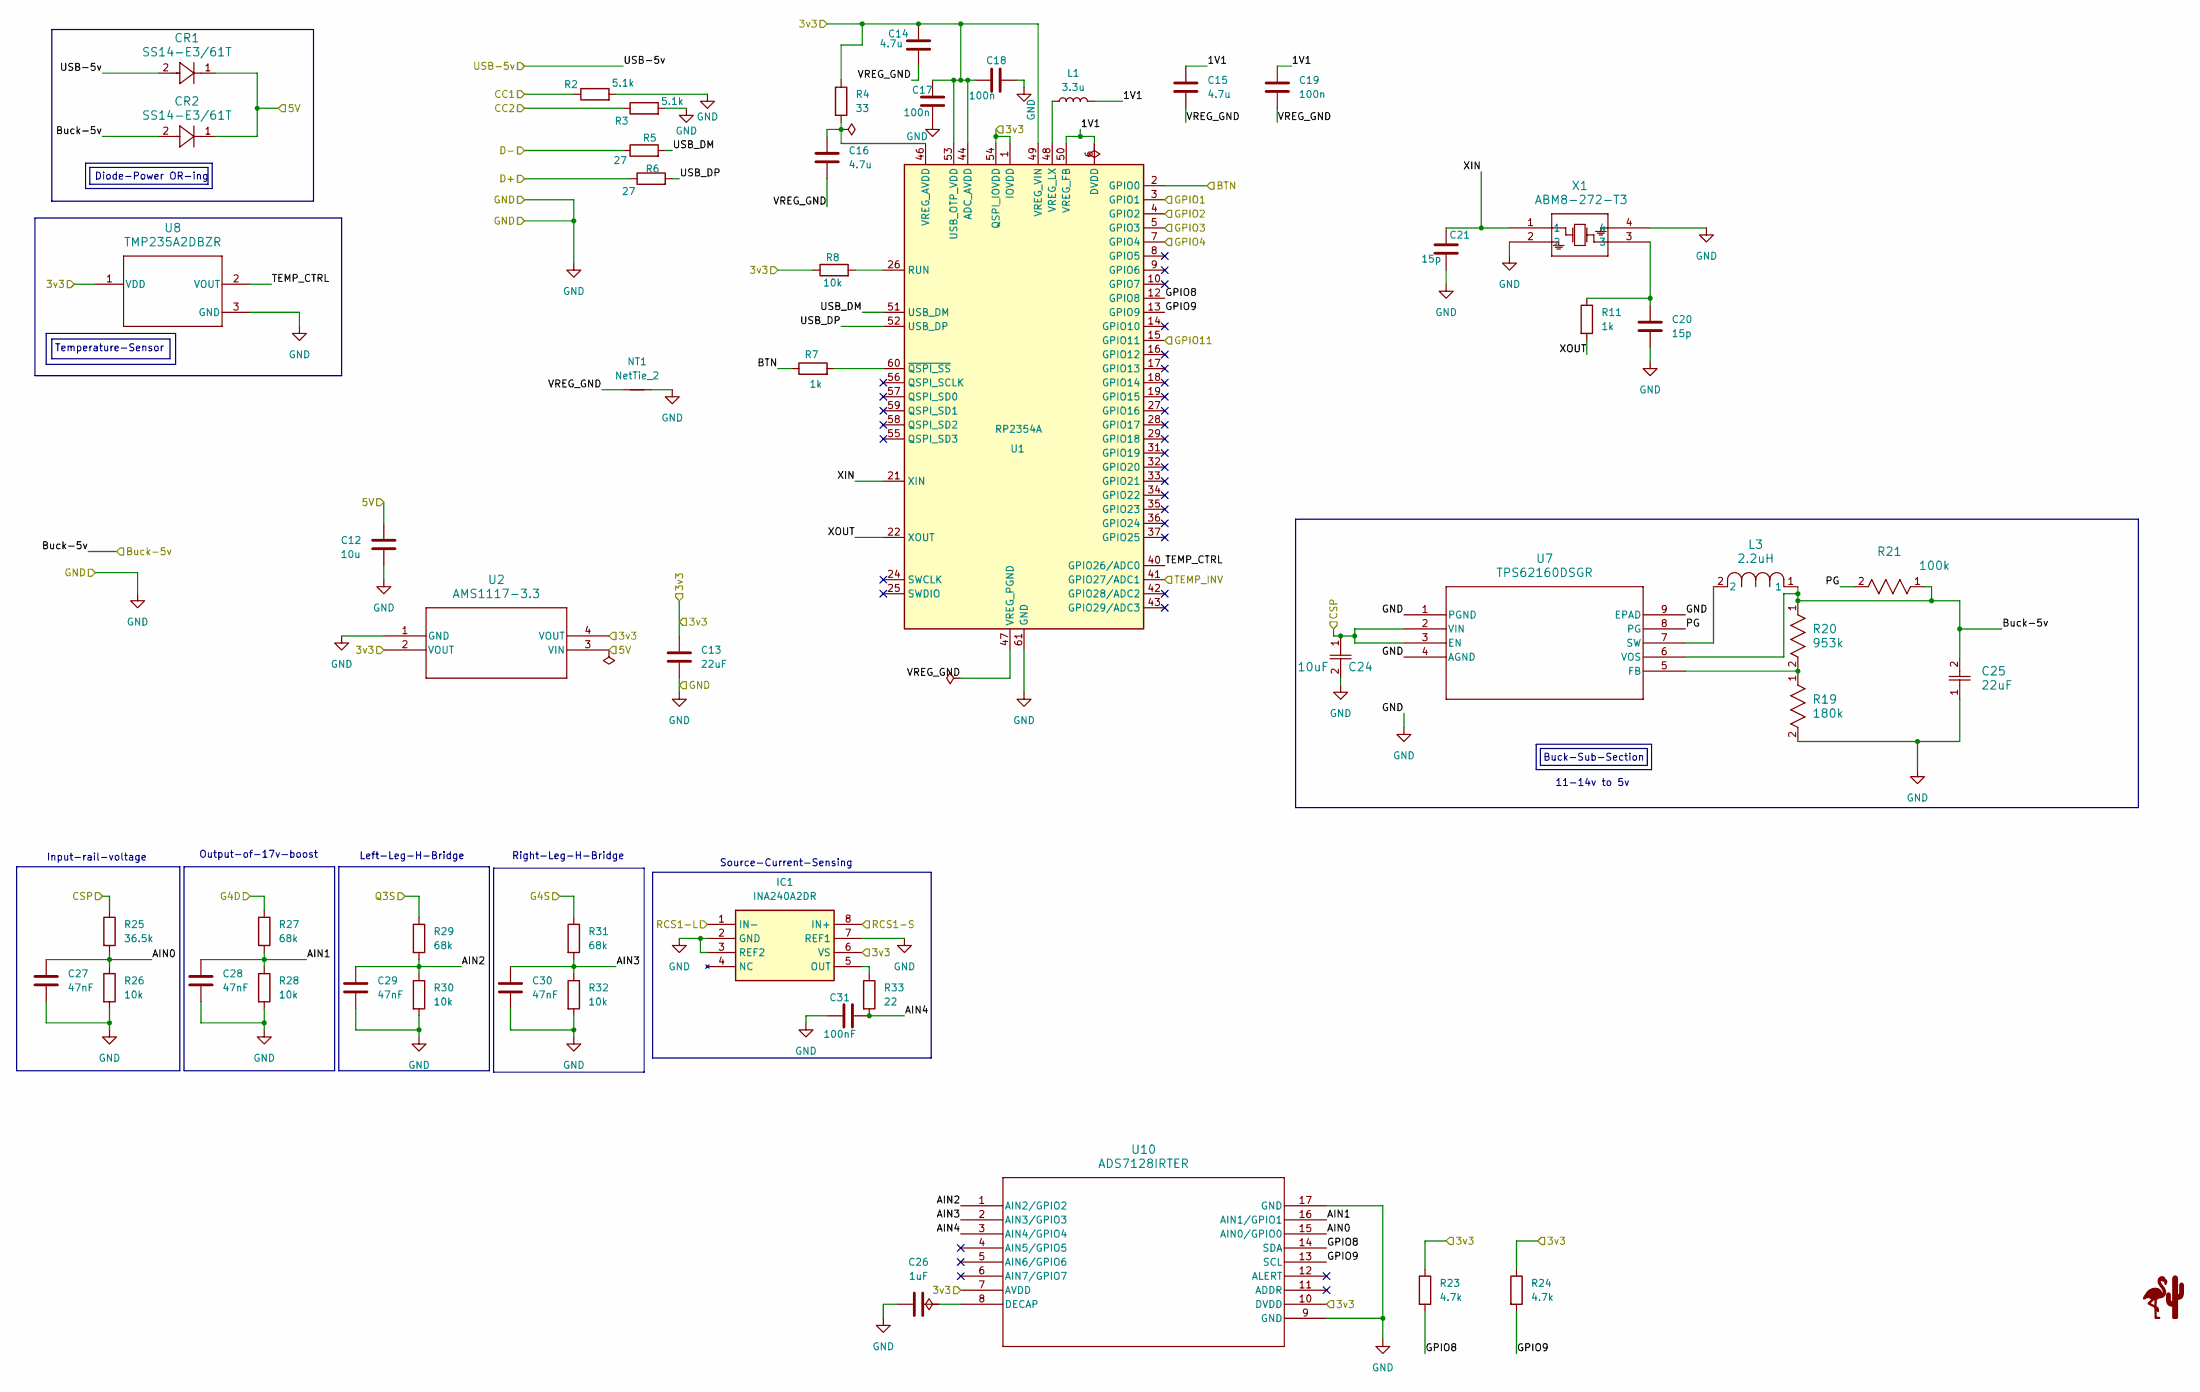
[picture p13: schematic Control-section.kicad_sch]

Parts:
C12: 10u; C_0402_1005Metric; MPN CL05A106MQ5NUNC
C13: 22uF; CP_EIA-3216-18_Kemet-A; MPN T491A226K010AT
C14, C15, C16: 4.7u; C_0603_1608Metric; MPN CL10A475KP8NNNC
C17, C18, C19: 100n; C_0402_1005Metric; MPN CL05B104KO5NNNC
C20, C21: 15p; C_0402_1005Metric; MPN 0402CG150J500NT
C24: 10uF; CAPC2114X145N; MPN TMK212BBJ106KG-T
C25: 22uF; G-31_MUR; MPN GRM31CR71A226KE15L
C26: 1uF; C_0603_1608Metric; MPN CL10A105KA8NNNC
C27, C28, C29, C30: 47nF; C_0603_1608Metric; MPN CL10B473KB8NNNC
C31: 100nF; C_0603_1608Metric; MPN CL10B104KB8NNNC
CR1, CR2: SS14-E3/61T; DO-214AC_VIS; MPN SS14-E3/61T
IC1: INA240A2DR; SOIC127P600X175-8N; MPN INA240A2DR; Mouser Part Number 595-INA240A2DR
L1: 3.3u; AOTAB201610S3R3101T; MPN AOTA-B201610S3R3-101-T
L3: 2.2uH; IND_PA4332.222NLT_PUL; MPN PA4332.222NLT
NT1: NetTie_2; NetTie-2_SMD_Pad0.5mm
R2, R3: 5.1k; RC0603N_YAG; MPN RC0603FR-075K1L
R4: 33; R_0603_1608Metric; MPN RC0603FR-0733RL
R5, R6: 27; R_0603_1608Metric; MPN RC0603FR-0727RL
R7, R11: 1k; R_0402_1005Metric; MPN RC0402FR-071KL
R8, R26, R28, R30, R32: 10k; R_0603_1608Metric; MPN RC0603FR-0710KL
R19: 180k; RC0603N_YAG; MPN RC0603FR-07180KL
R20: 953k; RC0402N_VIS; MPN CRCW0402953KFKED
R21: 100k; RES_CRCW_0402_VIS; MPN CRCW0402100KFKED
R23, R24: 4.7k; R_0603_1608Metric; MPN RC0603FR-074K7L
R25: 36.5k; R_0603_1608Metric; MPN RC0603FR-0736K5L
R27, R29, R31: 68k; R_0603_1608Metric; MPN RC0603FR-0768KL
R33: 22; R_0603_1608Metric; MPN RC0603FR-0722RL
U1: RP2354A; QFN-60-1EP_7x7mm_P0.4mm_EP3.4x3.4mm; MPN RP2354A
U2: AMS1117-3.3; SOT-223-3_TabPin2; MPN AMS1117-3.3
U7: TPS62160DSGR; DSG8_1P6X0P9; MPN TPS62160DSGR
U8: TMP235A2DBZR; DBZ0003A-IPC_A; MPN TMP235A2DBZR
U10: ADS7128IRTER; WQFN16_RTE_TEX; MPN ADS7128IRTER
X1: ABM8-272-T3; ABM8272T3; MPN ABM8-272-T3

Connections:
+BATT: IC1.8 (IN+); also elsewhere on the board
/BLUE: R29.1; also elsewhere on the board
/BROWN: R31.1; also elsewhere on the board
/Control-Section/1V1: C15.1, C19.1, L1.2, U1.6 (DVDD), U1.23 (DVDD), U1.39 (DVDD), U1.50 (VREG_FB)
/Control-Section/3v3: C13.1, C14.1, C17.1, C18.1, IC1.6 (VS), R4.1, R8.1, R23.1, R24.1, U1.1 (IOVDD), U1.11 (IOVDD), U1.20 (IOVDD), U1.30 (IOVDD), U1.38 (IOVDD), U1.44 (ADC_AVDD), U1.45 (IOVDD), U1.49 (VREG_VIN), U1.53 (USB_OTP_VDD), U1.54 (QSPI_IOVDD), U2.2 (VOUT), U2.4 (VOUT), U8.1 (VDD), U10.7 (AVDD), U10.10 (DVDD); also elsewhere on the board
/Control-Section/5V: C12.2, CR1.1, CR2.1, U2.3 (VIN); also elsewhere on the board
/Control-Section/AIN0: C27.1, R25.2, R26.1, U10.15 (AIN0/GPIO0)
/Control-Section/AIN1: C28.1, R27.2, R28.1, U10.16 (AIN1/GPIO1)
/Control-Section/AIN2: C29.1, R29.2, R30.1, U10.1 (AIN2/GPIO2)
/Control-Section/AIN3: C30.1, R31.2, R32.1, U10.2 (AIN3/GPIO3)
/Control-Section/AIN4: C31.1, R33.2, U10.3 (AIN4/GPIO4)
/Control-Section/BTN: R7.1, U1.2 (GPIO0); also elsewhere on the board
/Control-Section/Buck-5v: C25.2, CR2.2, L3.1, R20.1, R21.1, U7.6 (VOS); also elsewhere on the board
/Control-Section/CC1: R2.1; also elsewhere on the board
/Control-Section/CC2: R3.1; also elsewhere on the board
/Control-Section/D+: R6.1; also elsewhere on the board
/Control-Section/D-: R5.1; also elsewhere on the board
/Control-Section/GPIO1: U1.3 (GPIO1); also elsewhere on the board
/Control-Section/GPIO2: U1.4 (GPIO2); also elsewhere on the board
/Control-Section/GPIO3: U1.5 (GPIO3); also elsewhere on the board
/Control-Section/GPIO4: U1.7 (GPIO4); also elsewhere on the board
/Control-Section/GPIO8: R23.2, U1.12 (GPIO8), U10.14 (SDA)
/Control-Section/GPIO9: R24.2, U1.13 (GPIO9), U10.13 (SCL)
/Control-Section/GPIO11: U1.15 (GPIO11); also elsewhere on the board
/Control-Section/PG: R21.2, U7.8 (PG)
/Control-Section/TEMP_CTRL: U1.40 (GPIO26/ADC0), U8.2 (VOUT)
/Control-Section/TEMP_INV: U1.41 (GPIO27/ADC1); also elsewhere on the board
/Control-Section/USB-5v: CR1.2; also elsewhere on the board
/Control-Section/USB_DM: R5.2, U1.51 (USB_DM)
/Control-Section/USB_DP: R6.2, U1.52 (USB_DP)
/Control-Section/VREG_GND: C14.2, C15.2, C16.2, C19.2, NT1.1, U1.47 (VREG_PGND)
/Control-Section/XIN: C21.1, U1.21 (XIN), X1.1
/Control-Section/XOUT: R11.2, U1.22 (XOUT)
/Inversion-Section/CSP: C24.1, IC1.1 (IN-), R25.1, U7.2 (VIN), U7.3 (EN); also elsewhere on the board
/Inversion-Section/G4D: R27.1; also elsewhere on the board
GND: C12.1, C13.2, C17.2, C18.2, C20.2, C21.2, C24.2, C25.1, C26.2, C27.2, C28.2, C29.2, C30.2, C31.2, IC1.2 (GND), IC1.3 (REF2), IC1.7 (REF1), NT1.2, R2.2, R3.2, R19.2, R26.2, R28.2, R30.2, R32.2, U1.61 (GND), U2.1 (GND), U7.1 (PGND), U7.4 (AGND), U7.9 (EPAD), U8.3 (GND), U10.9 (GND), U10.17 (GND), X1.2, X1.4; also elsewhere on the board
unnamed: C20.1, R11.1, X1.3
unnamed: IC1.5 (OUT), R33.1
unnamed: R8.2, U1.26 (RUN)
unnamed: C16.1, R4.2, U1.46 (VREG_AVDD)
unnamed: L1.1, U1.48 (VREG_LX)
unnamed: R7.2, U1.60 (~QSPI_SS)
unnamed: R19.1, R20.2, U7.5 (FB)
unnamed: L3.2, U7.7 (SW)
unnamed: C26.1, U10.8 (DECAP)

Notes on the sheet:
Left-Leg-H-Bridge
Source-Current-Sensing
Input-rail-voltage
11-14v to 5v
Right-Leg-H-Bridge
Output-of-17v-boost
Temperature-Sensor
Diode-Power OR-ing
Buck-Sub-Section

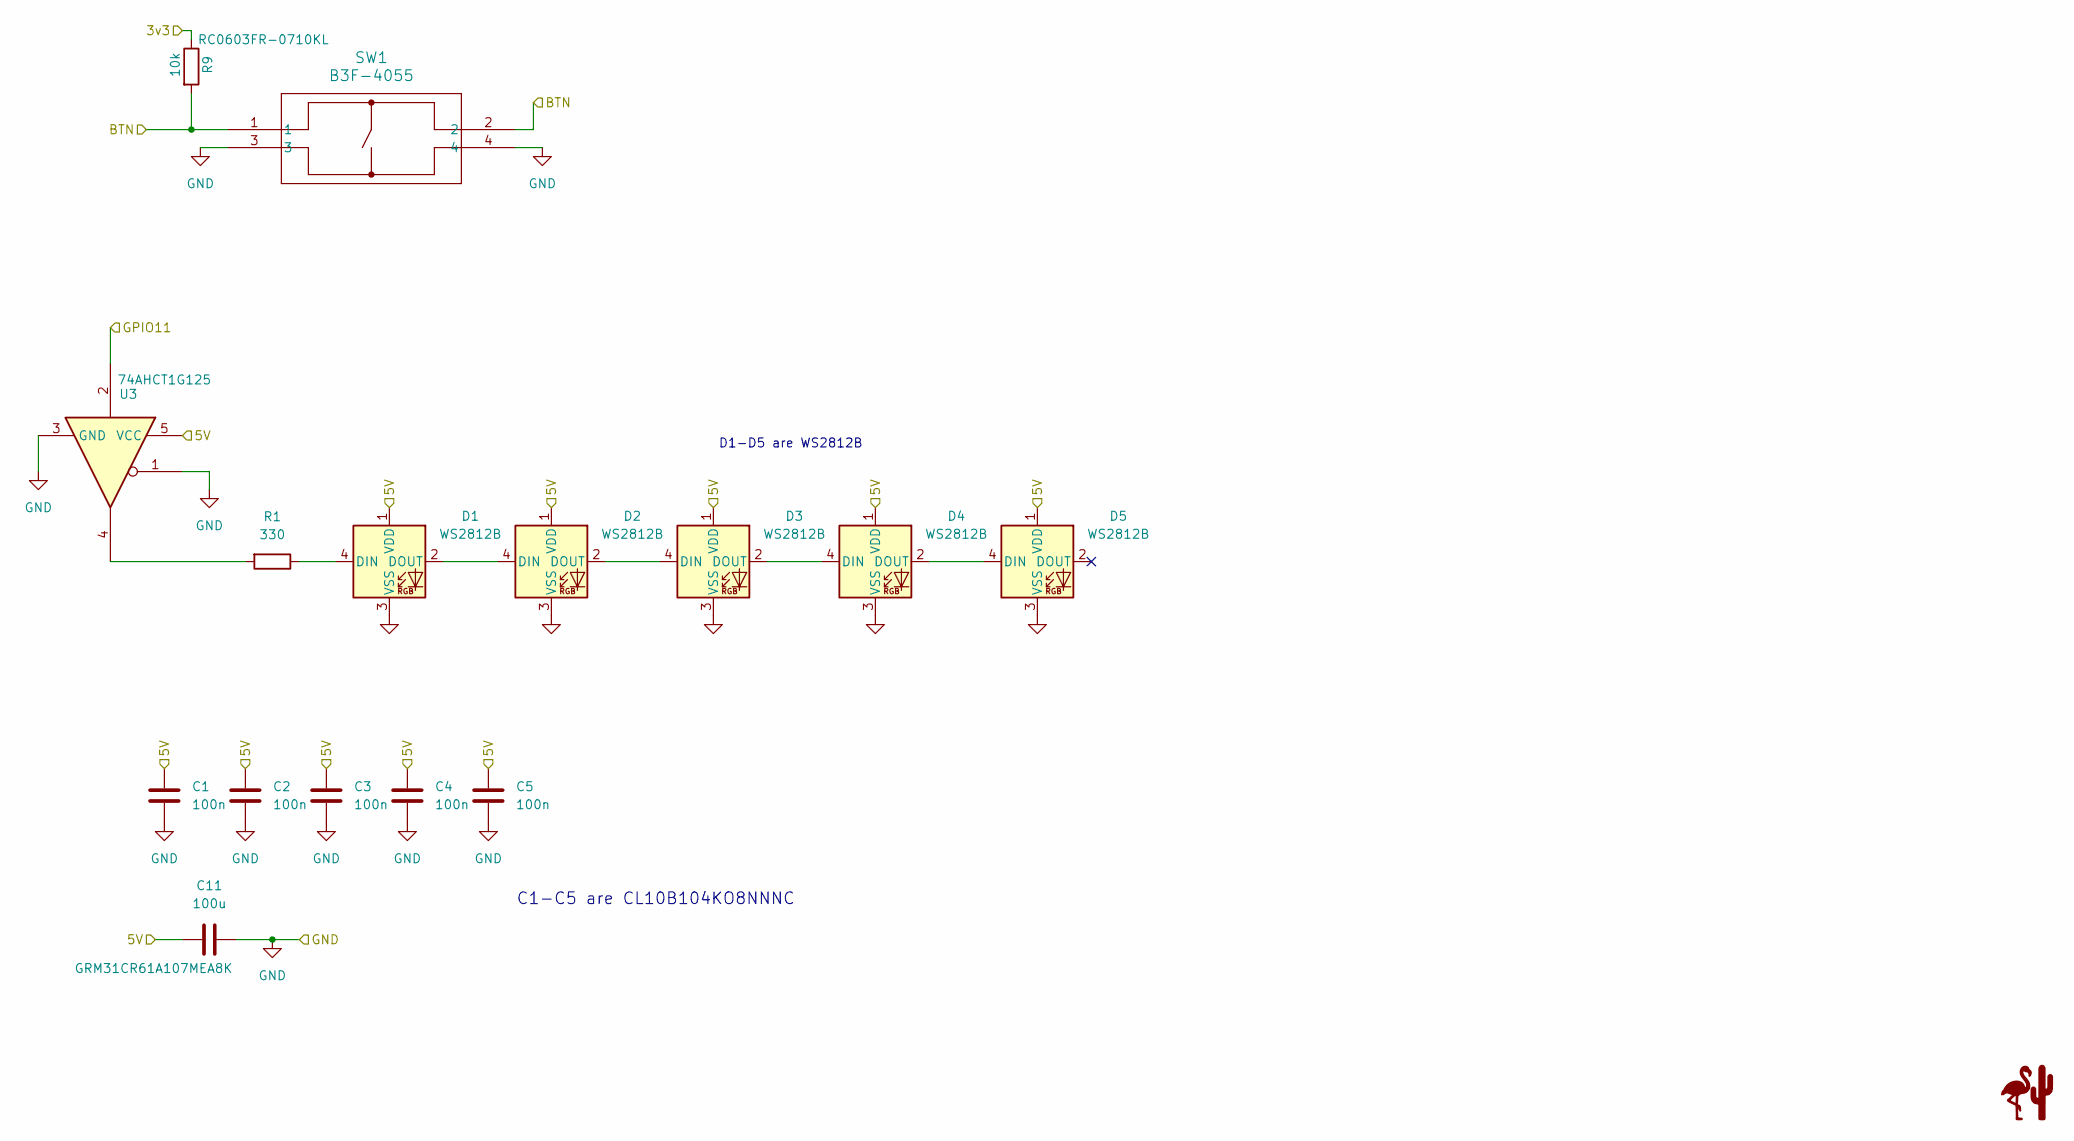
[picture p14: schematic User-Interface-Section.kicad_sch]

Parts:
C1, C2, C3, C4, C5: 100n; C_0603_1608Metric; MPN CL10B104KO8NNNC
C11: 100u; C_1206_3216Metric; MPN GRM31CR61A107MEA8K
D1, D2, D3, D4, D5: WS2812B; LED_WS2812B_PLCC4_5.0x5.0mm_P3.2mm; MPN WS2812B
R1: 330; R_0603_1608Metric; MPN RC0603FR-07330RL
R9: 10k; R_0603_1608Metric; MPN RC0603FR-0710KL
SW1: B3F-4055; SW_B3F-4050_OMR; MPN B3F-4055
U3: 74AHCT1G125; SOT-23-5; MPN SN74AHCT1G125DBVR

Connections:
/Control-Section/3v3: R9.1; also elsewhere on the board
/Control-Section/5V: C1.1, C2.1, C3.1, C4.1, C5.1, C11.1, D1.1 (VDD), D2.1 (VDD), D3.1 (VDD), D4.1 (VDD), D5.1 (VDD), U3.5 (VCC); also elsewhere on the board
/Control-Section/BTN: R9.2, SW1.1, SW1.2; also elsewhere on the board
/Control-Section/GPIO11: U3.2; also elsewhere on the board
GND: C1.2, C2.2, C3.2, C4.2, C5.2, C11.2, D1.3 (VSS), D2.3 (VSS), D3.3 (VSS), D4.3 (VSS), D5.3 (VSS), SW1.3, SW1.4, U3.1, U3.3 (GND); also elsewhere on the board
unnamed: D1.4 (DIN), R1.1
unnamed: D1.2 (DOUT), D2.4 (DIN)
unnamed: D2.2 (DOUT), D3.4 (DIN)
unnamed: D3.2 (DOUT), D4.4 (DIN)
unnamed: D4.2 (DOUT), D5.4 (DIN)
unnamed: R1.2, U3.4

Notes on the sheet:
D1-D5 are WS2812B
C1-C5 are CL10B104KO8NNNC

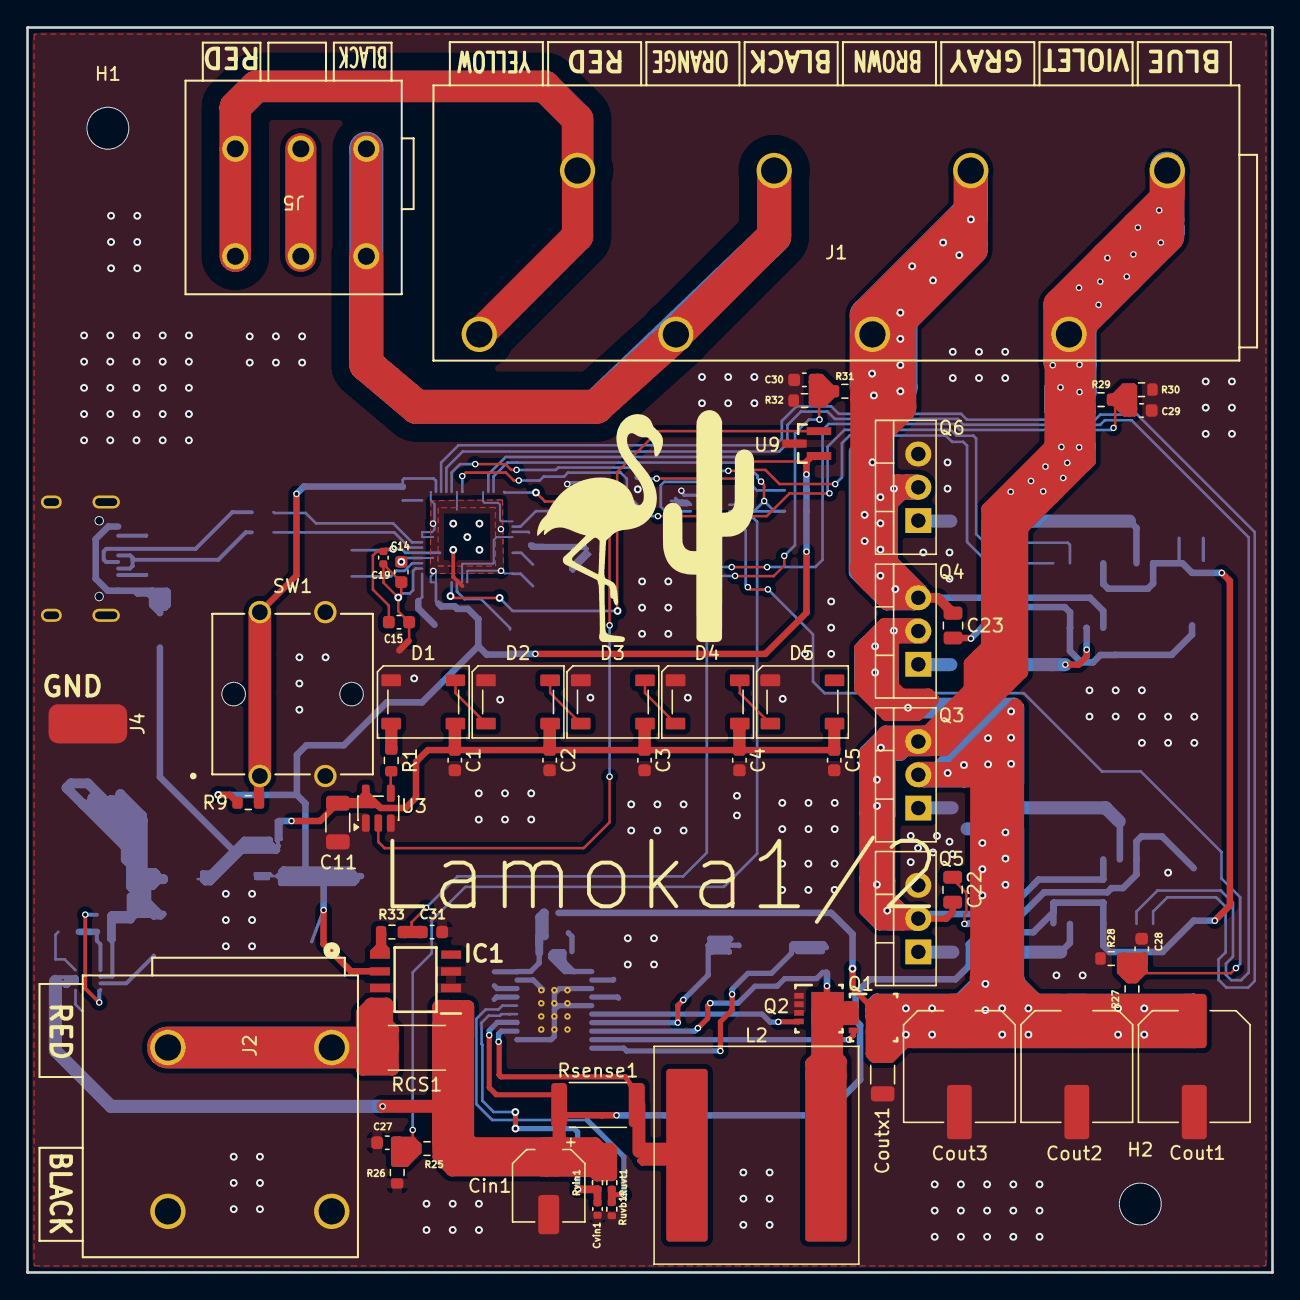
[picture p15: board Lamoka1-half.kicad_pcb from above]

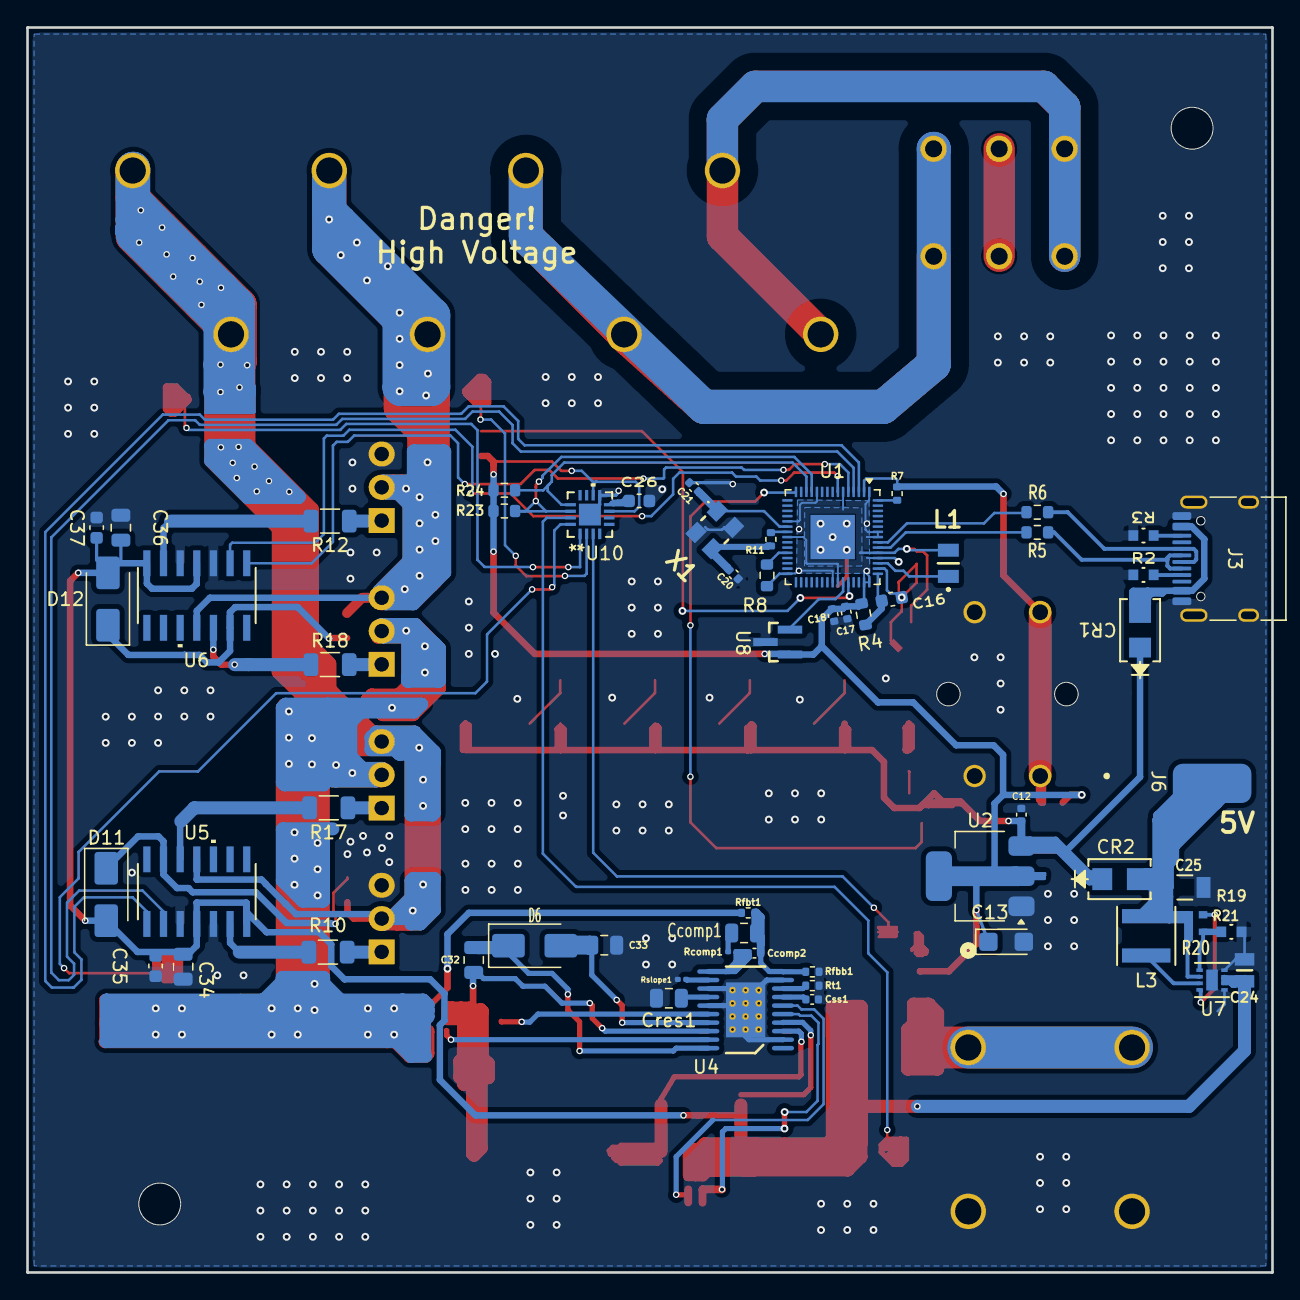
[picture p16: board Lamoka1-half.kicad_pcb from below]

Board: 2 copper layers, 95.0 x 95.0 mm, 121 parts (60 on the bottom side), 79 nets.
