bearjhartjen/Lamoka1-half/(commit log)

2026-10-27 Moving all Lamoka1/2 stuff to this new dedicated repository
    [Control-section.kicad_sch, Inversion-section.kicad_sch, Lamoka1-DEV-Brain.stl, Lamoka1-half BOM.csv, Lamoka1-half Pick and Place (SUPERSEDED - no LEDs, DNP J1 J2 D1-D5).csv, Lamoka1-half Pick and Place (assembly, DNP J1 J2).csv, Lamoka1-half Pick and Place bottom.csv, Lamoka1-half Pick and Place top.csv]
2026-10-29 General improvement
    [Lamoka1-DEV-Brain.stl]
2026-10-30 ADD a ton of stuff and improve this repo in general
    [BOM_Lamoka1-half_turnkey_FIXED.csv, Lamoka1-half BOM.csv, Lamoka1-half Pick and Place (SUPERSEDED - no LEDs, DNP J1 J2 D1-D5).csv, Lamoka1-half Pick and Place (assembly, DNP J1 J2).csv, Lamoka1-half Pick and Place bottom.csv, Lamoka1-half Pick and Place top.csv, Lamoka1-half Pick and Place.csv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]
2026-11-02 Making it proper with HAL lead free copper for PCB renders
    [Lamoka1-half.kicad_pcb]
2026-11-03 ADD schematic to repo
2026-11-03 ADD PCBWay BOM that was sent back
    [T-1N14W1065266A-1units-BOM_Lamoka1-half_turnkey_FIXED(2026-11-02).xls]
2026-11-07 Update schems, update readme
    [Control-section.kicad_sch, Inversion-section.kicad_sch, Lamoka1-half.kicad_pcb, Lamoka1-half.kicad_sch, User-Interface-Section.kicad_sch]
